milars-z/Real-Time-Embedded-Programming/hardware/cad/README.md

# 3D Printing Integration

## Overview
This folder contains documentation for the 3D printing and hardware integration part of our real-time embedded programming project.

## Responsibility
Responsible team member: Dingyan Guo

My contribution includes:
- selecting a suitable open-source 3D model
- preparing the model for printing
- printing the required parts
- testing fitting and assembly

## Important Note
The robot arm model used in this project is based on the open-source **EEZYbotARM Mk2** project.
It is not claimed as original CAD work by our team.
Please see `SOURCE.md` for attribution details.

STL files are stored in `hardware/STL/`, and 3MF files are stored in `hardware/3mf/`.

## Folder Contents
- `README.md` — overview of the 3D printing integration work
- `SOURCE.md` — source and attribution details
