milars-z/Real-Time-Embedded-Programming/src/CameraYolo/readme.md

## Test
Use *.exe test CameraTest\test.jpg CameraTest\yolov8n.onnx CameraTest\classes.txt to test the program with a single picture.
has different modes : test/camera/video.
video/camera haven't been tested.

## V2.0
YOLO version occupies too much memory, temporarily abandoned
YoloDetector.cpp
YoloDetector.h
model/yolov8n.onnx
model/yolov8n.pt
model/classes.txt
