milars-z/Real-Time-Embedded-Programming/hardware/cad/SOURCE.md

# Source Attribution

This project uses the open-source **EEZYbotARM Mk2** model as part of the hardware implementation.

## Original Source
- Project name: EEZYbotARM Mk2 - 3D Printed Robot
- Source page: https://www.instructables.com/EEZYbotARM-Mk2-3D-Printed-Robot/
- Original creator: theGHIZmo / daGHIZmo
- Original platform: Thingiverse
- Licence: CC BY-NC
- Attribution note: please follow the original licence and provide attribution

## Use in This Project
This model is not claimed as original modelling work by our team.
It is used for educational and non-commercial coursework purposes.

## My Contribution
My work in this part included:
- sourcing and evaluating the open-source model
- preparing files for printing
- carrying out 3D printing
- checking fitting and assembly
- documenting the use of the model in the project
