milars-z/Real-Time-Embedded-Programming/docs/IK/Inverse motion algorithm.docx

1) Assumed Robot Arm Type (Most Common 4‑DOF Layout)

This document assumes a very common 4‑DOF serial arm used in many 3D‑printed projects:
• Motor 1: Base rotation (Yaw)
• Motor 2: Shoulder joint (Pitch)
• Motor 3: Elbow joint (Pitch)
• Motor 4: Wrist joint (Pitch) to control the end‑effector tilt

The usual IK trick is to split 3D into:
• A base yaw angle θ1 (turn toward the target in the XY plane)
• A 2D planar IK problem in a vertical plane (r–z plane) for θ2 and θ3
• A wrist angle θ4 to achieve the desired tool pitch

2) Required Geometry Parameters (Measure or Take from CAD)

Define the target point in the base coordinate frame as P = (x, y, z).

You need these arm parameters:
• d0: vertical offset from base origin to the shoulder axis (height)
• a0: horizontal offset from base rotation axis to shoulder axis (often 0)
• L1: length from shoulder → elbow
• L2: length from elbow → wrist
• L3: length from wrist → tool tip (tool offset). If the tool tip is at the wrist axis, L3 = 0.

Optional (orientation): choose an end‑effector pitch angle φ in the arm’s vertical plane.
If you only need to reach the point (no orientation control), you can set φ to a constant (e.g., keep the tool level).

3) Step‑by‑Step IK (Equations)

3.1 Base yaw (Motor 1)

Compute base rotation so the arm faces the target:
θ1 = atan2(y, x)

Horizontal distance to the target:
r = sqrt(x^2 + y^2)

Convert to shoulder‑frame distances (accounting for offsets):
rs = r − a0
zs = z − d0

3.2 Wrist center (optional, if tool length L3 and desired pitch φ)

If the tool tip is offset from the wrist by L3 and you want pitch φ, solve for the wrist center:
rw = rs − L3·cos(φ)
zw = zs − L3·sin(φ)

If L3 = 0 or orientation is ignored, use:
rw = rs, zw = zs

3.3 Shoulder + elbow (Motors 2 and 3): 2‑link planar IK in the r–z plane

Compute:
D = (rw^2 + zw^2 − L1^2 − L2^2) / (2·L1·L2)

Reachability check:
If |D| > 1, the target is unreachable for the given link lengths (too far or too close).

Elbow angle (two solutions: elbow‑down vs elbow‑up):
θ3 = atan2( ±sqrt(1 − D^2), D )

Shoulder angle:
θ2 = atan2(zw, rw) − atan2( L2·sin(θ3), L1 + L2·cos(θ3) )

3.4 Wrist pitch (Motor 4)

If you want the end‑effector pitch to be φ:
θ4 = φ − (θ2 + θ3)

If you do not control orientation, θ4 can be fixed or used for a simple “keep level” rule.

4) Practical Implementation Notes (Real Robots)

1) Angle directions and zero offsets differ per build.
A typical conversion is: θ_motor = s·θ + θ_offset, where s is +1 or −1.

2) Joint limits: reject or clamp solutions that exceed servo/motor limits.

3) Elbow‑up vs elbow‑down: compute both (±) solutions and choose the one that:
• stays within joint limits, and/or
• requires the smallest change from the current joint angles.

4) Units: IK uses radians. Convert to degrees if your motor commands use degrees:
degrees = radians · (180 / π)

5) Minimal Pseudocode

Inputs: x,y,z, link lengths d0,a0,L1,L2,L3, desired pitch phi

theta1 = atan2(y, x)
r = sqrt(x^2 + y^2)
rs = r - a0
zs = z - d0

rw = rs - L3*cos(phi)
zw = zs - L3*sin(phi)

D = (rw^2 + zw^2 - L1^2 - L2^2) / (2*L1*L2)
if abs(D) > 1: unreachable

theta3 = atan2(+sqrt(1-D^2), D) # elbow-down (also try -sqrt for elbow-up)
theta2 = atan2(zw, rw) - atan2(L2*sin(theta3), L1 + L2*cos(theta3))

theta4 = phi - (theta2 + theta3)

return theta1, theta2, theta3, theta4
