milars-z/Real-Time-Embedded-Programming/docs/pitch_presentation/pitch_real.pptx

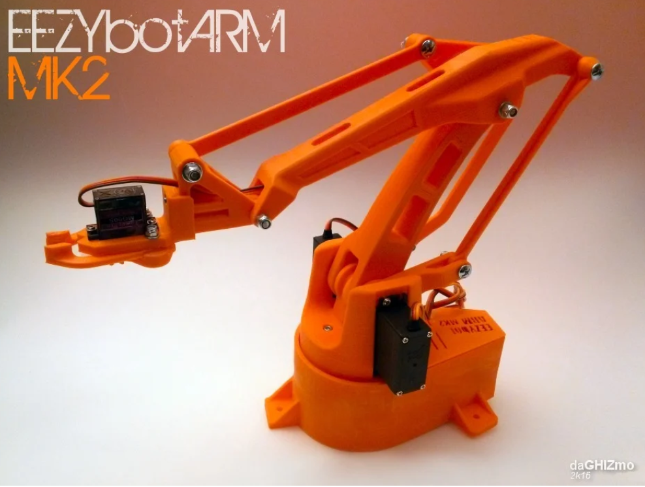
[picture p10: figure]

Computer Vision for object learning and retrieval

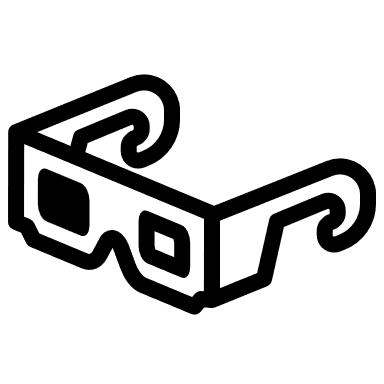
[picture p11: figure]
3D 眼镜 纯色填充

Voice Recognition for user commands

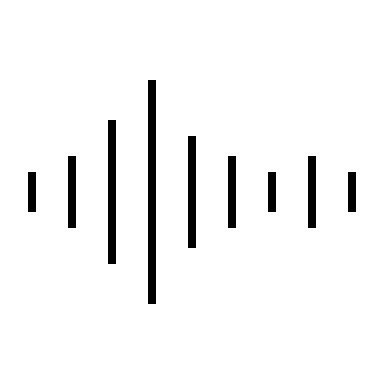
[picture p12: figure]
语音 轮廓

AI Engine for feature extraction

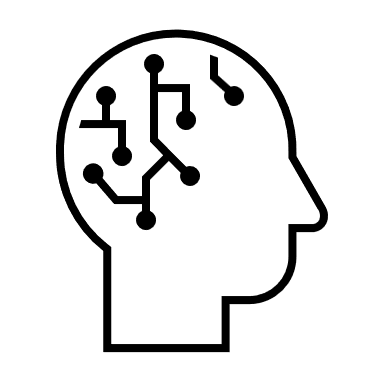
[picture p13: figure]
人工智能 轮廓

File System for learning

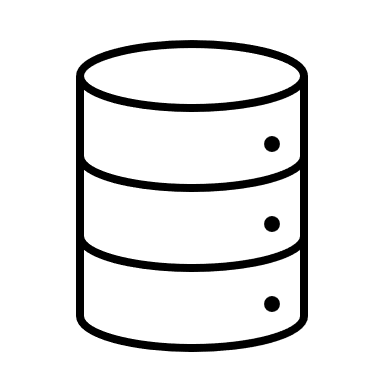
[picture p14: figure]
数据库 轮廓

Team 19

CogniArm

Ziyin Zeng(3113788Z) Shantong Wang(3108877W) Longyi Chen(3169503C) Dingyan Guo(3075250G)
Hang Liu(3075147L)

## Slide 2

Real-time system

Multithread

Hardware Control

Vision|Voice

SQL | Knowledge

…..

CogniArm: Evolution from Control to Cognition

Stage 1. Traditional motion

C++ Real-time Kernel & IK

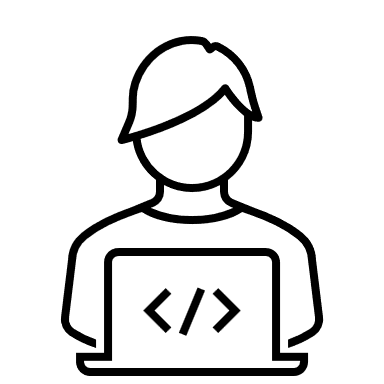
[picture p15: figure]
男程序员 轮廓

Stage 2. Intelligent Interaction

Async Voice Command Processing

Stage 3. Cognitive Perception

Vision-Voice & Learning

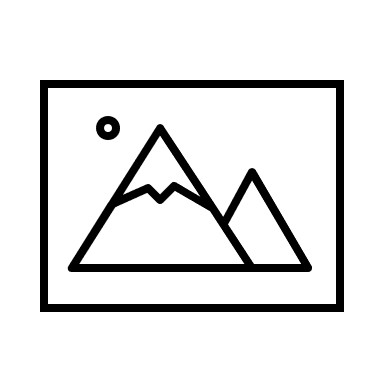
[picture p16: figure]
图像 轮廓
