milars-z/Real-Time-Embedded-Programming/docs/Project_Planning/CogniArm _Project_Analysis.docx

CogniArm: A Learnable Robotic Arm System

This project focuses on the research and design of a learnable robotic arm.

System Architecture:

Vision Module: Identifies image features.

Speech Recognition Module: Recognizes user commands and extracts keywords to generate mechanical instructions or initiate visual searches.

File Management Module: Saves and manages pre-stored information groups.

AI Module: Assists vision and speech modules as a feature extraction engine.

Control Module: Responsible for robotic arm control.

Stage 1 (01/28 – 02/15)

3D print and assemble the robotic arm demo; ensure it can be moved manually.

Reference:

EEZYbotARM Mk2 - 3D Printed Robot : 8 Steps (with Pictures) - Instructables (https://www.instructables.com/EEZYbotARM-Mk2-3D-Printed-Robot/)

EEZYbotARM MK2 by daGHIZmo - Thingiverse (https://www.thingiverse.com/thing:1454048)

Implement robotic arm simulation via QT or other software (Python) to execute various movements through commands.

Basic embedded thread control and Raspberry Pi GPIO control.

Basic speech recognition: Convert speech to text vectors and extract keywords.

Basic image recognition: Provide data on recognition accuracy and minimum blurriness to ensure object matching.

Stage 2 (02/23 – 03/09)

Embedded deployment: Control the robotic arm via PC for directional movement and object grasping, with synchronous display in QT simulation.

Coordinate transformation and Inverse Kinematics (IK) processing.

Stage 3 (03/10 – 04/03)

Modify and re-print 3D models (Optional).

Voice recognition deployment: Control the robotic arm via voice commands for directional movement and object grasping, with synchronous display in QT simulation.

Image recognition deployment: Identify primary objects on the desk and match them with existing image data.

Stage 4

Learning deployment: Expand the file system, implement keyword retrieval and image vector storage.

Key Milestones:

Before Lunar New Year: Complete demo testing to ensure physical movement.

Early March: Complete embedded deployment to ensure standalone control without a PC.

Early April: Complete deployment of speech and image recognition.

Final Phase:

Focus on bug fixes, accuracy improvement, code standardization, and GitHub repository refinement. Concurrently conduct thesis writing. Synchronize DevLogs for each stage.

(Stage 4 development can be handled separately).
