milars-z/Real-Time-Embedded-Programming/docs/Project_Planning/CogniArm _项目分析.docx

CogniArm (认知手臂)

该项目主要研究并设计了一款可学习的机械臂

该项目文件组成为：视觉模块，语音识别模块，文件管理模块，AI模块与控制模块

语音识别模块主要用来识别用户指令，收集关键词生成机械指令或进行视觉检索。

视觉模块主要识别图像特征。学习模式需确定中心物品特征并保存到文件系统；识别模式需根据文件系统中存储的信息向量与图像中的物品信息向量进行匹配。

文件管理模块用来保存管理各种预存信息组。

AI模块辅助视觉与语音模块，进行特征提取引擎。

控制模块主要负责机械臂控制。

Stage 1. （01/28 – 02/15）

3D打印机械臂demo，完成组装，能用手移动机械臂

EEZYbotARM Mk2 - 3D Printed Robot : 8 Steps (with Pictures) - Instructables (https://www.instructables.com/EEZYbotARM-Mk2-3D-Printed-Robot/)

EEZYbotARM MK2 by daGHIZmo - Thingiverse (https://www.thingiverse.com/thing:1454048)

QT或其他模拟软件（python）实现机械臂仿真，通过指令实现机械臂各种动作

基础嵌入式线程控制，控制树莓派上的任意GPIO

基础语音识别，成功将语音转换为文字向量输出并提取关键词

基础图像识别，提供基础识别精准度，最低模糊度等数据，确保能进行物品识别匹配

Stage 2. （02/23 – 03/09）

嵌入式部署，可以通过PC段输出指令控制机械臂定向移动并进行物品抓取，QT模拟同步显示

坐标转换，逆运动学处理

Stage3. （03/10-04/03）

根据需求修改3D模型（选做）并重新打印

语音识别部署，通过语音指令控制机械臂定向移动并进行物品抓取，QT模拟同步显示

图像识别部署，摄像头能够判断桌面的主要物品，且能匹配已有的图像数据

Stage4.

学习部署，扩展文件系统，关键词检索，图像向量存储等

项目重要节点：

1. 年前完成demo的测试，确保实物能正常运动

2. 3月初完成嵌入式部署，确保能够脱离pc对机械臂进行操控

3. 4月初完成语音与图像识别部署

项目末期主要以完善bug，增加准确性，代码规范，github页面整改为主，同步进行论文撰写，stage4的开发可以忽略

每一阶段通过自媒体视频记录进度
