milars-z/Real-Time-Embedded-Programming/docs/hardware_config/hardware.xlsx

Sheet: Pinout
https://www.raspberrypi.com/documentation/computers/raspberry-pi.html#gpio

Sheet: MG90S
Orange | PWM | GPIO12
Red | 5V
Brown | GND

Sheet: 9865
GND | 6
SCL | 5 | GPIO3
SDA | 3 | GPIO2
VCC | 1 | 3.3V
