milars-z/Real-Time-Embedded-Programming/hardware/3mf/EBAmk2_002_mainarm.3mf

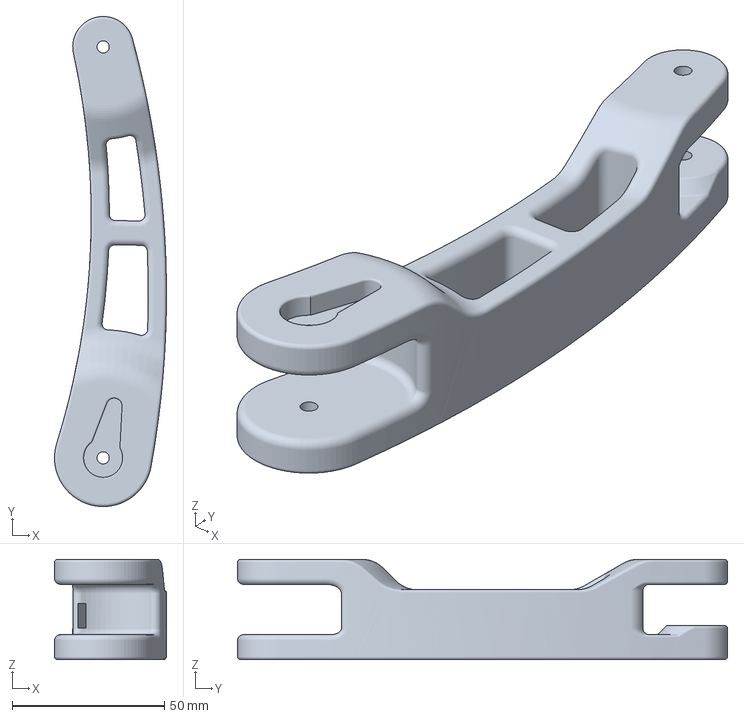
[picture p17: CAD file, 2026-04-19]
hardware/3mf/EBAmk2_002_mainarm.3mf
36.8 x 161.0 x 33.0 mm
