milars-z/Real-Time-Embedded-Programming/hardware/3mf/EBAmk2_012_mainbase.3mf

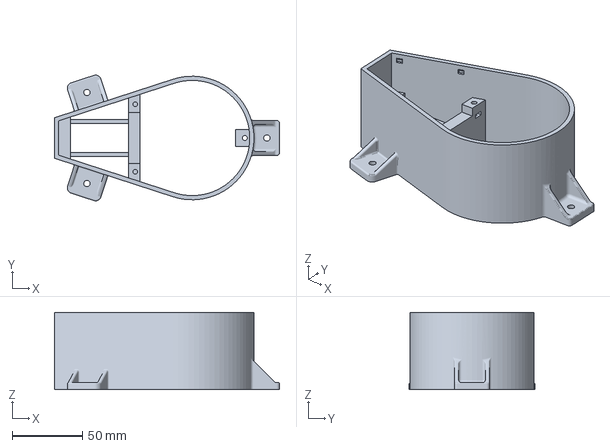
[picture p18: CAD file, 2026-04-19]
hardware/3mf/EBAmk2_012_mainbase.3mf
160.2 x 89.5 x 55.0 mm
