milars-z/Real-Time-Embedded-Programming/hardware/3mf/EBAmk2_011_gearmast_full.3mf

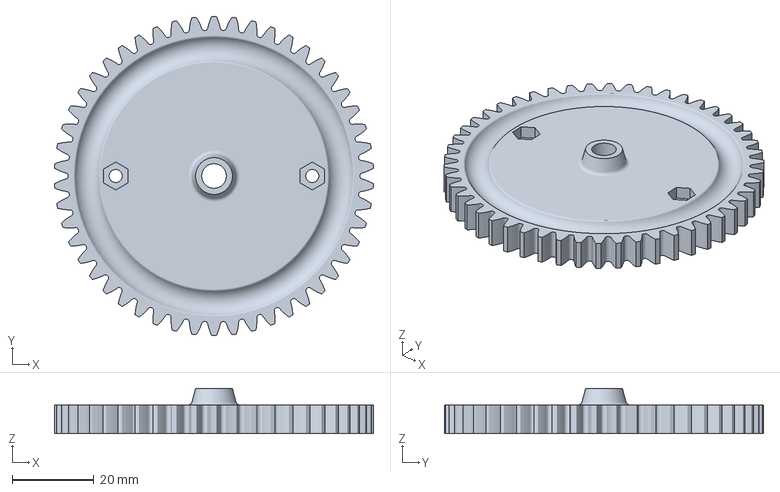
[picture p19: CAD file, 2026-04-19]
hardware/3mf/EBAmk2_011_gearmast_full.3mf
77.9 x 78.0 x 11.0 mm
