milars-z/Real-Time-Embedded-Programming/hardware/3mf/EBAmk2_010_gearservo_22DENTI.3mf

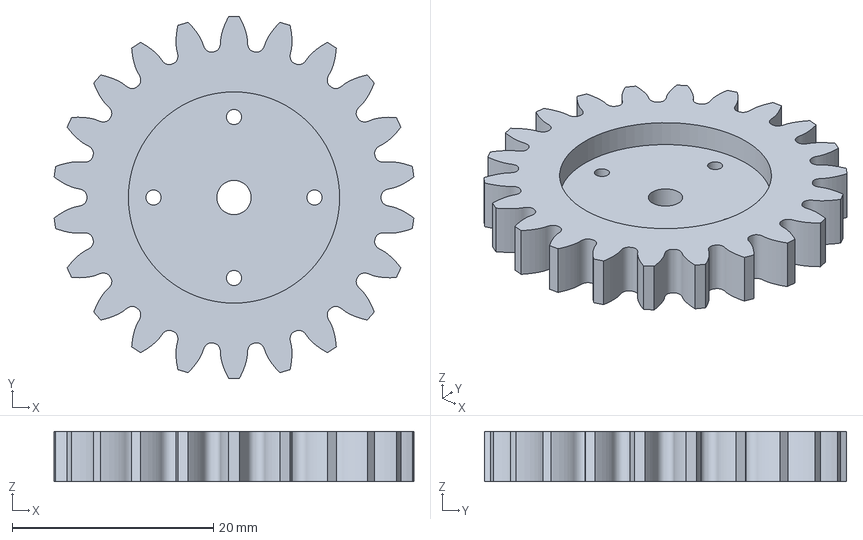
[picture p20: CAD file, 2026-04-19]
hardware/3mf/EBAmk2_010_gearservo_22DENTI.3mf
35.8 x 36.0 x 5.00 mm
