milars-z/Real-Time-Embedded-Programming/hardware/_3mf/EBAmk2.3mf

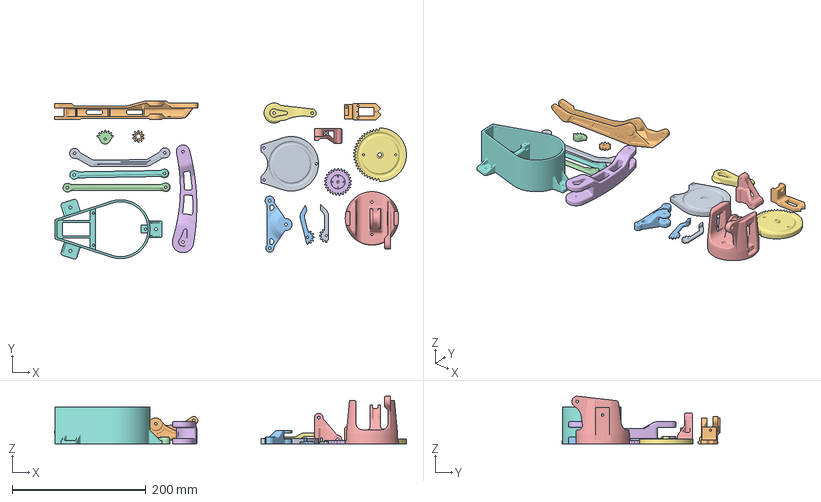
[picture p21: CAD file, 2026-04-20]
hardware/_3mf/EBAmk2.3mf
526.1 x 236.6 x 71.2 mm
EBAmk2_015_claw_finger_dx.STL
EBAmk2_016_claw_gear_drive.STL
EBAmk2_017_claw_finger_sx.STL
EBAmk2_018_claw_gear_driven.STL
EBAmk2_001_base.STL
EBAmk2_002_mainarm.STL
EBAmk2_003_varm.STL
EBAmk2_004_link135.STL
EBAmk2_005_link135angled.STL
EBAmk2_006_horarm__.STL
EBAmk2_007_trialink.STL
EBAmk2_008_link147_new.STL
EBAmk2_009_trialinkfront.STL
EBAmk2_010_gearservo.STL
EBAmk2_011_gearmast.STL
EBAmk2_012_mainbase.STL
EBAmk2_013_lower_base.STL
EBAmk2_014_claw_base.STL
