milars-z/Real-Time-Embedded-Programming/hardware/3mf/EBAmk2_006_horarm__.3mf

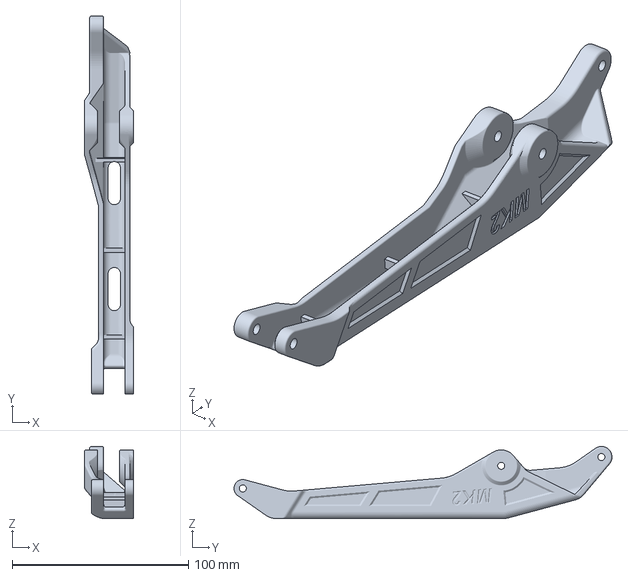
[picture p22: CAD file, 2026-04-19]
hardware/3mf/EBAmk2_006_horarm__.3mf
28.0 x 214.2 x 40.9 mm
