milars-z/Real-Time-Embedded-Programming/hardware/3mf/EBAmk2_004_link135.3mf

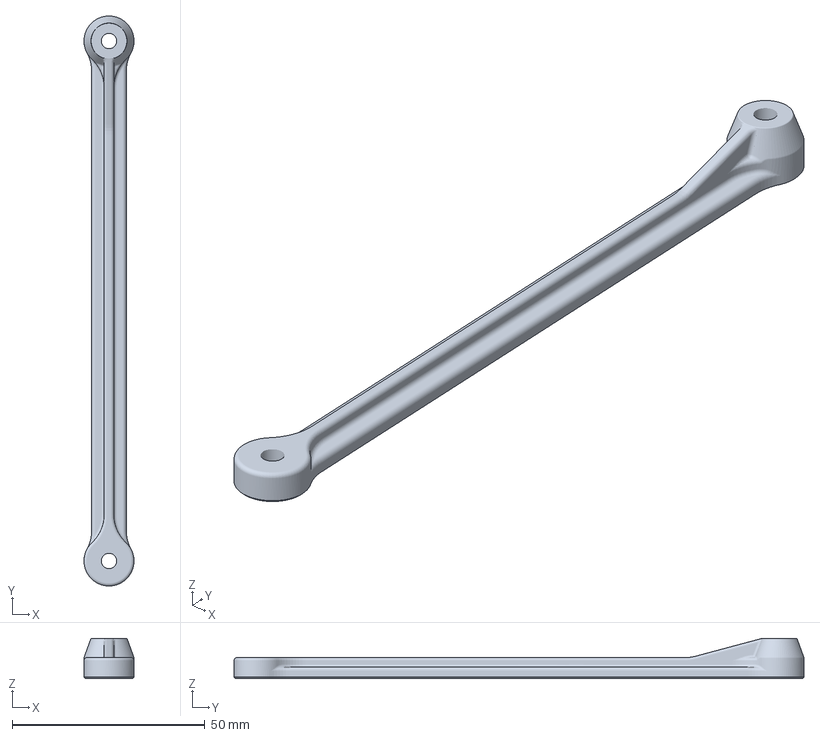
[picture p23: CAD file, 2026-04-19]
hardware/3mf/EBAmk2_004_link135.3mf
13.0 x 148.0 x 10.5 mm
