milars-z/Real-Time-Embedded-Programming/hardware/3mf/EBAmk2_001_base.3mf

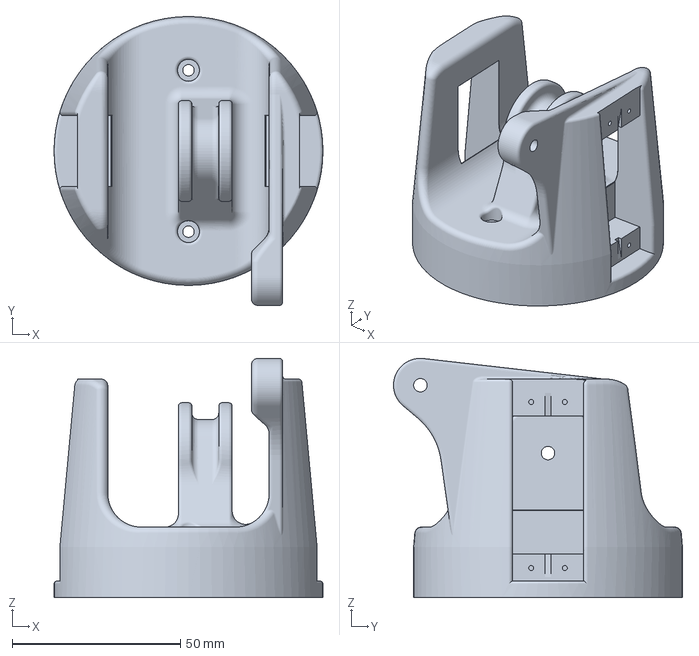
[picture p24: CAD file, 2026-04-19]
hardware/3mf/EBAmk2_001_base.3mf
80.0 x 86.0 x 71.2 mm
