milars-z/Real-Time-Embedded-Programming/hardware/3mf/EBAmk2_008_link147_new.3mf

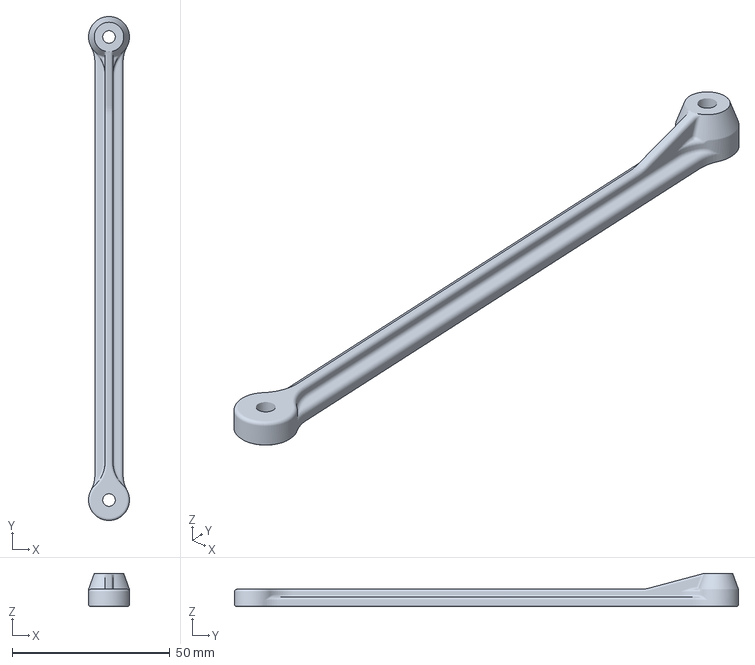
[picture p25: CAD file, 2026-04-19]
hardware/3mf/EBAmk2_008_link147_new.3mf
13.0 x 160.0 x 10.5 mm
