milars-z/Real-Time-Embedded-Programming/hardware/3mf/EBAmk2_013_lower_base.3mf

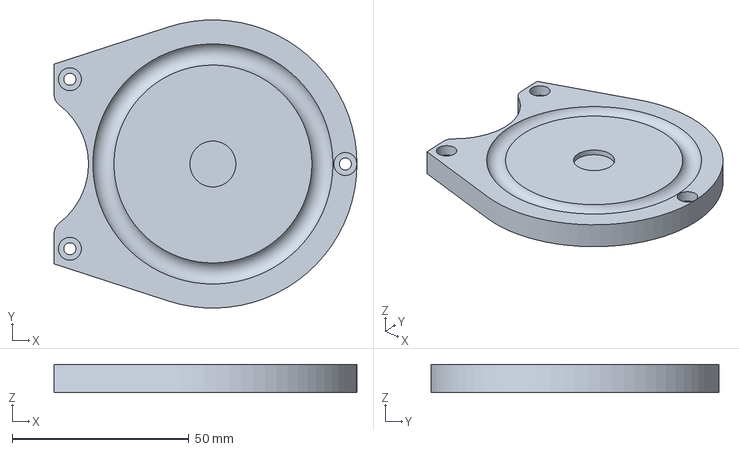
[picture p26: CAD file, 2026-04-19]
hardware/3mf/EBAmk2_013_lower_base.3mf
85.8 x 81.6 x 8.00 mm
