milars-z/Real-Time-Embedded-Programming/hardware/3mf/EBAmk2_006_horarm_plate.3mf

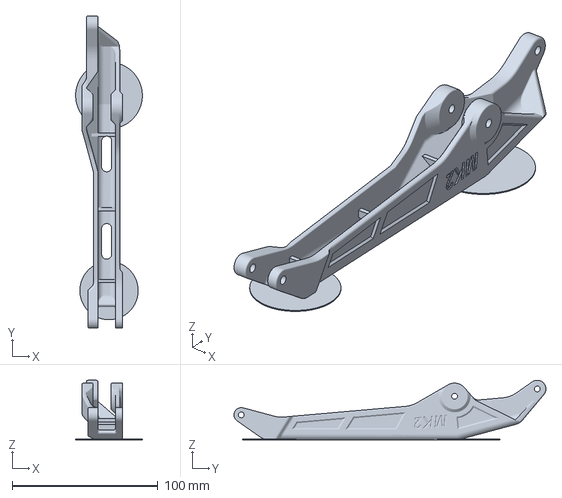
[picture p27: CAD file, 2026-04-19]
hardware/3mf/EBAmk2_006_horarm_plate.3mf
45.8 x 214.2 x 40.9 mm
