milars-z/Real-Time-Embedded-Programming/hardware/3mf/EBAmk2_019_drive_cover.3mf

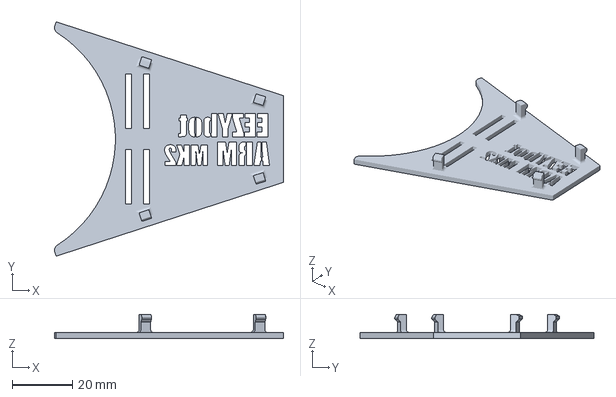
[picture p28: CAD file, 2026-04-19]
hardware/3mf/EBAmk2_019_drive_cover.3mf
76.3 x 78.1 x 8.00 mm
