milars-z/Real-Time-Embedded-Programming/hardware/3mf/EBAmk2_017_claw_finger_sx.3mf

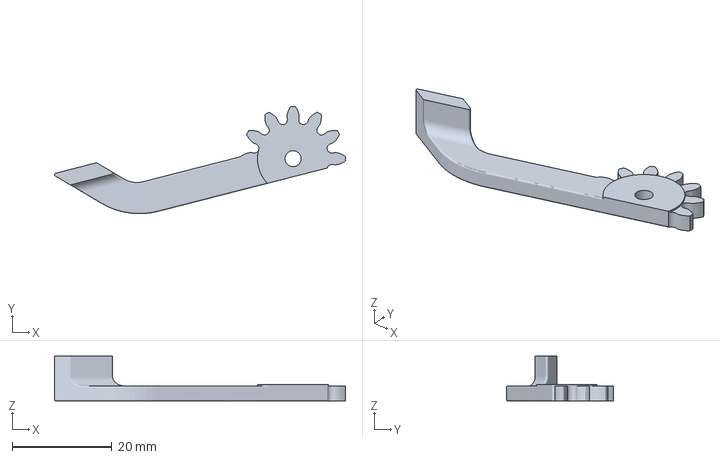
[picture p29: CAD file, 2026-04-19]
hardware/3mf/EBAmk2_017_claw_finger_sx.3mf
58.3 x 21.5 x 9.00 mm
