milars-z/Real-Time-Embedded-Programming/hardware/3mf/EBAmk2_009_trialinkfront.3mf

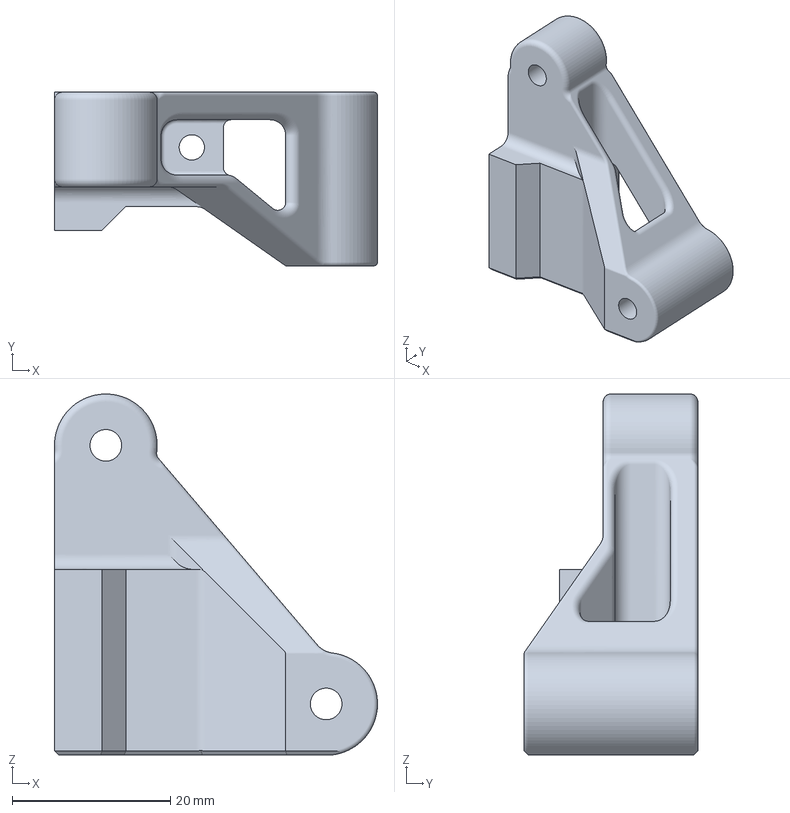
[picture p30: CAD file, 2026-04-19]
hardware/3mf/EBAmk2_009_trialinkfront.3mf
40.9 x 22.0 x 45.7 mm
