milars-z/Real-Time-Embedded-Programming/hardware/3mf/EBAmk2_005_link135angled.3mf

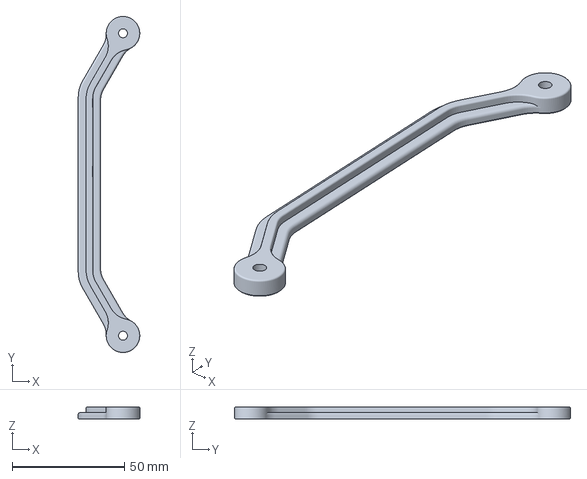
[picture p31: CAD file, 2026-04-19]
hardware/3mf/EBAmk2_005_link135angled.3mf
27.5 x 150.0 x 5.50 mm
