milars-z/Real-Time-Embedded-Programming/hardware/3mf/EBAmk2_015_claw_finger_dx.3mf

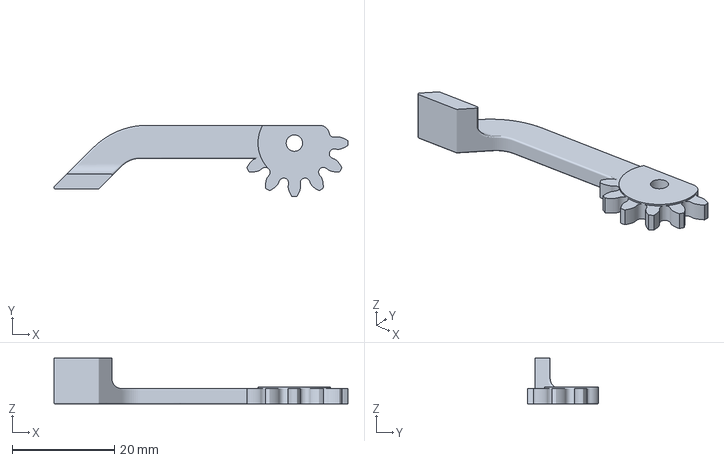
[picture p32: CAD file, 2026-04-19]
hardware/3mf/EBAmk2_015_claw_finger_dx.3mf
57.6 x 14.0 x 9.00 mm
