milars-z/Real-Time-Embedded-Programming/hardware/3mf/EBAmk2_003_varm.3mf

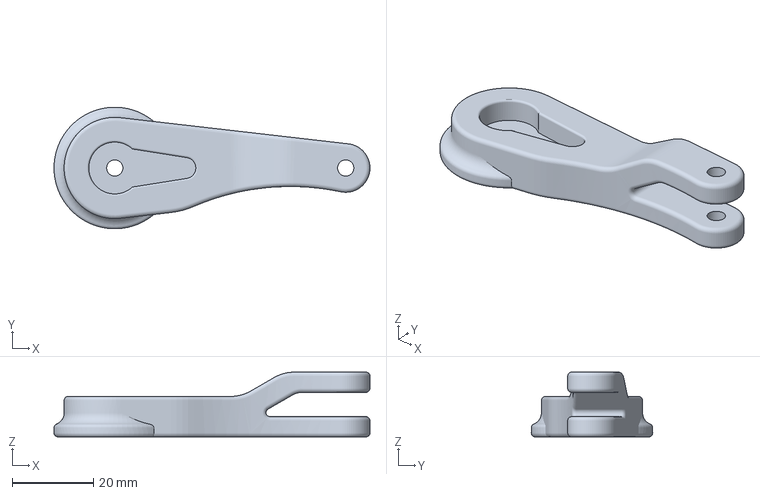
[picture p33: CAD file, 2026-04-19]
hardware/3mf/EBAmk2_003_varm.3mf
78.0 x 30.0 x 16.0 mm
