milars-z/Real-Time-Embedded-Programming/hardware/3mf/EBAmk2_007_trialink.3mf

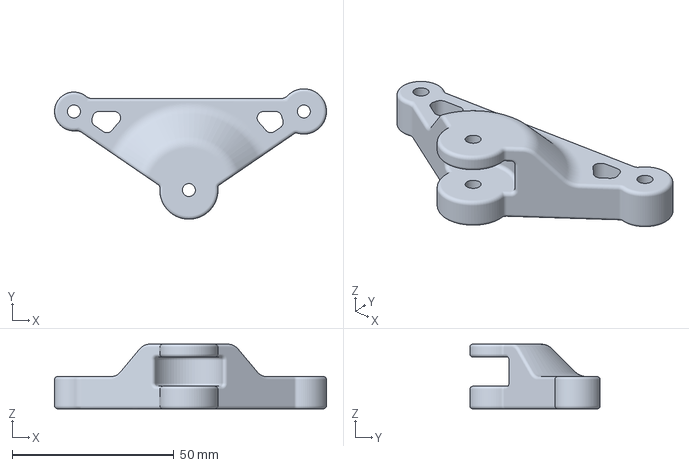
[picture p34: CAD file, 2026-04-19]
hardware/3mf/EBAmk2_007_trialink.3mf
84.0 x 40.3 x 20.0 mm
