milars-z/Real-Time-Embedded-Programming/hardware/3mf/EBAmk2_011_gearmast.3mf

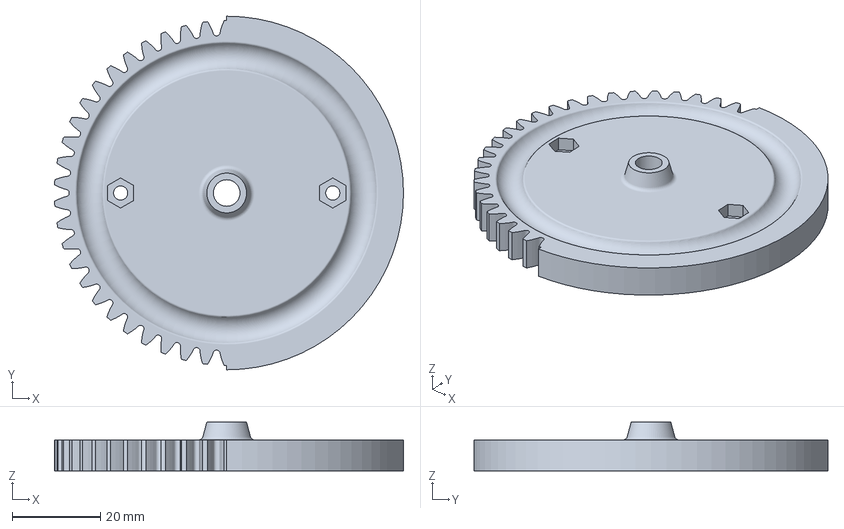
[picture p35: CAD file, 2026-04-19]
hardware/3mf/EBAmk2_011_gearmast.3mf
79.0 x 80.0 x 11.0 mm
