milars-z/Real-Time-Embedded-Programming/hardware/3mf/EBAmk2_010_gearservo.3mf

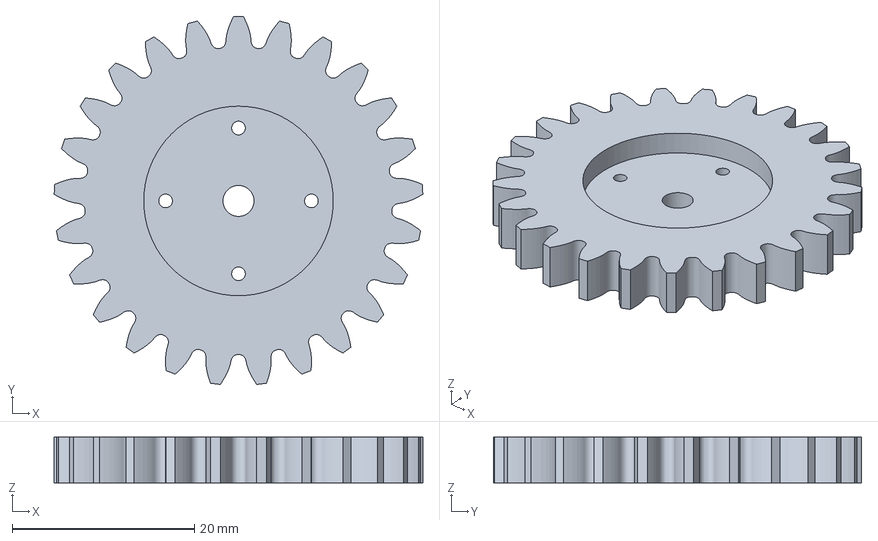
[picture p36: CAD file, 2026-04-19]
hardware/3mf/EBAmk2_010_gearservo.3mf
40.5 x 40.4 x 5.00 mm
