milars-z/Real-Time-Embedded-Programming/hardware/3mf/EBAmk2_016_claw_gear_drive.3mf

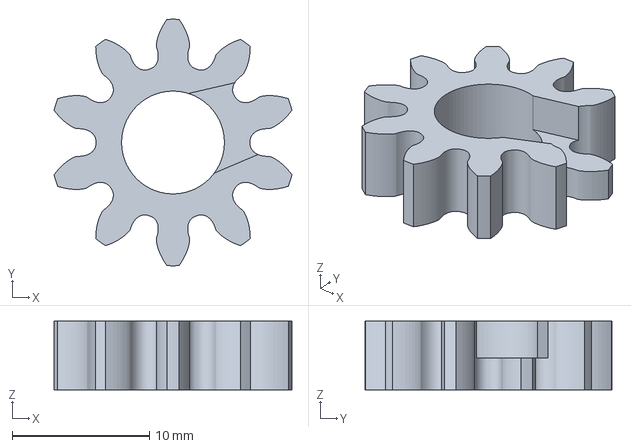
[picture p37: CAD file, 2026-04-19]
hardware/3mf/EBAmk2_016_claw_gear_drive.3mf
17.4 x 18.0 x 5.00 mm
