milars-z/Real-Time-Embedded-Programming/hardware/3mf/EBAmk2_018_claw_gear_driven.3mf

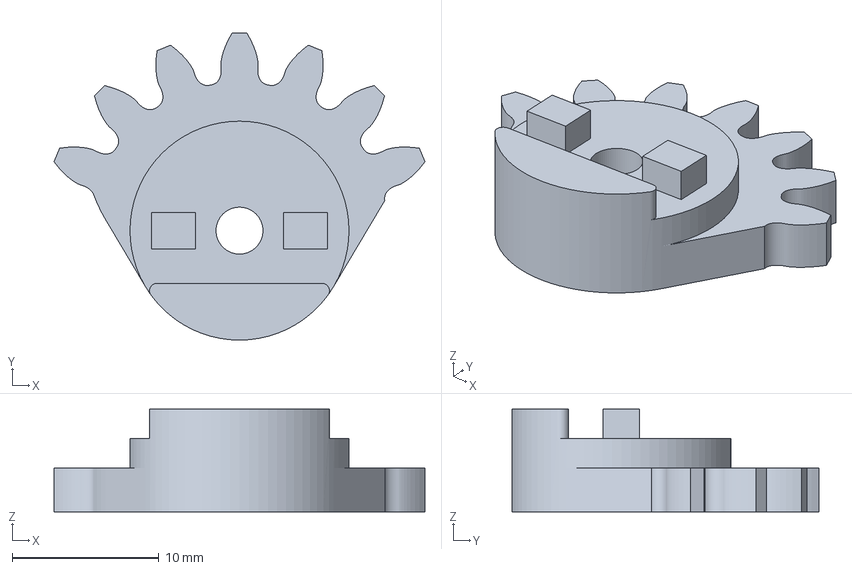
[picture p38: CAD file, 2026-04-19]
hardware/3mf/EBAmk2_018_claw_gear_driven.3mf
25.3 x 21.0 x 7.00 mm
