milars-z/Real-Time-Embedded-Programming/hardware/3mf/EBAmk2_014_claw_base.3mf

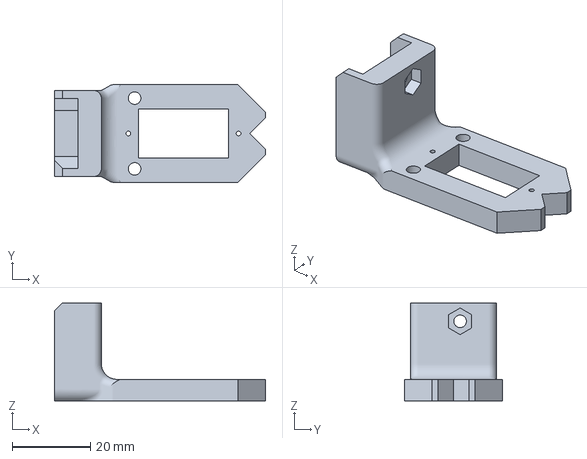
[picture p39: CAD file, 2026-04-19]
hardware/3mf/EBAmk2_014_claw_base.3mf
54.0 x 25.0 x 25.0 mm
