milars-z/Real-Time-Embedded-Programming/docs/test_data/speaker_test.txt

hello
hello
hello
what is your name
hello i am your robots
hello i am your robots
hello i am your robots
today is sunday
do motion hello
hello good morning milars
hello good morning milars
hello good morning milars
hello good morning milars
hello good morning milars
hello good morning milars
please update background first
please update background first
please update background first
background update successfully
background update successfully
background update successfully
learn object can successfully
learn object can successfully
learn object can successfully
learn object can successfully
learn object can successfully
learn object can successfully
i know how to dance
i know how to dance
i know how to hello
i know how to hello
i know how to fly
good bye milars
good bye milars
good bye milars
sorry i didn't understand that
sorry i didn't understand that
sorry i didn't understand that
sorry i didn't understand that
sorry i didn't understand that
sorry i didn't understand that
hello
hello
hello
what is your name
hello i am your robots
hello i am your robots
hello i am your robots
today is sunday
do motion hello
hello good morning milars
hello good morning milars
hello good morning milars
hello good morning milars
hello good morning milars
hello good morning milars
please update background first
please update background first
please update background first
background update successfully
background update successfully
background update successfully
learn object can successfully
learn object can successfully
learn object can successfully
learn object can successfully
learn object can successfully
learn object can successfully
i know how to dance
i know how to dance
i know how to hello
i know how to hello
i know how to fly
good bye milars
good bye milars
good bye milars
sorry i didn't understand that
sorry i didn't understand that
sorry i didn't understand that
sorry i didn't understand that
sorry i didn't understand that
sorry i didn't understand that
hello
hello
hello
what is your name
hello i am your robots
hello i am your robots
hello i am your robots
today is sunday
do motion hello
hello good morning milars
hello good morning milars
hello good morning milars
hello good morning milars
hello good morning milars
hello good morning milars
please update background first
please update background first
please update background first
background update successfully
background update successfully
background update successfully
learn object can successfully
learn object can successfully
learn object can successfully
learn object can successfully
learn object can successfully
learn object can successfully
i know how to dance
i know how to dance
i know how to hello
i know how to hello
i know how to fly
good bye milars
good bye milars
good bye milars
sorry i didn't understand that
sorry i didn't understand that
sorry i didn't understand that
sorry i didn't understand that
sorry i didn't understand that
sorry i didn't understand that
