milars-z/Real-Time-Embedded-Programming/docs/test_data/Analysis.xlsx

Sheet: 2026-04-15
TaskID | Module | Type | TargetName | Duration(ms) | issuccess | Module | Average Duration | Peak Duration | P90 | Sample Count | Shortest Duration
1000 | Camera | Update | None | 48.62 |  | Camera | 35.12214815 | 60.99 | 52.082
1001 | Camera | Learn | ll | 60.99 |  | STT | 12.89689706 | 49.406 | 27.482
1002 | Camera | Detecte | ll | 49.96 |  | TTS | 988.8116181 | 21541.443 | 1263.5207 | 254 | 381.02
1003 | Camera | Detecte | ll | 39.27 |  | Screen-Motion | 64.41575758 | 72.281 | 67.7795
1004 | Camera | Detecte | oo | 48.09 |  | Nlu | 173.2652905 | 7062.549 | 80.1568
1000 | Camera | Update | None | 57.91
1001 | Camera | Update | None | 28.382
1002 | Camera | Update | None | 27.925
1003 | Camera | Learn | yy | 55.265
1004 | Camera | Learn | yy | 29.616
1005 | Camera | Detecte | yy | 26.981
1006 | Camera | Detecte | yy | 30.372
1007 | Camera | Detecte | yy | 28.96
1008 | Camera | Detecte | yy | 31.732
1009 | Camera | Detecte | yy | 30.895
1010 | Camera | Detecte | yy | 26.257
1011 | Camera | Detecte | yy | 30.252
1012 | Camera | Detecte | yy | 32.04
1013 | Camera | Detecte | yy | 27.314
1014 | Camera | Detecte | yy | 31.079
1000 | Camera | Update | None | 26.853 | 1
1001 | Camera | Detecte | uu | 33.148 | 0
1002 | Camera | Detecte | uu | 31.796 | 0
1003 | Camera | Update | None | 25.967 | 1
1004 | Camera | Detecte | uu | 28.46 | 1
1005 | Camera | Learn | gg | 27.483 | 1
1006 | Camera | Detecte | gg | 32.681 | 1
4002 | Microphone | STT | hello | 49.406 | 1
4820 | Microphone | STT | you in system | 48.336 | 1
4146 | Microphone | STT | you that she was his movies | 40.211 | 1
4319 | Microphone | STT | maggie | 32.214 | 1
4688 | Microphone | STT | yeah | 30.478 | 1
4012 | Microphone | STT | she was | 29.74 | 1
4440 | Microphone | STT | that's right before | 27.601 | 1
4016 | Microphone | STT | some bitterness | 27.431 | 1
4674 | Microphone | STT | guy | 26.797 | 1
4147 | Microphone | STT | the soon | 26.558 | 1
4045 | Microphone | STT | me | 26.51 | 1
4682 | Microphone | STT | man | 25.939 | 1
4196 | Microphone | STT | years | 25.914 | 1
4704 | Microphone | STT | yes | 24.972 | 1
4534 | Microphone | STT | yeah | 24.707 | 1
4168 | Microphone | STT | and | 24.359 | 1
4180 | Microphone | STT | the | 23.989 | 1
4006 | Microphone | STT | yeah | 22.27 | 1
4153 | Microphone | STT | the | 22.095 | 1
4093 | Microphone | STT | stop | 20.878 | 1
4127 | Microphone | STT | for | 19.16 | 1
4040 | Microphone | STT | amy | 18.485 | 1
4090 | Microphone | STT | the | 16.774 | 1
4237 | Microphone | STT | still | 15.011 | 1
4155 | Microphone | STT | the | 14.757 | 1
4022 | Microphone | STT | grab one | 14.33 | 1
4004 | Microphone | STT | are | 13.276 | 1
4060 | Microphone | STT | promotion towns | 10.958 | 1
4011 | Microphone | STT | this | 9.375 | 1
4044 | Microphone | STT | he | 9.344 | 1
4025 | Microphone | STT | so my name | 8.999 | 1
4012 | Microphone | STT | hello hello | 8.279 | 1
4434 | Microphone | STT | hello | 7.956 | 1
4012 | Microphone | STT | hello | 7.804 | 1
4006 | Microphone | STT | hello hello | 7.472 | 1
4149 | Microphone | STT | there's still time to | 7.083 | 1
4079 | Microphone | STT | right | 6.958 | 1
4010 | Microphone | STT | hello hello | 6.022 | 1
4014 | Microphone | STT | hello | 6.014 | 1
4603 | Microphone | STT | oh | 5.986 | 1
4013 | Microphone | STT | hello | 5.339 | 1
4017 | Microphone | STT | goodbye | 5.235 | 1
4001 | Microphone | STT | what's your name | 4.832 | 1
4007 | Microphone | STT | hello | 4.497 | 1
4019 | Microphone | STT | kobe | 4.25 | 1
4027 | Microphone | STT | what's your name | 4.14 | 1
4020 | Microphone | STT | goodbye | 4.008 | 1
4021 | Microphone | STT | good morning | 3.887 | 1
4007 | Microphone | STT | oh hello | 3.799 | 1
4010 | Microphone | STT | hello | 3.342 | 1
4023 | Microphone | STT | good afternoon | 3.299 | 1
4002 | Microphone | STT | can you do emotion dance | 3.089 | 1
4024 | Microphone | STT | good night | 2.896 | 1
4008 | Microphone | STT | oh | 2.883 | 1
4009 | Microphone | STT | hello | 2.843 | 1
4013 | Microphone | STT | hello hello | 2.83 | 1
4005 | Microphone | STT | oh hello | 2.79 | 1
4008 | Microphone | STT | hello hello | 2.647 | 1
4000 | Microphone | STT | hello | 2.301 | 1
4018 | Microphone | STT | grew by | 2.147 | 1
4015 | Microphone | STT | hello hello | 1.981 | 1
4016 | Microphone | STT | i | 1.7 | 1
4026 | Microphone | STT | say my name | 1.579 | 1
4014 | Microphone | STT | hello hello | 1.549 | 1
4015 | Microphone | STT | hello hello | 1.523 | 1
4011 | Microphone | STT | hello hello | 1.133 | 1
4009 | Microphone | STT | hello hello hello hello hello hello hello hello hello hello | 1.113 | 1
4011 | Microphone | STT | hello hello | 0.909 | 1
3001 | Nlu | nlu_analyez | also name | 58.407 | 0
3000 | Nlu | nlu_analyez | amy | 72.435 | 1
3004 | Nlu | nlu_analyez | and | 174.401 | 1
3000 | Nlu | nlu_analyez | are | 1572.384 | 1
3005 | Nlu | nlu_analyez | but | 75.807 | 1
3007 | Nlu | nlu_analyez | by | 61.656 | 0
3028 | Nlu | nlu_analyez | by | 59.001 | 0
3006 | Nlu | nlu_analyez | bye bye | 61.035
3003 | Nlu | nlu_analyez | bye bye | 60.16 | 1
3010 | Nlu | nlu_analyez | bye bye | 56.571 | 1
3042 | Nlu | nlu_analyez | can you dance | 52.4 | 1
3006 | Nlu | nlu_analyez | can you do a hello | 75.555 | 0
3002 | Nlu | nlu_analyez | can you do emotion dance | 53.632 | 1
3016 | Nlu | nlu_analyez | can you do emotion hello | 65.655 | 1
3009 | Nlu | nlu_analyez | can you do motion hello | 67.236 | 1
3041 | Nlu | nlu_analyez | densities | 63.011 | 0
3044 | Nlu | nlu_analyez | do motion hello | 75.669 | 1
3043 | Nlu | nlu_analyez | emotion hello | 59.947 | 0
3023 | Nlu | nlu_analyez | emotion hello | 55.017 | 0
3014 | Nlu | nlu_analyez | ever | 70.703 | 1
3003 | Nlu | nlu_analyez | for | 7062.549 | 0
3016 | Nlu | nlu_analyez | good afternoon | 259.517 | 1
3014 | Nlu | nlu_analyez | good morning | 58.539 | 1
3017 | Nlu | nlu_analyez | good night | 260.746 | 1
3010 | Nlu | nlu_analyez | goodbye | 75.765 | 1
3013 | Nlu | nlu_analyez | goodbye | 52.508 | 1
3015 | Nlu | nlu_analyez | grab one | 1570.058 | 0
3011 | Nlu | nlu_analyez | grew by | 61.732 | 0
3009 | Nlu | nlu_analyez | guy | 81.106 | 1
3036 | Nlu | nlu_analyez | he | 54.156 | 1
3000 | Nlu | nlu_analyez | hello | 69.128
3000 | Nlu | nlu_analyez | hello | 53.189
3000 | Nlu | nlu_analyez | hello | 50.998
3004 | Nlu | nlu_analyez | hello | 65.215
3005 | Nlu | nlu_analyez | hello | 56.48
3000 | Nlu | nlu_analyez | hello | 68.932 | 1
3004 | Nlu | nlu_analyez | hello | 51.417 | 1
3010 | Nlu | nlu_analyez | hello | 64.569 | 1
3013 | Nlu | nlu_analyez | hello | 67.386 | 1
3000 | Nlu | nlu_analyez | hello | 59.657 | 1
3000 | Nlu | nlu_analyez | hello | 61.527 | 1
3002 | Nlu | nlu_analyez | hello | 50.009 | 1
3000 | Nlu | nlu_analyez | hello | 57.94 | 1
3000 | Nlu | nlu_analyez | hello | 1337.424 | 1
3001 | Nlu | nlu_analyez | hello | 48.155 | 1
3002 | Nlu | nlu_analyez | hello | 48.716 | 1
3003 | Nlu | nlu_analyez | hello | 49.024 | 1
3004 | Nlu | nlu_analyez | hello | 48.479 | 1
3005 | Nlu | nlu_analyez | hello | 51.906 | 1
3006 | Nlu | nlu_analyez | hello | 63.008 | 1
3007 | Nlu | nlu_analyez | hello | 64.532 | 1
3008 | Nlu | nlu_analyez | hello | 74.859 | 1
3000 | Nlu | nlu_analyez | hello | 48.873 | 1
3001 | Nlu | nlu_analyez | hello | 60.034 | 1
3004 | Nlu | nlu_analyez | hello | 56.163 | 1
3005 | Nlu | nlu_analyez | hello | 64.847 | 1
3006 | Nlu | nlu_analyez | hello | 58.27 | 1
3007 | Nlu | nlu_analyez | hello | 73.228 | 1
3008 | Nlu | nlu_analyez | hello | 61.846 | 1
3009 | Nlu | nlu_analyez | hello | 64.721 | 1
3010 | Nlu | nlu_analyez | hello | 64.171 | 1
3011 | Nlu | nlu_analyez | hello | 59.243 | 1
3012 | Nlu | nlu_analyez | hello | 61.497 | 1
3014 | Nlu | nlu_analyez | hello | 59.512 | 1
3016 | Nlu | nlu_analyez | hello | 59.276 | 1
3017 | Nlu | nlu_analyez | hello | 60.967 | 1
3018 | Nlu | nlu_analyez | hello | 62.312 | 1
3000 | Nlu | nlu_analyez | hello | 51.433 | 1
3000 | Nlu | nlu_analyez | hello | 49.057 | 1
3001 | Nlu | nlu_analyez | hello | 49.177 | 1
3002 | Nlu | nlu_analyez | hello | 52.221 | 1
3000 | Nlu | nlu_analyez | hello | 59.363 | 1
3001 | Nlu | nlu_analyez | hello | 51.559 | 1
3002 | Nlu | nlu_analyez | hello | 65.371 | 1
3006 | Nlu | nlu_analyez | hello | 52.187 | 1
3007 | Nlu | nlu_analyez | hello | 51.939 | 1
3008 | Nlu | nlu_analyez | hello | 51.647 | 1
3009 | Nlu | nlu_analyez | hello | 51.73 | 1
3010 | Nlu | nlu_analyez | hello | 50.809 | 1
3011 | Nlu | nlu_analyez | hello | 51.302 | 1
3012 | Nlu | nlu_analyez | hello | 51.557 | 1
3013 | Nlu | nlu_analyez | hello | 53.331 | 1
3014 | Nlu | nlu_analyez | hello | 53.913 | 1
3000 | Nlu | nlu_analyez | hello | 60.275 | 1
3002 | Nlu | nlu_analyez | hello | 55.023 | 1
3003 | Nlu | nlu_analyez | hello | 52.188 | 1
3005 | Nlu | nlu_analyez | hello | 52.358 | 1
3006 | Nlu | nlu_analyez | hello | 48.956 | 1
3007 | Nlu | nlu_analyez | hello | 53.101 | 1
3005 | Nlu | nlu_analyez | hello | 76.26 | 1
3015 | Nlu | nlu_analyez | hello commotion hello | 48.392 | 0
3004 | Nlu | nlu_analyez | hello hello | 52.051 | 1
3008 | Nlu | nlu_analyez | hello hello | 53.647 | 1
3001 | Nlu | nlu_analyez | hello hello | 105.446 | 1
3003 | Nlu | nlu_analyez | hello hello | 56.261 | 1
3005 | Nlu | nlu_analyez | hello hello | 54.702 | 1
3006 | Nlu | nlu_analyez | hello hello | 53.54 | 1
3007 | Nlu | nlu_analyez | hello hello | 66.392 | 1
3008 | Nlu | nlu_analyez | hello hello | 52.227 | 1
3009 | Nlu | nlu_analyez | hello hello | 60.945 | 1
3010 | Nlu | nlu_analyez | hello hello | 51.229 | 1
3015 | Nlu | nlu_analyez | hello hello hello | 59.194 | 1
3004 | Nlu | nlu_analyez | hello hello hello hello hello hello hello hello hello hello | 52.418 | 1
3004 | Nlu | nlu_analyez | hey | 72.229 | 1
3009 | Nlu | nlu_analyez | hey | 357.491 | 1
3015 | Nlu | nlu_analyez | hey you do emotion dance | 70.843 | 1
3006 | Nlu | nlu_analyez | hi | 51.73 | 1
3002 | Nlu | nlu_analyez | hi by | 62.547 | 1
3046 | Nlu | nlu_analyez | hi can teach you how to sing | 80.356 | 1
3003 | Nlu | nlu_analyez | hi well to to you dance | 67.273 | 0
3000 | Nlu | nlu_analyez | how | 55.386 | 1
3045 | Nlu | nlu_analyez | how do emotion fly | 68.677 | 1
3009 | Nlu | nlu_analyez | i | 48.165 | 1
3001 | Nlu | nlu_analyez | i teach her how do you think | 62.569
3002 | Nlu | nlu_analyez | i teach you how do you think | 48.408
3006 | Nlu | nlu_analyez | i teach you how to dance | 65.025
3003 | Nlu | nlu_analyez | i teach you how to dance | 48.733
3004 | Nlu | nlu_analyez | i want to teach you hello | 69.068
3003 | Nlu | nlu_analyez | i want to tissue hello | 74.591
3001 | Nlu | nlu_analyez | i'll teach you how to fly | 526.842
3007 | Nlu | nlu_analyez | k u hello | 72.916 | 1
3008 | Nlu | nlu_analyez | k u hello | 51.539 | 1
3012 | Nlu | nlu_analyez | kobe | 48.617 | 0
3004 | Nlu | nlu_analyez | maggie | 65.494 | 1
3010 | Nlu | nlu_analyez | man | 378.99 | 1
3001 | Nlu | nlu_analyez | me | 2706.1 | 1
3013 | Nlu | nlu_analyez | me | 62.43 | 1
3011 | Nlu | nlu_analyez | motion hello | 50.348 | 1
3040 | Nlu | nlu_analyez | o k you done studies | 70.04 | 0
3039 | Nlu | nlu_analyez | oh | 70.581 | 1
3001 | Nlu | nlu_analyez | oh | 48.706 | 1
3008 | Nlu | nlu_analyez | oh | 210.361 | 1
3000 | Nlu | nlu_analyez | oh hello | 841.029 | 1
3002 | Nlu | nlu_analyez | oh hello | 52.609 | 1
3002 | Nlu | nlu_analyez | one | 54.894 | 1
3003 | Nlu | nlu_analyez | one | 52.982 | 1
3005 | Nlu | nlu_analyez | please do hello | 66.006 | 0
3021 | Nlu | nlu_analyez | promotion fly | 55.862 | 1
3048 | Nlu | nlu_analyez | right | 73.861 | 1
3019 | Nlu | nlu_analyez | say my name | 52.142 | 1
3001 | Nlu | nlu_analyez | she was | 65.974 | 1
3018 | Nlu | nlu_analyez | so my name | 62.526 | 1
3002 | Nlu | nlu_analyez | some bitterness | 70.638 | 1
3007 | Nlu | nlu_analyez | still | 51.172 | 1
3003 | Nlu | nlu_analyez | stop | 62.909 | 1
3006 | Nlu | nlu_analyez | that's right before | 67.832 | 0
3044 | Nlu | nlu_analyez | the | 48.142 | 1
3045 | Nlu | nlu_analyez | the | 52.556 | 1
3002 | Nlu | nlu_analyez | the | 64.926 | 1
3005 | Nlu | nlu_analyez | the | 69.279 | 1
3020 | Nlu | nlu_analyez | the motion downs | 69.722 | 1
3005 | Nlu | nlu_analyez | the motion hello | 73.8
3004 | Nlu | nlu_analyez | the soon | 62.478 | 1
3005 | Nlu | nlu_analyez | there's still time to | 59.332 | 0
3001 | Nlu | nlu_analyez | this | 60.048 | 0
3022 | Nlu | nlu_analyez | to emotion pounds | 80.107 | 1
3013 | Nlu | nlu_analyez | to modern dance | 73.533 | 1
3019 | Nlu | nlu_analyez | to motion downs | 73.282 | 1
3047 | Nlu | nlu_analyez | what | 51.114 | 1
3003 | Nlu | nlu_analyez | what i | 47.361 | 0
3001 | Nlu | nlu_analyez | what's her name | 59.742 | 1
3002 | Nlu | nlu_analyez | what's my name | 61.948 | 1
3001 | Nlu | nlu_analyez | what's your name | 76.686
3001 | Nlu | nlu_analyez | what's your name | 70.893 | 1
3014 | Nlu | nlu_analyez | what's your name | 63.688 | 1
3001 | Nlu | nlu_analyez | what's your name | 70.31 | 1
3002 | Nlu | nlu_analyez | what's your name | 74.795 | 1
3001 | Nlu | nlu_analyez | what's your name | 53.278 | 1
3020 | Nlu | nlu_analyez | what's your name | 51.489 | 1
3002 | Nlu | nlu_analyez | with my name | 69.617
3003 | Nlu | nlu_analyez | yeah | 67.268 | 1
3000 | Nlu | nlu_analyez | yeah | 68.503 | 1
3007 | Nlu | nlu_analyez | yeah | 1034.452 | 1
3011 | Nlu | nlu_analyez | yeah | 2787.006 | 1
3000 | Nlu | nlu_analyez | yeah | 49.132 | 1
3006 | Nlu | nlu_analyez | years | 59.241 | 1
3012 | Nlu | nlu_analyez | yes | 61.737 | 1
3015 | Nlu | nlu_analyez | you in system | 62.875 | 0
3003 | Nlu | nlu_analyez | you that she was his movies | 73.587 | 1
0 | Screen-Motion | DO_MOTION | left_l | 65.971 | 0
1 | Screen-Motion | DO_MOTION | left_r | 62.136 | 0
2 | Screen-Motion | DO_MOTION | left_r | 65.816 | 0
3 | Screen-Motion | DO_MOTION | left_r | 72.281 | 0
4 | Screen-Motion | DO_MOTION | left_r | 62.38 | 0
5 | Screen-Motion | DO_MOTION | left_r | 67.374 | 0
6 | Screen-Motion | DO_MOTION | left_u | 64.721 | 0
7 | Screen-Motion | DO_MOTION | left_u | 62.033 | 0
8 | Screen-Motion | DO_MOTION | left_d | 62.199 | 0
9 | Screen-Motion | DO_MOTION | left_l | 66.491 | 0
10 | Screen-Motion | DO_MOTION | left_l | 62.067 | 0
11 | Screen-Motion | DO_MOTION | left_r | 69.358 | 0
12 | Screen-Motion | DO_MOTION | left_r | 64.011 | 0
13 | Screen-Motion | DO_MOTION | left_u | 65.305 | 0
14 | Screen-Motion | DO_MOTION | left_u | 65.872 | 0
15 | Screen-Motion | DO_MOTION | left_d | 68.185 | 0
16 | Screen-Motion | DO_MOTION | left_d | 68.562 | 0
17 | Screen-Motion | DO_MOTION | left_l | 64.094 | 0
18 | Screen-Motion | DO_MOTION | left_l | 62.037 | 0
19 | Screen-Motion | DO_MOTION | left_r | 64.896 | 0
20 | Screen-Motion | DO_MOTION | left_r | 64.982 | 0
21 | Screen-Motion | DO_MOTION | left_l | 65.454 | 0
22 | Screen-Motion | DO_MOTION | left_l | 62.173 | 0
23 | Screen-Motion | DO_MOTION | left_r | 62.402 | 0
24 | Screen-Motion | DO_MOTION | left_r | 66.343 | 0
25 | Screen-Motion | DO_MOTION | left_l | 64.036 | 0
26 | Screen-Motion | DO_MOTION | left_l | 62.139 | 0
27 | Screen-Motion | DO_MOTION | left_r | 63.711 | 0
28 | Screen-Motion | DO_MOTION | left_r | 62.273 | 0
29 | Screen-Motion | DO_MOTION | left_l | 62.151 | 0
30 | Screen-Motion | DO_MOTION | left_l | 62.169 | 0
31 | Screen-Motion | DO_MOTION | left_r | 62.257 | 0
32 | Screen-Motion | DO_MOTION | left_r | 65.762 | 0
33 | Screen-Motion | DO_MOTION | left_d | 62.167 | 0
34 | Screen-Motion | DO_MOTION | left_d | 62.126 | 0
35 | Screen-Motion | DO_MOTION | left_u | 62.055 | 0
36 | Screen-Motion | DO_MOTION | left_u | 62.473 | 0
37 | Screen-Motion | DO_MOTION | left_l | 62.052 | 0
38 | Screen-Motion | DO_MOTION | left_l | 65.586 | 0
39 | Screen-Motion | DO_MOTION | left_r | 63.188 | 0
40 | Screen-Motion | DO_MOTION | left_r | 65.269 | 0
41 | Screen-Motion | DO_MOTION | left_l | 63.46 | 0
42 | Screen-Motion | DO_MOTION | left_u | 62.055 | 0
43 | Screen-Motion | DO_MOTION | left_r | 66.292 | 0
44 | Screen-Motion | DO_MOTION | left_l | 62.872 | 0
45 | Screen-Motion | DO_MOTION | left_r | 68.885 | 0
46 | Screen-Motion | DO_MOTION | left_l | 63.718 | 0
47 | Screen-Motion | DO_MOTION | left_r | 67.347 | 0
48 | Screen-Motion | DO_MOTION | left_l | 71.825 | 0
49 | Screen-Motion | DO_MOTION | left_r | 63.104 | 0
50 | Screen-Motion | DO_MOTION | left_l | 62.054 | 0
51 | Screen-Motion | DO_MOTION | left_r | 62.179 | 0
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
2002 | Speaker | TTS | do motion dance | 638.509 | 1
2002 | Speaker | TTS | can not finduu | 567.535 | 1
2003 | Speaker | TTS | can not finduu | 657.271 | 1
2001 | Speaker | TTS | background update successfully | 984.508 | 1
2004 | Speaker | TTS | background update successfully | 1047.267 | 1

Sheet: 2026-04-16
TaskID | Module | Type | TargetName | Duration(ms) | issuccess | Module | Average Duration | Peak Duration | P90
4674 | Microphone | STT | guy | 26.797 | 1 | Camera | - | - | -
4006 | Microphone | STT | hello hello | 7.472 | 1 | STT | 10.968875 | 48.336 | 28.6375
4008 | Microphone | STT | hello hello | 2.647 | 1 | TTS | 1153.567955 | 5512.169 | 1841.4607 | 22 | 649.134
4010 | Microphone | STT | hello hello | 6.022 | 1 | Screen-Motion | 64.41575758 | 72.281 | 67.7795
4011 | Microphone | STT | hello hello | 0.909 | 1 | Nlu | 260.5569 | 2787.006 | 425.1939
4012 | Microphone | STT | hello hello | 8.279 | 1
4013 | Microphone | STT | hello hello | 2.83 | 1
4014 | Microphone | STT | hello hello | 1.549 | 1
4015 | Microphone | STT | hello hello | 1.523 | 1
4009 | Microphone | STT | hello hello hello hello hello hello hello hello hello hello | 1.113 | 1
4603 | Microphone | STT | oh | 5.986 | 1
4005 | Microphone | STT | oh hello | 2.79 | 1
4007 | Microphone | STT | oh hello | 3.799 | 1
4688 | Microphone | STT | yeah | 30.478 | 1
4704 | Microphone | STT | yes | 24.972 | 1
4820 | Microphone | STT | you in system | 48.336 | 1
3008 | Nlu | nlu_analyez | oh | 210.361 | 1
3009 | Nlu | nlu_analyez | guy | 81.106 | 1
3010 | Nlu | nlu_analyez | man | 378.99 | 1
3011 | Nlu | nlu_analyez | yeah | 2787.006 | 1
3012 | Nlu | nlu_analyez | yes | 61.737 | 1
3013 | Nlu | nlu_analyez | me | 62.43 | 1
3014 | Nlu | nlu_analyez | ever | 70.703 | 1
3015 | Nlu | nlu_analyez | you in system | 62.875 | 0
3000 | Nlu | nlu_analyez | yeah | 49.132 | 1
3000 | Nlu | nlu_analyez | oh hello | 841.029 | 1
3001 | Nlu | nlu_analyez | hello hello | 105.446 | 1
3002 | Nlu | nlu_analyez | oh hello | 52.609 | 1
3003 | Nlu | nlu_analyez | hello hello | 56.261 | 1
3004 | Nlu | nlu_analyez | hello hello hello hello hello hello hello hello hello hello | 52.418 | 1
3005 | Nlu | nlu_analyez | hello hello | 54.702 | 1
3006 | Nlu | nlu_analyez | hello hello | 53.54 | 1
3007 | Nlu | nlu_analyez | hello hello | 66.392 | 1
3008 | Nlu | nlu_analyez | hello hello | 52.227 | 1
3009 | Nlu | nlu_analyez | hello hello | 60.945 | 1
3010 | Nlu | nlu_analyez | hello hello | 51.229 | 1
0 | Screen-Motion | DO_MOTION | left_l | 65.971 | 0
1 | Screen-Motion | DO_MOTION | left_r | 62.136 | 0
2 | Screen-Motion | DO_MOTION | left_r | 65.816 | 0
3 | Screen-Motion | DO_MOTION | left_r | 72.281 | 0
4 | Screen-Motion | DO_MOTION | left_r | 62.38 | 0
5 | Screen-Motion | DO_MOTION | left_r | 67.374 | 0
6 | Screen-Motion | DO_MOTION | left_u | 64.721 | 0
7 | Screen-Motion | DO_MOTION | left_u | 62.033 | 0
8 | Screen-Motion | DO_MOTION | left_d | 62.199 | 0
9 | Screen-Motion | DO_MOTION | left_l | 66.491 | 0
10 | Screen-Motion | DO_MOTION | left_l | 62.067 | 0
11 | Screen-Motion | DO_MOTION | left_r | 69.358 | 0
12 | Screen-Motion | DO_MOTION | left_r | 64.011 | 0
13 | Screen-Motion | DO_MOTION | left_u | 65.305 | 0
14 | Screen-Motion | DO_MOTION | left_u | 65.872 | 0
15 | Screen-Motion | DO_MOTION | left_d | 68.185 | 0
16 | Screen-Motion | DO_MOTION | left_d | 68.562 | 0
17 | Screen-Motion | DO_MOTION | left_l | 64.094 | 0
18 | Screen-Motion | DO_MOTION | left_l | 62.037 | 0
19 | Screen-Motion | DO_MOTION | left_r | 64.896 | 0
20 | Screen-Motion | DO_MOTION | left_r | 64.982 | 0
21 | Screen-Motion | DO_MOTION | left_l | 65.454 | 0
22 | Screen-Motion | DO_MOTION | left_l | 62.173 | 0
23 | Screen-Motion | DO_MOTION | left_r | 62.402 | 0
24 | Screen-Motion | DO_MOTION | left_r | 66.343 | 0
25 | Screen-Motion | DO_MOTION | left_l | 64.036 | 0
26 | Screen-Motion | DO_MOTION | left_l | 62.139 | 0
27 | Screen-Motion | DO_MOTION | left_r | 63.711 | 0
28 | Screen-Motion | DO_MOTION | left_r | 62.273 | 0
29 | Screen-Motion | DO_MOTION | left_l | 62.151 | 0
30 | Screen-Motion | DO_MOTION | left_l | 62.169 | 0
31 | Screen-Motion | DO_MOTION | left_r | 62.257 | 0
32 | Screen-Motion | DO_MOTION | left_r | 65.762 | 0
33 | Screen-Motion | DO_MOTION | left_d | 62.167 | 0
34 | Screen-Motion | DO_MOTION | left_d | 62.126 | 0
35 | Screen-Motion | DO_MOTION | left_u | 62.055 | 0
36 | Screen-Motion | DO_MOTION | left_u | 62.473 | 0
37 | Screen-Motion | DO_MOTION | left_l | 62.052 | 0
38 | Screen-Motion | DO_MOTION | left_l | 65.586 | 0
39 | Screen-Motion | DO_MOTION | left_r | 63.188 | 0
40 | Screen-Motion | DO_MOTION | left_r | 65.269 | 0
41 | Screen-Motion | DO_MOTION | left_l | 63.46 | 0
42 | Screen-Motion | DO_MOTION | left_u | 62.055 | 0
43 | Screen-Motion | DO_MOTION | left_r | 66.292 | 0
44 | Screen-Motion | DO_MOTION | left_l | 62.872 | 0
45 | Screen-Motion | DO_MOTION | left_r | 68.885 | 0
46 | Screen-Motion | DO_MOTION | left_l | 63.718 | 0
47 | Screen-Motion | DO_MOTION | left_r | 67.347 | 0
48 | Screen-Motion | DO_MOTION | left_l | 71.825 | 0
49 | Screen-Motion | DO_MOTION | left_r | 63.104 | 0
50 | Screen-Motion | DO_MOTION | left_l | 62.054 | 0
51 | Screen-Motion | DO_MOTION | left_r | 62.179 | 0
52 | Screen-Motion | DO_MOTION | left_l | 62.245 | 0
53 | Screen-Motion | DO_MOTION | left_r | 70.1 | 0
54 | Screen-Motion | DO_MOTION | left_l | 62.128 | 0
55 | Screen-Motion | DO_MOTION | left_r | 65.374 | 0
56 | Screen-Motion | DO_MOTION | left_l | 62.206 | 0
57 | Screen-Motion | DO_MOTION | left_r | 64.234 | 0
58 | Screen-Motion | DO_MOTION | left_d | 64.342 | 0
59 | Screen-Motion | DO_MOTION | left_d | 66.682 | 0
60 | Screen-Motion | DO_MOTION | left_u | 65.382 | 0
61 | Screen-Motion | DO_MOTION | left_l | 66.926 | 0
62 | Screen-Motion | DO_MOTION | left_r | 62.094 | 0
63 | Screen-Motion | DO_MOTION | left_l | 64.518 | 0
64 | Screen-Motion | DO_MOTION | left_r | 62.051 | 0
65 | Screen-Motion | DO_MOTION | left_l | 62.81 | 0
2013 | Speaker | TTS | hello good morning milars | 827.722 | 1
2014 | Speaker | TTS | hello good morning milars | 832.024 | 1
2015 | Speaker | TTS | hello good morning milars | 765.971 | 1
2016 | Speaker | TTS | hello good morning milars | 1894.486 | 1
2017 | Speaker | TTS | hello good morning milars | 679.751 | 1
2018 | Speaker | TTS | hello good morning milars | 760.571 | 1
2019 | Speaker | TTS | hello good morning milars | 1312.868 | 1
2020 | Speaker | TTS | sorry i didn't understand that | 1364.233 | 1
2000 | Speaker | TTS | hello good morning milars | 1035.744 | 1
2000 | Speaker | TTS | hello good morning milars | 5512.169 | 1
2001 | Speaker | TTS | hello good morning milars | 2663.948 | 1
2002 | Speaker | TTS | hello good morning milars | 707.737 | 1
2003 | Speaker | TTS | hello good morning milars | 715.369 | 1
2004 | Speaker | TTS | hello good morning milars | 711.649 | 1
2005 | Speaker | TTS | hello good morning milars | 692.597 | 1
2006 | Speaker | TTS | hello good morning milars | 717.328 | 1
2007 | Speaker | TTS | hello good morning milars | 707.235 | 1
2008 | Speaker | TTS | hello good morning milars | 649.134 | 1
2009 | Speaker | TTS | hello good morning milars | 727.932 | 1
2010 | Speaker | TTS | hello good morning milars | 695.369 | 1
2011 | Speaker | TTS | hello good morning milars | 706.91 | 1
2012 | Speaker | TTS | hello good morning milars | 697.748 | 1

Sheet: 2026-04-17
TaskID | Module | Type | TargetName | Duration(ms) | issuccess | Whole system test |  |  |  | TaskID | Module | Type | TargetName | Duration(ms) | issuccessful |  | TaskID | Module | Type | TargetName | Duration(ms) | issuccessful | TaskID | Module | Type | TargetName | Duration(ms) | issuccessful
2000 | Speaker | TTS | sorry i didn't understand that | 1539.284 | 1 | Module | Average Duration | Peak Duration | P90 | 1000 | Camera | Update | None | 69.97 | 1 |  | 3000 | Nlu | nlu_analyez | hello know | 90.463 | 1 | 0 | Screen-Motion | DO_MOTION | left_l | 62.151 | 0
2001 | Speaker | TTS | sorry i didn't understand that | 1547.983 | 1 | Camera | 34.21449333 | 72.11 | 38.753 | 1001 | Camera | Learn | ii | 65.532 | 1 |  | 3000 | Nlu | nlu_analyez | hello | 48.547 | 1 | 1 | Screen-Motion | DO_MOTION | left_l | 62.141 | 0
2024 | Speaker | TTS | reset now | 456.671 | 1 | STT | 13.3399 | 37.585 | 28.3862 | 1002 | Camera | Detecte | ii | 30.027 | 1 |  | 3001 | Nlu | nlu_analyez | hello | 70.636 | 1 | 2 | Screen-Motion | DO_MOTION | left_l | 62.122 | 0
2028 | Speaker | TTS | reset now | 535.537 | 1 | TTS | 844.7826916 | 2274.52 | 1304.7954 | 1003 | Camera | Detecte | ii | 30.644 | 1 |  | 3001 | Nlu | nlu_analyez | hello | 47.599 | 1 | 3 | Screen-Motion | DO_MOTION | left_l | 62.086 | 0
2000 | Speaker | TTS | reset now | 595.328 | 1 | Screen-Motion | 64.20419856 | 73.758 | 67.6418 | 1004 | Camera | Detecte | ii | 30.635 | 1 |  | 3002 | Nlu | nlu_analyez | what's your name | 46.444 | 1 | 4 | Screen-Motion | DO_MOTION | left_r | 62.913 | 0
2000 | Speaker | TTS | reset now | 556.466 | 1 | Nlu | 67.5034 | 88.242 | 79.2351 | 1005 | Camera | Detecte | ii | 28.91 | 1 |  | 3002 | Nlu | nlu_analyez | what's your name | 47.414 | 1 | 5 | Screen-Motion | DO_MOTION | left_r | 63.071 | 0
2001 | Speaker | TTS | reset now | 427.777 | 1 | Sperate module test |  |  |  | 1006 | Camera | Detecte | ii | 31.507 | 1 |  | 3003 | Nlu | nlu_analyez | hard to motion fly | 6362.9 | 1 | 6 | Screen-Motion | DO_MOTION | left_r | 62.123 | 0
2001 | Speaker | TTS | reset now | 479.132 | 1 | Module | Average Duration | Peak Duration | P90 | 1007 | Camera | Detecte | ii | 32.568 | 1 |  | 3003 | Nlu | nlu_analyez | my name | 48.023 | 1 | 7 | Screen-Motion | DO_MOTION | left_r | 64.846 | 0
2002 | Speaker | TTS | reset now | 460.606 | 1 | Camera | 35.85481818 | 69.97 | 48.304 | 1008 | Camera | Detecte | yy | 33.27 | 0 |  | 3004 | Nlu | nlu_analyez | promotion hello | 3759.882 | 1 | 8 | Screen-Motion | DO_MOTION | left_u | 62.144 | 0
2003 | Speaker | TTS | reset now | 458.314 | 1 | STT | 9.683923241 | 36.812 | 15.524 | 1009 | Camera | Update | None | 33.467 | 1 |  | 3004 | Nlu | nlu_analyez | promotional hello | 48.983 | 1 | 9 | Screen-Motion | DO_MOTION | left_u | 64.414 | 0
2004 | Speaker | TTS | reset now | 484.086 | 1 | TTS | 429.4536873 | 3140.545 | 787.9128 | 1010 | Camera | Learn | ii | 30.775 | 1 |  | 3005 | Nlu | nlu_analyez | promotion cry | 47.54 | 1 | 10 | Screen-Motion | DO_MOTION | left_u | 62.148 | 0
2002 | Speaker | TTS | reset now | 431.35 | 1 | Screen-Motion | 62.74216964 | 68.093 | 64.4905 | 1011 | Camera | Detecte | ii | 30.887 | 1 |  | 4000 | Microphone | STT | None | 11.779 | 0 | 11 | Screen-Motion | DO_MOTION | left_d | 63.535 | 0
2003 | Speaker | TTS | reset now | 540.738 | 1 | Nlu | 965.3119091 | 6362.9 | 3759.882 | 1012 | Camera | Detecte | ii | 34.121 | 1 |  | 4000 | Microphone | STT | None | 1.906 | 0 | 12 | Screen-Motion | DO_MOTION | left_d | 64.554 | 0
2004 | Speaker | TTS | reset now | 473.686 | 1 | In seperate system test,STT module uses less time, indicates its performance is effected by other modules in whole system test.Camera and Screen-motion stay the same in both test.TTS module remains the bottleneck in whole system. |  |  |  | 1013 | Camera | Detecte | ii | 31.395 | 1 |  | 4001 | Microphone | STT | hello know | 1.337 | 1 | 13 | Screen-Motion | DO_MOTION | left_d | 65.435 | 0
2006 | Speaker | TTS | reset now | 421.685 | 1 |  |  |  |  | 1014 | Camera | Detecte | ii | 49.634 | 1 |  | 4001 | Microphone | STT | hello | 2.631 | 1 | 14 | Screen-Motion | DO_MOTION | right_l | 64.569 | 0
2001 | Speaker | TTS | reset now | 376.171 | 1 |  |  |  |  | 1015 | Camera | Detecte | ii | 33.077 | 1 |  | 4002 | Microphone | STT | hello | 1.974 | 1 | 15 | Screen-Motion | DO_MOTION | right_l | 64.433 | 0
2003 | Speaker | TTS | reset now | 436.141 | 1 |  |  |  |  | 1016 | Camera | Detecte | ii | 32.128 | 1 |  | 4002 | Microphone | STT | hello | 3.322 | 1 | 16 | Screen-Motion | DO_MOTION | right_l | 64.263 | 0
2004 | Speaker | TTS | reset now | 432.358 | 1 |  |  |  |  | 1017 | Camera | Detecte | ii | 31.895 | 1 |  | 4003 | Microphone | STT | what's your name | 0.82 | 1 | 17 | Screen-Motion | DO_MOTION | right_r | 62.193 | 0
2007 | Speaker | TTS | reset now | 1210.829 | 1 |  |  |  |  | 1018 | Camera | Detecte | uu | 36.334 | 0 |  | 4003 | Microphone | STT | what's your name | 1.302 | 1 | 18 | Screen-Motion | DO_MOTION | right_r | 67.593 | 0
2008 | Speaker | TTS | reset now | 450.845 | 1 | Improved TTS test(caching) |  |  |  | 1019 | Camera | Detecte | ii | 28.735 | 1 |  | 4004 | Microphone | STT | hard to motion fly | 1.374 | 1 | 19 | Screen-Motion | DO_MOTION | right_r | 62.757 | 0
2009 | Speaker | TTS | reset now | 433.716 | 1 | Module | Average Duration | Peak Duration | P90 | 1020 | Camera | Detecte | ii | 33.161 | 1 |  | 4004 | Microphone | STT | my name | 2.695 | 1 | 20 | Screen-Motion | DO_MOTION | right_r | 64.064 | 0
2010 | Speaker | TTS | reset now | 448.949 | 1 | TTS Updated | 874.237491 | 3316.481 | 1186.7992 | 1021 | Camera | Detecte | ii | 30.134 | 1 |  | 4005 | Microphone | STT | promotion hello | 2.96 | 1 | 21 | Screen-Motion | DO_MOTION | right_r | 62.14 | 0
2011 | Speaker | TTS | reset now | 471.221 | 1 | TTS Sperate test | 431.3068243 | 3140.545 | 787.9504 | TaskID | Module | Type | TargetName | Duration(ms) | issuccessful |  | 4005 | Microphone | STT | promotional hello | 0.625 | 1 | 22 | Screen-Motion | DO_MOTION | right_r | 68.093 | 0
2012 | Speaker | TTS | reset now | 443.549 | 1 | TTS Whole system | 741.8826262 | 2274.52 | 1258.2062 |  |  |  |  |  |  |  | 4006 | Microphone | STT | do motion hello | 1.242 | 1 | 23 | Screen-Motion | DO_MOTION | right_r | 64.488 | 0
2013 | Speaker | TTS | reset now | 419.047 | 1 | While introduced caching system in todays later test,no significant inmprovement can be observed for now. |  |  |  |  |  |  |  |  |  | m | 4006 | Microphone | STT | promotion cry | 3.751 | 1 | 24 | Screen-Motion | DO_MOTION | right_r | 64.62 | 0
2001 | Speaker | TTS | learn objectcansuccessfully | 1058.547 | 1 |  |  |  |  |  |  |  |  |  |  |  | 4007 | Microphone | STT | to motion hello | 2.525 | 1 | 25 | Screen-Motion | DO_MOTION | right_u | 62.211 | 0
2002 | Speaker | TTS | learn objectcansuccessfully | 1062.976 | 1 |  |  |  |  |  |  |  |  |  |  |  | 4007 | Microphone | STT | hello | 1.261 | 1 | 26 | Screen-Motion | DO_MOTION | right_u | 62.144 | 0
2002 | Speaker | TTS | learn objectcansuccessfully | 1014.867 | 1 |  |  |  |  | 4000 | Microphone | STT | hello | 1.503 | 1 |  | 4008 | Microphone | STT | the home | 5.846 | 1 | 27 | Screen-Motion | DO_MOTION | right_u | 62.21 | 0
2002 | Speaker | TTS | learn objectcansuccessfully | 1050.941 | 1 |  |  |  |  | 4001 | Microphone | STT | None | 2.649 | 0 |  | 4008 | Microphone | STT | hello | 2.516 | 1 | 28 | Screen-Motion | DO_MOTION | right_u | 62.167 | 0
2001 | Speaker | TTS | learn objectcansuccessfully | 1050.927 | 1 |  |  |  |  | 4002 | Microphone | STT | hello | 1.309 | 1 |  | 4009 | Microphone | STT | hello | 1.231 | 1 | 29 | Screen-Motion | DO_MOTION | right_d | 62.188 | 0
2001 | Speaker | TTS | learn objectbottomsuccessfully | 1060.452 | 1 |  |  |  |  | 4003 | Microphone | STT | hello | 3.528 | 1 |  | 4009 | Microphone | STT | the motion cry | 2.811 | 1 | 30 | Screen-Motion | DO_MOTION | right_d | 64.734 | 0
2009 | Speaker | TTS | learn objectbottomsuccessfully | 1399.215 | 1 |  |  |  |  | 4004 | Microphone | STT | what's your name | 1.631 | 1 |  | 4010 | Microphone | STT | what's your name | 5.238 | 1 | 31 | Screen-Motion | DO_MOTION | right_d | 62.151 | 0
2003 | Speaker | TTS | learn motion two | 612.804 | 1 |  |  |  |  | 2000 | Speaker | TTS | hello | 270.034 | 1 |  | 4010 | Microphone | STT | hello | 2.305 | 1 | 32 | Screen-Motion | DO_MOTION | right_d | 62.13 | 0
2005 | Speaker | TTS | learn motion three | 855.218 | 1 |  |  |  |  | 2001 | Speaker | TTS | hello | 283.603 | 1 |  | 4011 | Microphone | STT | where's my name | 2.043 | 1 | 33 | Screen-Motion | DO_MOTION | right_d | 64.719 | 0
2012 | Speaker | TTS | learn motion six | 621.812 | 1 |  |  |  |  | 2002 | Speaker | TTS | hello | 249.14 | 1 |  | 4011 | Microphone | STT | hello | 5.079 | 1 | 34 | Screen-Motion | DO_MOTION | right_u | 65.386 | 0
2016 | Speaker | TTS | learn motion seven | 669.811 | 1 |  |  |  |  | 2003 | Speaker | TTS | hello | 241.152 | 1 |  | 4012 | Microphone | STT | what's my name | 1.97 | 1 | 35 | Screen-Motion | DO_MOTION | right_u | 64.476 | 0
2001 | Speaker | TTS | learn motion one | 664.039 | 1 |  |  |  |  | 2004 | Speaker | TTS | what is your name | 539.528 | 1 |  | 4012 | Microphone | STT | promotion right | 6.096 | 1 | 36 | Screen-Motion | DO_MOTION | right_u | 62.17 | 0
2007 | Speaker | TTS | learn motion four | 981.438 | 1 |  |  |  |  | 2005 | Speaker | TTS | my name is robot | 677.512 | 1 |  | 4013 | Microphone | STT | what's your name | 5.333 | 1 | 37 | Screen-Motion | DO_MOTION | right_u | 65.589 | 0
2010 | Speaker | TTS | learn motion five | 756.454 | 1 |  |  |  |  | 2006 | Speaker | TTS | today is sunday | 1078.753 | 1 |  | 4013 | Microphone | STT | to emotion cry | 5.134 | 1 | 38 | Screen-Motion | DO_MOTION | right_u | 62.118 | 0
2021 | Speaker | TTS | learn motion eight | 568.217 | 1 |  |  |  |  | 2007 | Speaker | TTS | do motion hello | 1519.645 | 1 |  | 4014 | Microphone | STT | do emotion cry | 3.365 | 1 | 39 | Screen-Motion | DO_MOTION | left_r | 62.127 | 0
2004 | Speaker | TTS | i know how to two | 681.382 | 1 |  |  |  |  | 2008 | Speaker | TTS | hello good morning milars | 1725.96 | 1 |  | 4015 | Microphone | STT | do emotion cry | 5.229 | 1 | 40 | Screen-Motion | DO_MOTION | left_r | 62.121 | 0
2006 | Speaker | TTS | i know how to three | 720.447 | 1 |  |  |  |  | 2009 | Speaker | TTS | hello good morning milars | 2260.598 | 1 |  | 4016 | Microphone | STT | huh | 6.796 | 1 | 41 | Screen-Motion | DO_MOTION | left_r | 62.109 | 0
2014 | Speaker | TTS | i know how to six | 711.509 | 1 |  |  |  |  | 2010 | Speaker | TTS | hello good morning milars | 2793.556 | 1 |  | 4017 | Microphone | STT | huh | 7.978 | 1 | 42 | Screen-Motion | DO_MOTION | left_l | 64.468 | 0
2018 | Speaker | TTS | i know how to seven | 619.94 | 1 |  |  |  |  | 2011 | Speaker | TTS | hello good morning milars | 3140.545 | 1 |  | 4018 | Microphone | STT | None | 9.661 | 0 | 43 | Screen-Motion | DO_MOTION | left_l | 62.158 | 0
2002 | Speaker | TTS | i know how to one | 652.986 | 1 |  |  |  |  | 2000 | Speaker | TTS | hello | 239.592 | 1 |  | 4019 | Microphone | STT | None | 4.445 | 0 | 44 | Screen-Motion | DO_MOTION | left_l | 64.789 | 0
2026 | Speaker | TTS | i know how to None | 682.286 | 1 |  |  |  |  | 2001 | Speaker | TTS | hello | 236.496 | 1 |  | 4020 | Microphone | STT | None | 5.349 | 0 | 45 | Screen-Motion | DO_MOTION | left_u | 63.866 | 0
2027 | Speaker | TTS | i know how to None | 706.315 | 1 |  |  |  |  | 2002 | Speaker | TTS | hello | 264.304 | 1 |  | 4021 | Microphone | STT | None | 4.186 | 0 | 46 | Screen-Motion | DO_MOTION | left_u | 63.291 | 0
2006 | Speaker | TTS | i know how to None | 653.321 | 1 |  |  |  |  | 2003 | Speaker | TTS | hello | 267.172 | 1 |  | 4022 | Microphone | STT | None | 3.049 | 0 | 47 | Screen-Motion | DO_MOTION | left_u | 62.152 | 0
2008 | Speaker | TTS | i know how to four | 725.105 | 1 |  |  |  |  | 2004 | Speaker | TTS | what is your name | 508.901 | 1 |  | 4023 | Microphone | STT | None | 5.434 | 0 | 48 | Screen-Motion | DO_MOTION | left_d | 64.345 | 0
2011 | Speaker | TTS | i know how to five | 734.954 | 1 |  |  |  |  | 2005 | Speaker | TTS | my name is robot | 596.773 | 1 |  | 4024 | Microphone | STT | huh | 10.421 | 1 | 49 | Screen-Motion | DO_MOTION | left_d | 62.525 | 0
2022 | Speaker | TTS | i know how to eight | 544.271 | 1 |  |  |  |  | 2006 | Speaker | TTS | today is sunday | 647.665 | 1 |  | 4025 | Microphone | STT | None | 4.168 | 0 | 50 | Screen-Motion | DO_MOTION | left_d | 64.41 | 0
2009 | Speaker | TTS | hello good morning milars | 683.484 | 1 |  |  |  |  | 2007 | Speaker | TTS | do motion hello | 523.415 | 1 |  | 4026 | Microphone | STT | huh | 11.257 | 1 | 51 | Screen-Motion | DO_MOTION | right_l | 64.542 | 0
2017 | Speaker | TTS | hello good morning milars | 799.936 | 1 |  |  |  |  | 2008 | Speaker | TTS | hello good morning milars | 659.866 | 1 |  | 4027 | Microphone | STT | None | 7.371 | 0 | 52 | Screen-Motion | DO_MOTION | right_l | 64.493 | 0
2019 | Speaker | TTS | hello good morning milars | 795.926 | 1 |  |  |  |  | 2009 | Speaker | TTS | hello good morning milars | 638.116 | 1 |  | 4028 | Microphone | STT | None | 6.119 | 0 | 53 | Screen-Motion | DO_MOTION | right_l | 62.175 | 0
2020 | Speaker | TTS | hello good morning milars | 732.472 | 1 |  |  |  |  | 2010 | Speaker | TTS | hello good morning milars | 618.278 | 1 |  | 4029 | Microphone | STT | None | 6.232 | 0 | 54 | Screen-Motion | DO_MOTION | right_u | 62.207 | 0
2002 | Speaker | TTS | hello good morning milars | 839.335 | 1 |  |  |  |  | 2011 | Speaker | TTS | hello good morning milars | 650.707 | 1 |  | 4030 | Microphone | STT | None | 12.631 | 0 | 55 | Screen-Motion | DO_MOTION | right_u | 64.801 | 0
2001 | Speaker | TTS | hello good morning milars | 948.441 | 1 |  |  |  |  | 2000 | Speaker | TTS | hello | 294.811 | 1 |  | 4031 | Microphone | STT | None | 16.929 | 0 | 56 | Screen-Motion | DO_MOTION | right_r | 62.182 | 0
2003 | Speaker | TTS | hello good morning milars | 853.9 | 1 |  |  |  |  | 2001 | Speaker | TTS | hello | 258.091 | 1 |  | 4032 | Microphone | STT | None | 5.589 | 0 | 57 | Screen-Motion | DO_MOTION | right_r | 62.911 | 0
2005 | Speaker | TTS | hello good morning milars | 786.964 | 1 |  |  |  |  | 2002 | Speaker | TTS | hello | 245.166 | 1 |  | 4033 | Microphone | STT | None | 8.291 | 0 | 58 | Screen-Motion | DO_MOTION | right_d | 62.177 | 0
2005 | Speaker | TTS | hello good morning milars | 834.437 | 1 |  |  |  |  | 2003 | Speaker | TTS | what is your name | 494.641 | 1 |  | 4034 | Microphone | STT | None | 5.706 | 0 | 59 | Screen-Motion | DO_MOTION | right_d | 62.159 | 0
2002 | Speaker | TTS | hello good morning milars | 1000.489 | 1 |  |  |  |  | 2004 | Speaker | TTS | hello i am your robots | 719.661 | 1 |  | 4035 | Microphone | STT | None | 17.471 | 0 | 60 | Screen-Motion | DO_MOTION | right_d | 62.128 | 0
2000 | Speaker | TTS | hello good morning milars | 732.551 | 1 |  |  |  |  | 2005 | Speaker | TTS | hello i am your robots | 668.802 | 1 |  | 4036 | Microphone | STT | None | 6.256 | 0 | 61 | Screen-Motion | DO_MOTION | right_l | 62.13 | 0
2001 | Speaker | TTS | hello good morning milars | 687.22 | 1 |  |  |  |  | 2006 | Speaker | TTS | hello i am your robots | 756.284 | 1 |  | 4037 | Microphone | STT | None | 14.84 | 0 | 62 | Screen-Motion | DO_MOTION | right_l | 62.151 | 0
2002 | Speaker | TTS | hello good morning milars | 665.649 | 1 |  |  |  |  | 2007 | Speaker | TTS | today is sunday | 708.693 | 1 |  | 4038 | Microphone | STT | None | 8.206 | 0 | 63 | Screen-Motion | DO_MOTION | right_u | 64.784 | 0
2003 | Speaker | TTS | hello good morning milars | 682.15 | 1 |  |  |  |  | 2008 | Speaker | TTS | do motion hello | 490.73 | 1 |  | 4039 | Microphone | STT | None | 7.849 | 0 | 64 | Screen-Motion | DO_MOTION | right_u | 63.02 | 0
2004 | Speaker | TTS | hello good morning milars | 667.23 | 1 |  |  |  |  | 2009 | Speaker | TTS | hello good morning milars | 651.648 | 1 |  | 4040 | Microphone | STT | None | 6.345 | 0 | 65 | Screen-Motion | DO_MOTION | right_r | 62.165 | 0
2005 | Speaker | TTS | hello good morning milars | 709.991 | 1 |  |  |  |  | 2010 | Speaker | TTS | hello good morning milars | 679.285 | 1 |  | 4041 | Microphone | STT | None | 12.199 | 0 | 66 | Screen-Motion | DO_MOTION | right_r | 65.278 | 0
2006 | Speaker | TTS | hello good morning milars | 652.266 | 1 |  |  |  |  | 2011 | Speaker | TTS | hello good morning milars | 585.592 | 1 |  | 4042 | Microphone | STT | None | 7.229 | 0 | 67 | Screen-Motion | DO_MOTION | right_d | 64.894 | 0
2007 | Speaker | TTS | hello good morning milars | 689.146 | 1 |  |  |  |  | 2012 | Speaker | TTS | please update background first | 843.143 | 1 |  | 4043 | Microphone | STT | None | 6.535 | 0 | 68 | Screen-Motion | DO_MOTION | right_d | 62.174 | 0
2008 | Speaker | TTS | hello good morning milars | 653.689 | 1 |  |  |  |  | 2013 | Speaker | TTS | please update background first | 871.211 | 1 |  | 4044 | Microphone | STT | None | 7.865 | 0 | 69 | Screen-Motion | DO_MOTION | right_l | 62.253 | 0
2000 | Speaker | TTS | hello good morning milars | 805.847 | 1 |  |  |  |  | 2014 | Speaker | TTS | please update background first | 915.094 | 1 |  | 4045 | Microphone | STT | None | 7.567 | 0 | 70 | Screen-Motion | DO_MOTION | right_l | 62.182 | 0
2001 | Speaker | TTS | hello good morning milars | 882.967 | 1 |  |  |  |  | 2015 | Speaker | TTS | background update successfully | 867.032 | 1 |  | 4046 | Microphone | STT | None | 6.866 | 0 | 71 | Screen-Motion | DO_MOTION | right_u | 62.181 | 0
2000 | Speaker | TTS | hello good morning milars | 1200.836 | 1 |  |  |  |  | 2016 | Speaker | TTS | background update successfully | 957.056 | 1 |  | 4047 | Microphone | STT | None | 9.836 | 0 | 72 | Screen-Motion | DO_MOTION | right_u | 66.903 | 0
2005 | Speaker | TTS | hello good morning milars | 941.032 | 1 |  |  |  |  | 2017 | Speaker | TTS | background update successfully | 779.804 | 1 |  | 4048 | Microphone | STT | None | 9.605 | 0 | 73 | Screen-Motion | DO_MOTION | right_r | 62.218 | 0
2015 | Speaker | TTS | good bye milars | 542.829 | 1 |  |  |  |  | 2018 | Speaker | TTS | learn object can successfully | 736.79 | 1 |  | 4049 | Microphone | STT | None | 6.562 | 0 | 74 | Screen-Motion | DO_MOTION | right_r | 62.698 | 0
2002 | Speaker | TTS | good bye milars | 540.243 | 1 |  |  |  |  | 2019 | Speaker | TTS | learn object can successfully | 751.299 | 1 |  | 4050 | Microphone | STT | None | 6.953 | 0 | 75 | Screen-Motion | DO_MOTION | right_d | 64.305 | 0
2025 | Speaker | TTS | do motionnine | 492.832 | 1 |  |  |  |  | 2020 | Speaker | TTS | learn object can successfully | 702.528 | 1 |  | 4051 | Microphone | STT | None | 6.61 | 0 | 76 | Screen-Motion | DO_MOTION | right_d | 62.141 | 0
2029 | Speaker | TTS | do motionnine | 492.056 | 1 |  |  |  |  | 2021 | Speaker | TTS | i know how to dance | 671.738 | 1 |  | 4052 | Microphone | STT | None | 7.204 | 0 | 77 | Screen-Motion | DO_MOTION | right_l | 65.172 | 0
2030 | Speaker | TTS | do motionnine | 515.666 | 1 |  |  |  |  | 2022 | Speaker | TTS | i know how to dance | 615.813 | 1 |  | 4053 | Microphone | STT | None | 5.848 | 0 | 78 | Screen-Motion | DO_MOTION | right_l | 66.798 | 0
2023 | Speaker | TTS | do motioneight | 491.015 | 1 |  |  |  |  | 2023 | Speaker | TTS | i know how to hello | 558.775 | 1 |  | 4054 | Microphone | STT | None | 12.677 | 0 | 79 | Screen-Motion | DO_MOTION | right_l | 64.341 | 0
2013 | Speaker | TTS | do motion bush | 724.731 | 1 |  |  |  |  | 2024 | Speaker | TTS | i know how to hello | 623.565 | 1 |  | 4055 | Microphone | STT | None | 6.421 | 0 | 80 | Screen-Motion | DO_MOTION | right_l | 62.152 | 0
2002 | Speaker | TTS | can not findii | 771.132 | 1 |  |  |  |  | 2025 | Speaker | TTS | i know how to fly | 577.501 | 1 |  | 4056 | Microphone | STT | None | 6.967 | 0 | 81 | Screen-Motion | DO_MOTION | right_l | 62.208 | 0
2001 | Speaker | TTS | can not findcan | 761.819 | 1 |  |  |  |  | 2026 | Speaker | TTS | good bye milars | 445.167 | 1 |  | 4057 | Microphone | STT | None | 8.919 | 0 | 82 | Screen-Motion | DO_MOTION | right_l | 62.209 | 0
2001 | Speaker | TTS | can not findcan | 786.794 | 1 |  |  |  |  | 2027 | Speaker | TTS | good bye milars | 446.771 | 1 |  | 4058 | Microphone | STT | None | 7.719 | 0 | 83 | Screen-Motion | DO_MOTION | right_r | 62.12 | 0
2007 | Speaker | TTS | can not findbottom | 856.981 | 1 |  |  |  |  | 2028 | Speaker | TTS | good bye milars | 468.137 | 1 |  | 4059 | Microphone | STT | None | 7.068 | 0 | 84 | Screen-Motion | DO_MOTION | right_r | 62.139 | 0
2008 | Speaker | TTS | can not findbottom | 950.246 | 1 |  |  |  |  | 2029 | Speaker | TTS | sorry i didn't understand that | 911.008 | 1 |  | 4060 | Microphone | STT | None | 10.755 | 0 | 85 | Screen-Motion | DO_MOTION | right_r | 62.174 | 0
2000 | Speaker | TTS | background update successfully | 1143.367 | 1 |  |  |  |  | 2030 | Speaker | TTS | sorry i didn't understand that | 985.706 | 1 |  | 4061 | Microphone | STT | None | 8.366 | 0 | 86 | Screen-Motion | DO_MOTION | right_r | 62.182 | 0
2000 | Speaker | TTS | background update successfully | 1284.303 | 1 |  |  |  |  | 2031 | Speaker | TTS | sorry i didn't understand that | 1401.728 | 1 |  | 4062 | Microphone | STT | None | 8.147 | 0 | 87 | Screen-Motion | DO_MOTION | right_d | 62.17 | 0
2000 | Speaker | TTS | background update successfully | 1335.534 | 1 |  |  |  |  | 2000 | Speaker | TTS | hello | 374.273 | 1 |  | 4063 | Microphone | STT | None | 6.504 | 0 | 88 | Screen-Motion | DO_MOTION | right_u | 62.121 | 0
2000 | Speaker | TTS | background update successfully | 1059.572 | 1 |  |  |  |  | 2001 | Speaker | TTS | hello | 301.829 | 1 |  | 4064 | Microphone | STT | None | 7.69 | 0 | 89 | Screen-Motion | DO_MOTION | right_r | 62.138 | 0
2000 | Speaker | TTS | background update successfully | 1435.192 | 1 |  |  |  |  | 2002 | Speaker | TTS | hello | 240.053 | 1 |  | 4065 | Microphone | STT | None | 7.315 | 0 | 90 | Screen-Motion | DO_MOTION | right_d | 62.133 | 0
2000 | Speaker | TTS | background update successfully | 1096.952 | 1 |  |  |  |  | 2003 | Speaker | TTS | what is your name | 521.01 | 1 |  | 4066 | Microphone | STT | None | 13.943 | 0 | 91 | Screen-Motion | DO_MOTION | right_u | 62.133 | 0
2000 | Speaker | TTS | background update successfully | 1517.538 | 1 |  |  |  |  | 2004 | Speaker | TTS | hello i am your robots | 765.699 | 1 |  | 4067 | Microphone | STT | by | 14.246 | 1 | 92 | Screen-Motion | DO_MOTION | right_r | 62.399 | 0
2000 | Speaker | TTS | background update successfully | 1149.99 | 1 |  |  |  |  | 2005 | Speaker | TTS | hello i am your robots | 468.945 | 1 |  | 4068 | Microphone | STT | None | 7.316 | 0 | 93 | Screen-Motion | DO_MOTION | right_d | 62.179 | 0
2000 | Speaker | TTS | background update successfully | 1078.595 | 1 |  |  |  |  | 2006 | Speaker | TTS | hello i am your robots | 326.96 | 1 |  | 4069 | Microphone | STT | None | 7.343 | 0 | 94 | Screen-Motion | DO_MOTION | right_u | 62.158 | 0
2000 | Speaker | TTS | background update successfully | 1183.019 | 1 |  |  |  |  | 2007 | Speaker | TTS | today is sunday | 739.832 | 1 |  | 4070 | Microphone | STT | None | 8.184 | 0 | 95 | Screen-Motion | DO_MOTION | right_r | 66.526 | 0
2000 | Speaker | TTS | background update successfully | 1252.389 | 1 |  |  |  |  | 2008 | Speaker | TTS | do motion hello | 454.165 | 1 |  | 4071 | Microphone | STT | None | 7.58 | 0 | 96 | Screen-Motion | DO_MOTION | right_d | 66.851 | 0
2000 | Speaker | TTS | background update successfully | 1061.837 | 1 |  |  |  |  | 2009 | Speaker | TTS | hello good morning milars | 574.882 | 1 |  | 4072 | Microphone | STT | None | 8.149 | 0 | 97 | Screen-Motion | DO_MOTION | right_u | 62.121 | 0
2000 | Speaker | TTS | background update successfully | 1096.197 | 1 |  |  |  |  | 2010 | Speaker | TTS | hello good morning milars | 0.085 | 1 |  | 4073 | Microphone | STT | None | 8.101 | 0 | 98 | Screen-Motion | DO_MOTION | right_l | 64.273 | 0
2000 | Speaker | TTS | background update successfully | 1185.962 | 1 |  |  |  |  | 2011 | Speaker | TTS | hello good morning milars | 0.125 | 1 |  | 4074 | Microphone | STT | None | 6.964 | 0 | 99 | Screen-Motion | DO_MOTION | right_r | 64.235 | 0
2001 | Speaker | TTS | background update successfully | 1266.932 | 1 |  |  |  |  | 2012 | Speaker | TTS | hello good morning milars | 0.094 | 1 |  | 4075 | Microphone | STT | None | 8.981 | 0 | 100 | Screen-Motion | DO_MOTION | right_d | 63.436 | 0
2014 | Speaker | TTS | background update successfully | 1101.754 | 1 |  |  |  |  | 2013 | Speaker | TTS | hello good morning milars | 0.078 | 1 |  | 4076 | Microphone | STT | None | 11.557 | 0 | 101 | Screen-Motion | DO_MOTION | right_u | 62.095 | 0
2015 | Speaker | TTS | background update successfully | 1583.753 | 1 |  |  |  |  | 2014 | Speaker | TTS | hello good morning milars | 0.088 | 1 |  | 4077 | Microphone | STT | None | 5.597 | 0 | 102 | Screen-Motion | DO_MOTION | left_r | 62.359 | 0
2016 | Speaker | TTS | background update successfully | 2150.982 | 1 |  |  |  |  | 2015 | Speaker | TTS | please update background first | 820.087 | 1 |  | 4078 | Microphone | STT | None | 13.617 | 0 | 103 | Screen-Motion | DO_MOTION | left_d | 62.101 | 0
2017 | Speaker | TTS | background update successfully | 2274.52 | 1 |  |  |  |  | 2016 | Speaker | TTS | please update background first | 802.156 | 1 |  | 4079 | Microphone | STT | None | 7.262 | 0 | 104 | Screen-Motion | DO_MOTION | left_l | 62.168 | 0
2018 | Speaker | TTS | background update successfully | 1709.971 | 1 |  |  |  |  | 2017 | Speaker | TTS | please update background first | 892.181 | 1 |  | 4080 | Microphone | STT | None | 0.975 | 0 | 105 | Screen-Motion | DO_MOTION | left_l | 62.27 | 0
2019 | Speaker | TTS | background update successfully | 1859.384 | 1 |  |  |  |  | 2018 | Speaker | TTS | background update successfully | 983.189 | 1 |  | 4081 | Microphone | STT | None | 4.282 | 0 | 106 | Screen-Motion | DO_MOTION | left_d | 66.54 | 0
0 | Screen-Motion | DO_MOTION | left_u | 63.086 | 0 |  |  |  |  | 2019 | Speaker | TTS | background update successfully | 981.212 | 1 |  | 4082 | Microphone | STT | None | 3.296 | 0 | 107 | Screen-Motion | DO_MOTION | left_r | 62.191 | 0
1 | Screen-Motion | DO_MOTION | left_u | 67.888 | 0 |  |  |  |  | 2020 | Speaker | TTS | background update successfully | 978.224 | 1 |  | 4083 | Microphone | STT | None | 7.173 | 0 | 108 | Screen-Motion | DO_MOTION | left_u | 62.176 | 0
2 | Screen-Motion | DO_MOTION | left_u | 65.791 | 0 |  |  |  |  | 2021 | Speaker | TTS | learn object can successfully | 976.241 | 1 |  | 4084 | Microphone | STT | None | 6.033 | 0 | 109 | Screen-Motion | DO_MOTION | left_d | 62.123 | 0
3 | Screen-Motion | DO_MOTION | left_u | 66.626 | 0 |  |  |  |  | 2022 | Speaker | TTS | learn object can successfully | 649.265 | 1 |  | 4085 | Microphone | STT | None | 3.205 | 0 | 110 | Screen-Motion | DO_MOTION | left_l | 62.106 | 0
4 | Screen-Motion | DO_MOTION | left_u | 66.35 | 0 |  |  |  |  | 2023 | Speaker | TTS | learn object can successfully | 368.276 | 1 |  | 4086 | Microphone | STT | None | 9.52 | 0 | 111 | Screen-Motion | DO_MOTION | left_u | 64.128 | 0
5 | Screen-Motion | DO_MOTION | left_u | 67.598 | 0 |  |  |  |  | 2024 | Speaker | TTS | learn object can successfully | 87.29 | 1 |  | 4087 | Microphone | STT | None | 11.797 | 0 | 112 | Screen-Motion | DO_MOTION | left_r | 62.253 | 0
6 | Screen-Motion | DO_MOTION | left_u | 65.353 | 0 |  |  |  |  | 2025 | Speaker | TTS | learn object can successfully | 0.086 | 1 |  | 4088 | Microphone | STT | None | 8.423 | 0 | 113 | Screen-Motion | DO_MOTION | left_d | 62.133 | 0
7 | Screen-Motion | DO_MOTION | left_u | 63.639 | 0 |  |  |  |  | 2026 | Speaker | TTS | learn object can successfully | 0.098 | 1 |  | 4089 | Microphone | STT | None | 4.843 | 0 | 114 | Screen-Motion | DO_MOTION | left_l | 62.191 | 0
8 | Screen-Motion | DO_MOTION | left_u | 69.562 | 0 |  |  |  |  | 2027 | Speaker | TTS | i know how to dance | 705.715 | 1 |  | 4090 | Microphone | STT | None | 10.396 | 0 | 115 | Screen-Motion | DO_MOTION | left_u | 64.145 | 0
9 | Screen-Motion | DO_MOTION | left_u | 65.528 | 0 |  |  |  |  | 2028 | Speaker | TTS | i know how to dance | 315.407 | 1 |  | 4091 | Microphone | STT | None | 7.121 | 0 | 116 | Screen-Motion | DO_MOTION | left_r | 62.151 | 0
10 | Screen-Motion | DO_MOTION | left_u | 65.521 | 0 |  |  |  |  | 2029 | Speaker | TTS | i know how to hello | 587.782 | 1 |  | 4092 | Microphone | STT | None | 11.802 | 0 | 117 | Screen-Motion | DO_MOTION | left_d | 62.225 | 0
11 | Screen-Motion | DO_MOTION | left_u | 65.964 | 0 |  |  |  |  | 2030 | Speaker | TTS | i know how to hello | 0.091 | 1 |  | 4093 | Microphone | STT | None | 6.552 | 0 | 118 | Screen-Motion | DO_MOTION | left_l | 63.597 | 0
12 | Screen-Motion | DO_MOTION | left_u | 66.253 | 0 |  |  |  |  | 2031 | Speaker | TTS | i know how to fly | 579.114 | 1 |  | 4094 | Microphone | STT | None | 5.572 | 0 | 119 | Screen-Motion | DO_MOTION | left_u | 62.209 | 0
13 | Screen-Motion | DO_MOTION | left_u | 64.076 | 0 |  |  |  |  | 2032 | Speaker | TTS | good bye milars | 465.295 | 1 |  | 4095 | Microphone | STT | None | 6.12 | 0 | 120 | Screen-Motion | DO_MOTION | left_r | 62.154 | 0
14 | Screen-Motion | DO_MOTION | left_u | 62.2 | 0 |  |  |  |  | 2033 | Speaker | TTS | good bye milars | 462.459 | 1 |  | 4096 | Microphone | STT | None | 5.838 | 0 | 121 | Screen-Motion | DO_MOTION | left_d | 66.405 | 0
15 | Screen-Motion | DO_MOTION | left_d | 66.186 | 0 |  |  |  |  | 2034 | Speaker | TTS | good bye milars | 526.323 | 1 |  | 4097 | Microphone | STT | None | 8.304 | 0 | 122 | Screen-Motion | DO_MOTION | left_l | 62.242 | 0
16 | Screen-Motion | DO_MOTION | left_d | 66.225 | 0 |  |  |  |  | 2035 | Speaker | TTS | sorry i didn't understand that | 807.985 | 1 |  | 4098 | Microphone | STT | None | 5.543 | 0 | 123 | Screen-Motion | DO_MOTION | left_u | 63.412 | 0
17 | Screen-Motion | DO_MOTION | left_d | 62.134 | 0 |  |  |  |  | 2036 | Speaker | TTS | sorry i didn't understand that | 789.662 | 1 |  | 4099 | Microphone | STT | None | 5.823 | 0 | 124 | Screen-Motion | DO_MOTION | left_r | 65.285 | 0
18 | Screen-Motion | DO_MOTION | left_d | 62.212 | 0 |  |  |  |  | 2037 | Speaker | TTS | sorry i didn't understand that | 926.688 | 1 |  | 4100 | Microphone | STT | None | 5.733 | 0 | 125 | Screen-Motion | DO_MOTION | left_d | 66.222 | 0
19 | Screen-Motion | DO_MOTION | left_d | 62.488 | 0 |  |  |  |  | 2038 | Speaker | TTS | sorry i didn't understand that | 1063.712 | 1 |  | 4101 | Microphone | STT | None | 5.621 | 0 | 126 | Screen-Motion | DO_MOTION | left_l | 64.303 | 0
20 | Screen-Motion | DO_MOTION | left_d | 67.619 | 0 |  |  |  |  | 2039 | Speaker | TTS | sorry i didn't understand that | 1154.783 | 1 |  | 4102 | Microphone | STT | None | 11.618 | 0 | 127 | Screen-Motion | DO_MOTION | left_u | 64.35 | 0
21 | Screen-Motion | DO_MOTION | left_d | 65.205 | 0 |  |  |  |  | 2040 | Speaker | TTS | sorry i didn't understand that | 1291.761 | 1 |  | 4103 | Microphone | STT | None | 13.708 | 0 | 128 | Screen-Motion | DO_MOTION | left_r | 64.212 | 0
22 | Screen-Motion | DO_MOTION | left_d | 67.028 | 0 |  |  |  |  | 2000 | Speaker | TTS | hello | 243.847 | 1 |  | 4104 | Microphone | STT | None | 5.921 | 0 | 129 | Screen-Motion | DO_MOTION | left_d | 62.164 | 0
23 | Screen-Motion | DO_MOTION | left_d | 64.875 | 0 |  |  |  |  | 2001 | Speaker | TTS | hello | 215.124 | 1 |  | 4105 | Microphone | STT | None | 14.058 | 0 | 130 | Screen-Motion | DO_MOTION | left_l | 62.385 | 0
24 | Screen-Motion | DO_MOTION | left_d | 65.181 | 0 |  |  |  |  | 2002 | Speaker | TTS | hello | 271.137 | 1 |  | 4106 | Microphone | STT | None | 10.435 | 0 | 131 | Screen-Motion | DO_MOTION | left_u | 64.313 | 0
25 | Screen-Motion | DO_MOTION | left_d | 68.11 | 0 |  |  |  |  | 2003 | Speaker | TTS | what is your name | 493.343 | 1 |  | 4107 | Microphone | STT | None | 10.951 | 0 | 132 | Screen-Motion | DO_MOTION | left_r | 62.184 | 0
26 | Screen-Motion | DO_MOTION | left_d | 62.162 | 0 |  |  |  |  | 2004 | Speaker | TTS | hello i am your robots | 787.8 | 1 |  | 4108 | Microphone | STT | None | 11.099 | 0 | 133 | Screen-Motion | DO_MOTION | left_d | 62.337 | 0
27 | Screen-Motion | DO_MOTION | left_d | 62.534 | 0 |  |  |  |  | 2005 | Speaker | TTS | hello i am your robots | 630.199 | 1 |  | 4109 | Microphone | STT | None | 9.088 | 0 | 134 | Screen-Motion | DO_MOTION | left_l | 62.116 | 0
28 | Screen-Motion | DO_MOTION | left_d | 63.835 | 0 |  |  |  |  | 2006 | Speaker | TTS | hello i am your robots | 582.229 | 1 |  | 4110 | Microphone | STT | None | 8.732 | 0 | 135 | Screen-Motion | DO_MOTION | left_u | 62.128 | 0
29 | Screen-Motion | DO_MOTION | left_d | 62.141 | 0 |  |  |  |  | 2007 | Speaker | TTS | today is sunday | 647.137 | 1 |  | 4111 | Microphone | STT | None | 12.782 | 0 | 136 | Screen-Motion | DO_MOTION | left_r | 62.227 | 0
30 | Screen-Motion | DO_MOTION | left_u | 64.682 | 0 |  |  |  |  | 2008 | Speaker | TTS | do motion hello | 468.46 | 1 |  | 4112 | Microphone | STT | None | 11.022 | 0 | 137 | Screen-Motion | DO_MOTION | left_d | 62.226 | 0
31 | Screen-Motion | DO_MOTION | left_u | 62.14 | 0 |  |  |  |  | 2009 | Speaker | TTS | hello good morning milars | 582.85 | 1 |  | 4113 | Microphone | STT | None | 6.663 | 0 | 138 | Screen-Motion | DO_MOTION | left_l | 62.265 | 0
32 | Screen-Motion | DO_MOTION | left_u | 62.094 | 0 |  |  |  |  | 2010 | Speaker | TTS | hello good morning milars | 0.09 | 1 |  | 4114 | Microphone | STT | None | 10.86 | 0 | 139 | Screen-Motion | DO_MOTION | left_u | 62.186 | 0
33 | Screen-Motion | DO_MOTION | left_u | 62.131 | 0 |  |  |  |  | 2011 | Speaker | TTS | hello good morning milars | 0.099 | 1 |  | 4115 | Microphone | STT | None | 9.206 | 0 | 140 | Screen-Motion | DO_MOTION | left_r | 62.144 | 0
34 | Screen-Motion | DO_MOTION | left_u | 64.187 | 0 |  |  |  |  | 2012 | Speaker | TTS | hello good morning milars | 0.109 | 1 |  | 4116 | Microphone | STT | None | 6.069 | 0 | 141 | Screen-Motion | DO_MOTION | left_d | 62.361 | 0
35 | Screen-Motion | DO_MOTION | left_u | 62.1 | 0 |  |  |  |  | 2013 | Speaker | TTS | hello good morning milars | 0.102 | 1 |  | 4117 | Microphone | STT | None | 8.406 | 0 | 142 | Screen-Motion | DO_MOTION | left_l | 62.116 | 0
36 | Screen-Motion | DO_MOTION | left_u | 62.123 | 0 |  |  |  |  | 2014 | Speaker | TTS | hello good morning milars | 0.113 | 1 |  | 4118 | Microphone | STT | None | 11.3 | 0 | 143 | Screen-Motion | DO_MOTION | left_u | 62.216 | 0
37 | Screen-Motion | DO_MOTION | left_u | 72.298 | 0 |  |  |  |  | 2015 | Speaker | TTS | please update background first | 909.91 | 1 |  | 4119 | Microphone | STT | None | 6.715 | 0 | 144 | Screen-Motion | DO_MOTION | left_r | 62.091 | 0
38 | Screen-Motion | DO_MOTION | left_u | 62.143 | 0 |  |  |  |  | 2016 | Speaker | TTS | please update background first | 1031.156 | 1 |  | 4120 | Microphone | STT | None | 11.492 | 0 | 145 | Screen-Motion | DO_MOTION | left_d | 62.166 | 0
39 | Screen-Motion | DO_MOTION | left_u | 62.177 | 0 |  |  |  |  | 2017 | Speaker | TTS | please update background first | 1308.201 | 1 |  | 4121 | Microphone | STT | None | 11.754 | 0 | 146 | Screen-Motion | DO_MOTION | left_l | 62.619 | 0
40 | Screen-Motion | DO_MOTION | left_u | 62.322 | 0 |  |  |  |  | 2018 | Speaker | TTS | background update successfully | 1631.231 | 1 |  | 4122 | Microphone | STT | None | 6.56 | 0 | 147 | Screen-Motion | DO_MOTION | right_u | 62.234 | 0
41 | Screen-Motion | DO_MOTION | left_u | 66.008 | 0 |  |  |  |  | 2019 | Speaker | TTS | background update successfully | 1582.248 | 1 |  | 4123 | Microphone | STT | None | 12.904 | 0 | 148 | Screen-Motion | DO_MOTION | right_l | 62.12 | 0
42 | Screen-Motion | DO_MOTION | left_u | 62.082 | 0 |  |  |  |  | 2020 | Speaker | TTS | background update successfully | 1580.269 | 1 |  | 4124 | Microphone | STT | None | 14.446 | 0 | 149 | Screen-Motion | DO_MOTION | right_d | 62.158 | 0
43 | Screen-Motion | DO_MOTION | left_u | 62.239 | 0 |  |  |  |  | 2021 | Speaker | TTS | learn object can successfully | 1577.301 | 1 |  | 4125 | Microphone | STT | None | 10.631 | 0 | 150 | Screen-Motion | DO_MOTION | right_r | 62.131 | 0
44 | Screen-Motion | DO_MOTION | right_d | 65.39 | 0 |  |  |  |  | 2022 | Speaker | TTS | learn object can successfully | 1482.314 | 1 |  | 4126 | Microphone | STT | None | 13.08 | 0 | 151 | Screen-Motion | DO_MOTION | right_u | 65.995 | 0
45 | Screen-Motion | DO_MOTION | right_d | 64.336 | 0 |  |  |  |  | 2023 | Speaker | TTS | learn object can successfully | 1433.344 | 1 |  | 4127 | Microphone | STT | None | 10.032 | 0 | 152 | Screen-Motion | DO_MOTION | right_l | 62.857 | 0
46 | Screen-Motion | DO_MOTION | right_d | 62.084 | 0 |  |  |  |  | 2024 | Speaker | TTS | learn object can successfully | 1338.177 | 1 |  | 4128 | Microphone | STT | None | 12.608 | 0 | 153 | Screen-Motion | DO_MOTION | right_d | 62.189 | 0
47 | Screen-Motion | DO_MOTION | right_d | 71.658 | 0 |  |  |  |  | 2025 | Speaker | TTS | learn object can successfully | 1243.187 | 1 |  | 4129 | Microphone | STT | None | 7.247 | 0 | 154 | Screen-Motion | DO_MOTION | right_r | 62.134 | 0
48 | Screen-Motion | DO_MOTION | right_d | 62.123 | 0 |  |  |  |  | 2026 | Speaker | TTS | learn object can successfully | 1148.203 | 1 |  | 4130 | Microphone | STT | None | 10.82 | 0 | 155 | Screen-Motion | DO_MOTION | right_u | 62.164 | 0
49 | Screen-Motion | DO_MOTION | right_d | 69.846 | 0 |  |  |  |  | 2027 | Speaker | TTS | i know how to dance | 1099.196 | 1 |  | 4131 | Microphone | STT | None | 8.28 | 0 | 156 | Screen-Motion | DO_MOTION | right_l | 62.185 | 0
50 | Screen-Motion | DO_MOTION | right_d | 64.697 | 0 |  |  |  |  | 2028 | Speaker | TTS | i know how to dance | 864.206 | 1 |  | 4132 | Microphone | STT | None | 8.199 | 0 | 157 | Screen-Motion | DO_MOTION | right_d | 62.198 | 0
51 | Screen-Motion | DO_MOTION | right_d | 62.147 | 0 |  |  |  |  | 2029 | Speaker | TTS | i know how to hello | 684.935 | 1 |  | 4133 | Microphone | STT | None | 15.516 | 0 | 158 | Screen-Motion | DO_MOTION | right_r | 62.214 | 0
52 | Screen-Motion | DO_MOTION | right_d | 65.693 | 0 |  |  |  |  | 2030 | Speaker | TTS | i know how to hello | 349.229 | 1 |  | 4134 | Microphone | STT | None | 14.028 | 0 | 159 | Screen-Motion | DO_MOTION | right_u | 67.664 | 0
53 | Screen-Motion | DO_MOTION | right_d | 68.836 | 0 |  |  |  |  | 2031 | Speaker | TTS | i know how to fly | 501.421 | 1 |  | 4135 | Microphone | STT | None | 17.802 | 0 | 160 | Screen-Motion | DO_MOTION | right_l | 62.177 | 0
54 | Screen-Motion | DO_MOTION | right_u | 64.257 | 0 |  |  |  |  | 2032 | Speaker | TTS | good bye milars | 437.207 | 1 |  | 4136 | Microphone | STT | None | 13.65 | 0 | 161 | Screen-Motion | DO_MOTION | right_d | 63.973 | 0
55 | Screen-Motion | DO_MOTION | right_u | 63.676 | 0 |  |  |  |  | 2033 | Speaker | TTS | good bye milars | 453.346 | 1 |  | 4137 | Microphone | STT | None | 9.04 | 0 | 162 | Screen-Motion | DO_MOTION | right_r | 64.023 | 0
56 | Screen-Motion | DO_MOTION | right_u | 62.145 | 0 |  |  |  |  | 2034 | Speaker | TTS | good bye milars | 514.16 | 1 |  | 4138 | Microphone | STT | None | 13.14 | 0 | 163 | Screen-Motion | DO_MOTION | right_u | 63.926 | 0
57 | Screen-Motion | DO_MOTION | right_u | 64.361 | 0 |  |  |  |  | 2035 | Speaker | TTS | sorry i didn't understand that | 854.211 | 1 |  | 4139 | Microphone | STT | None | 16.442 | 0 | 164 | Screen-Motion | DO_MOTION | right_l | 63.218 | 0
58 | Screen-Motion | DO_MOTION | right_u | 62.127 | 0 |  |  |  |  | 2036 | Speaker | TTS | sorry i didn't understand that | 975.431 | 1 |  | 4140 | Microphone | STT | None | 7.843 | 0 | 165 | Screen-Motion | DO_MOTION | right_d | 63.967 | 0
59 | Screen-Motion | DO_MOTION | right_u | 62.203 | 0 |  |  |  |  | 2037 | Speaker | TTS | sorry i didn't understand that | 1205.465 | 1 |  | 4141 | Microphone | STT | None | 11.429 | 0 | 166 | Screen-Motion | DO_MOTION | right_r | 63.966 | 0
60 | Screen-Motion | DO_MOTION | right_u | 62.189 | 0 |  |  |  |  | 2038 | Speaker | TTS | sorry i didn't understand that | 1435.505 | 1 |  | 4142 | Microphone | STT | None | 15.704 | 0 | 167 | Screen-Motion | DO_MOTION | right_u | 62.147 | 0
61 | Screen-Motion | DO_MOTION | right_u | 65.021 | 0 |  |  |  |  | 2039 | Speaker | TTS | sorry i didn't understand that | 1665.576 | 1 |  | 4143 | Microphone | STT | None | 9.567 | 0 | 168 | Screen-Motion | DO_MOTION | right_l | 62.143 | 0
62 | Screen-Motion | DO_MOTION | right_u | 62.136 | 0 |  |  |  |  | 2040 | Speaker | TTS | sorry i didn't understand that | 1942.571 | 1 |  | 4144 | Microphone | STT | None | 10.013 | 0 | 169 | Screen-Motion | DO_MOTION | right_d | 62.202 | 0
63 | Screen-Motion | DO_MOTION | right_u | 63.696 | 0 |  |  |  |  | 2000 | Speaker | TTS | hello | 274.649 | 1 |  | 4145 | Microphone | STT | None | 12.036 | 0 | 170 | Screen-Motion | DO_MOTION | right_r | 65.775 | 0
64 | Screen-Motion | DO_MOTION | right_d | 64.151 | 0 |  |  |  |  | 2001 | Speaker | TTS | hello | 224.67 | 1 |  | 4146 | Microphone | STT | None | 15.637 | 0 | 171 | Screen-Motion | DO_MOTION | right_u | 62.151 | 0
65 | Screen-Motion | DO_MOTION | right_d | 62.586 | 0 |  |  |  |  | 2002 | Speaker | TTS | hello | 264.905 | 1 |  | 4147 | Microphone | STT | None | 10.02 | 0 | 172 | Screen-Motion | DO_MOTION | left_u | 62.597 | 0
66 | Screen-Motion | DO_MOTION | right_d | 66.284 | 0 |  |  |  |  | 2003 | Speaker | TTS | what is your name | 404.42 | 1 |  | 4148 | Microphone | STT | None | 9.653 | 0 | 173 | Screen-Motion | DO_MOTION | left_l | 62.242 | 0
67 | Screen-Motion | DO_MOTION | right_d | 64.931 | 0 |  |  |  |  | 2004 | Speaker | TTS | hello i am your robots | 759.833 | 1 |  | 4149 | Microphone | STT | None | 11.744 | 0 | 174 | Screen-Motion | DO_MOTION | left_r | 64.975 | 0
68 | Screen-Motion | DO_MOTION | right_d | 68.693 | 0 |  |  |  |  | 2005 | Speaker | TTS | hello i am your robots | 602.124 | 1 |  | 4150 | Microphone | STT | None | 15.401 | 0 | 175 | Screen-Motion | DO_MOTION | left_d | 62.134 | 0
69 | Screen-Motion | DO_MOTION | right_d | 65.337 | 0 |  |  |  |  | 2006 | Speaker | TTS | hello i am your robots | 554.126 | 1 |  | 4151 | Microphone | STT | None | 7.282 | 0 | 176 | Screen-Motion | DO_MOTION | left_r | 62.823 | 0
70 | Screen-Motion | DO_MOTION | right_d | 63.756 | 0 |  |  |  |  | 2007 | Speaker | TTS | today is sunday | 662.154 | 1 |  | 4152 | Microphone | STT | None | 8.126 | 0 | 177 | Screen-Motion | DO_MOTION | left_u | 65.861 | 0
71 | Screen-Motion | DO_MOTION | right_d | 62.124 | 0 |  |  |  |  | 2008 | Speaker | TTS | do motion hello | 559.5 | 1 |  | 4153 | Microphone | STT | None | 12.337 | 0 | 178 | Screen-Motion | DO_MOTION | left_l | 64.379 | 0
72 | Screen-Motion | DO_MOTION | right_d | 65.747 | 0 |  |  |  |  | 2009 | Speaker | TTS | hello good morning milars | 603.311 | 1 |  | 4154 | Microphone | STT | None | 14.279 | 0 | 179 | Screen-Motion | DO_MOTION | left_d | 64.046 | 0
73 | Screen-Motion | DO_MOTION | right_d | 62.707 | 0 |  |  |  |  | 2010 | Speaker | TTS | hello good morning milars | 27.197 | 1 |  | 4155 | Microphone | STT | None | 8.048 | 0 | 180 | Screen-Motion | DO_MOTION | left_r | 62.123 | 0
74 | Screen-Motion | DO_MOTION | right_d | 64.629 | 0 |  |  |  |  | 2011 | Speaker | TTS | hello good morning milars | 0.104 | 1 |  | 4156 | Microphone | STT | None | 14.212 | 0 | 181 | Screen-Motion | DO_MOTION | left_u | 66.658 | 0
75 | Screen-Motion | DO_MOTION | right_u | 69.149 | 0 |  |  |  |  | 2012 | Speaker | TTS | hello good morning milars | 0.113 | 1 |  | 4157 | Microphone | STT | None | 15.799 | 0 | 182 | Screen-Motion | DO_MOTION | right_u | 62.163 | 0
76 | Screen-Motion | DO_MOTION | right_u | 65.727 | 0 |  |  |  |  | 2013 | Speaker | TTS | hello good morning milars | 0.11 | 1 |  | 4158 | Microphone | STT | None | 7.559 | 0 | 183 | Screen-Motion | DO_MOTION | right_l | 62.231 | 0
77 | Screen-Motion | DO_MOTION | right_u | 62.419 | 0 |  |  |  |  | 2014 | Speaker | TTS | hello good morning milars | 0.118 | 1 |  | 4159 | Microphone | STT | None | 7.633 | 0 | 184 | Screen-Motion | DO_MOTION | right_d | 62.209 | 0
78 | Screen-Motion | DO_MOTION | right_u | 69.212 | 0 |  |  |  |  | 2015 | Speaker | TTS | please update background first | 837.807 | 1 |  | 4160 | Microphone | STT | None | 18.347 | 0 | 185 | Screen-Motion | DO_MOTION | right_r | 62.133 | 0
79 | Screen-Motion | DO_MOTION | right_u | 64.761 | 0 |  |  |  |  | 2016 | Speaker | TTS | please update background first | 772.395 | 1 |  | 4161 | Microphone | STT | None | 13.999 | 0 | 186 | Screen-Motion | DO_MOTION | right_u | 62.441 | 0
80 | Screen-Motion | DO_MOTION | right_u | 64.513 | 0 |  |  |  |  | 2017 | Speaker | TTS | please update background first | 863.432 | 1 |  | 4162 | Microphone | STT | None | 5.125 | 0 | 0 | Screen-Motion | DO_MOTION | left_l | 62.34 | 0
81 | Screen-Motion | DO_MOTION | right_u | 62.159 | 0 |  |  |  |  | 2018 | Speaker | TTS | background update successfully | 954.442 | 1 |  | 4163 | Microphone | STT | None | 10.788 | 0 | 1 | Screen-Motion | DO_MOTION | left_l | 62.004 | 0
82 | Screen-Motion | DO_MOTION | right_u | 65.087 | 0 |  |  |  |  | 2019 | Speaker | TTS | background update successfully | 1044.469 | 1 |  | 4164 | Microphone | STT | None | 12.274 | 0 | 2 | Screen-Motion | DO_MOTION | left_l | 62.015 | 0
83 | Screen-Motion | DO_MOTION | right_u | 64.359 | 0 |  |  |  |  | 2020 | Speaker | TTS | background update successfully | 1088.509 | 1 |  | 4165 | Microphone | STT | None | 12.755 | 0 | 3 | Screen-Motion | DO_MOTION | left_l | 62.011 | 0
84 | Screen-Motion | DO_MOTION | right_u | 63.73 | 0 |  |  |  |  | 2021 | Speaker | TTS | learn object can successfully | 1179.522 | 1 |  | 4166 | Microphone | STT | None | 18.711 | 0 | 4 | Screen-Motion | DO_MOTION | left_r | 62.015 | 0
85 | Screen-Motion | DO_MOTION | left_d | 64.362 | 0 |  |  |  |  | 2022 | Speaker | TTS | learn object can successfully | 898.542 | 1 |  | 4167 | Microphone | STT | None | 9.625 | 0 | 5 | Screen-Motion | DO_MOTION | left_r | 62.014 | 0
86 | Screen-Motion | DO_MOTION | left_d | 64.302 | 0 |  |  |  |  | 2023 | Speaker | TTS | learn object can successfully | 617.544 | 1 |  | 4168 | Microphone | STT | None | 14.541 | 0 | 6 | Screen-Motion | DO_MOTION | left_r | 63.069 | 0
87 | Screen-Motion | DO_MOTION | left_d | 67.085 | 0 |  |  |  |  | 2024 | Speaker | TTS | learn object can successfully | 336.555 | 1 |  | 4169 | Microphone | STT | None | 15.752 | 0 | 7 | Screen-Motion | DO_MOTION | left_r | 62.016 | 0
88 | Screen-Motion | DO_MOTION | left_d | 67.442 | 0 |  |  |  |  | 2025 | Speaker | TTS | learn object can successfully | 55.565 | 1 |  | 4170 | Microphone | STT | None | 13.102 | 0 | 8 | Screen-Motion | DO_MOTION | left_r | 62.011 | 0
89 | Screen-Motion | DO_MOTION | left_d | 64.184 | 0 |  |  |  |  | 2026 | Speaker | TTS | learn object can successfully | 0.096 | 1 |  | 4171 | Microphone | STT | None | 7.718 | 0 | 9 | Screen-Motion | DO_MOTION | left_u | 62.059 | 0
90 | Screen-Motion | DO_MOTION | left_d | 65.342 | 0 |  |  |  |  | 2027 | Speaker | TTS | i know how to dance | 649.429 | 1 |  | 4172 | Microphone | STT | None | 15.007 | 0 | 10 | Screen-Motion | DO_MOTION | left_u | 62.016 | 0
91 | Screen-Motion | DO_MOTION | left_d | 62.124 | 0 |  |  |  |  | 2028 | Speaker | TTS | i know how to dance | 120.621 | 1 |  | 4173 | Microphone | STT | None | 11.806 | 0 | 11 | Screen-Motion | DO_MOTION | left_u | 62.023 | 0
92 | Screen-Motion | DO_MOTION | left_d | 62.131 | 0 |  |  |  |  | 2029 | Speaker | TTS | i know how to hello | 540.128 | 1 |  | 4174 | Microphone | STT | None | 16.065 | 0 | 12 | Screen-Motion | DO_MOTION | left_u | 62.016 | 0
93 | Screen-Motion | DO_MOTION | left_d | 62.135 | 0 |  |  |  |  | 2030 | Speaker | TTS | i know how to hello | 0.101 | 1 |  | 4175 | Microphone | STT | None | 13.58 | 0 | 13 | Screen-Motion | DO_MOTION | left_u | 62.039 | 0
94 | Screen-Motion | DO_MOTION | left_d | 62.496 | 0 |  |  |  |  | 2031 | Speaker | TTS | i know how to fly | 621.678 | 1 |  | 4176 | Microphone | STT | None | 14.845 | 0 | 14 | Screen-Motion | DO_MOTION | left_d | 62.134 | 0
95 | Screen-Motion | DO_MOTION | left_d | 69.126 | 0 |  |  |  |  | 2032 | Speaker | TTS | good bye milars | 453.751 | 1 |  | 4177 | Microphone | STT | None | 16.338 | 0 | 15 | Screen-Motion | DO_MOTION | left_d | 62.071 | 0
96 | Screen-Motion | DO_MOTION | left_d | 62.096 | 0 |  |  |  |  | 2033 | Speaker | TTS | good bye milars | 441.392 | 1 |  | 4178 | Microphone | STT | None | 17.864 | 0 | 16 | Screen-Motion | DO_MOTION | left_d | 62.048 | 0
97 | Screen-Motion | DO_MOTION | left_d | 64.336 | 0 |  |  |  |  | 2034 | Speaker | TTS | good bye milars | 491.63 | 1 |  | 4179 | Microphone | STT | None | 16.937 | 0 | 17 | Screen-Motion | DO_MOTION | left_d | 62.049 | 0
98 | Screen-Motion | DO_MOTION | left_d | 66.88 | 0 |  |  |  |  | 2035 | Speaker | TTS | sorry i didn't understand that | 921.056 | 1 |  | 4180 | Microphone | STT | None | 10.649 | 0 | 18 | Screen-Motion | DO_MOTION | left_d | 62.046 | 0
99 | Screen-Motion | DO_MOTION | left_d | 65.588 | 0 |  |  |  |  | 2036 | Speaker | TTS | sorry i didn't understand that | 995.745 | 1 |  | 4181 | Microphone | STT | None | 8.515 | 0 | 19 | Screen-Motion | DO_MOTION | left_d | 62.062 | 0
100 | Screen-Motion | DO_MOTION | right_r | 65.821 | 0 |  |  |  |  | 2037 | Speaker | TTS | sorry i didn't understand that | 1225.792 | 1 |  | 4182 | Microphone | STT | None | 13.571 | 0 | 20 | Screen-Motion | DO_MOTION | left_d | 62.046 | 0
101 | Screen-Motion | DO_MOTION | right_r | 68.92 | 0 |  |  |  |  | 2038 | Speaker | TTS | sorry i didn't understand that | 1455.822 | 1 |  | 4183 | Microphone | STT | None | 16.79 | 0 | 21 | Screen-Motion | DO_MOTION | left_l | 62.092 | 0
102 | Screen-Motion | DO_MOTION | right_r | 68.6 | 0 |  |  |  |  | 2039 | Speaker | TTS | sorry i didn't understand that | 1685.839 | 1 |  | 4184 | Microphone | STT | None | 18.793 | 0 | 22 | Screen-Motion | DO_MOTION | left_l | 62.059 | 0
103 | Screen-Motion | DO_MOTION | right_r | 62.112 | 0 |  |  |  |  | 2040 | Speaker | TTS | sorry i didn't understand that | 1915.878 | 1 |  | 4185 | Microphone | STT | None | 8.645 | 0 | 23 | Screen-Motion | DO_MOTION | left_l | 62.052 | 0
104 | Screen-Motion | DO_MOTION | right_r | 64.172 | 0 |  |  |  |  | 2000 | Speaker | TTS | hello | 277.66 | 1 |  | 4186 | Microphone | STT | None | 9.244 | 0 | 24 | Screen-Motion | DO_MOTION | left_l | 62.062 | 0
105 | Screen-Motion | DO_MOTION | right_r | 69.752 | 0 |  |  |  |  | 2001 | Speaker | TTS | hello | 258.137 | 1 |  | 4187 | Microphone | STT | None | 16.238 | 0 | 25 | Screen-Motion | DO_MOTION | left_l | 62.076 | 0
106 | Screen-Motion | DO_MOTION | right_r | 65.273 | 0 |  |  |  |  | 2002 | Speaker | TTS | hello | 229.531 | 1 |  | 4188 | Microphone | STT | None | 16.907 | 0 | 26 | Screen-Motion | DO_MOTION | left_l | 62.065 | 0
107 | Screen-Motion | DO_MOTION | right_l | 65.248 | 0 |  |  |  |  | 2003 | Speaker | TTS | what is your name | 557.069 | 1 |  | 4189 | Microphone | STT | None | 17.051 | 0 | 27 | Screen-Motion | DO_MOTION | left_u | 62.058 | 0
108 | Screen-Motion | DO_MOTION | right_l | 70.679 | 0 |  |  |  |  | 2004 | Speaker | TTS | hello i am your robots | 0.087 | 1 |  | 4190 | Microphone | STT | None | 13.86 | 0 | 28 | Screen-Motion | DO_MOTION | left_u | 62.144 | 0
109 | Screen-Motion | DO_MOTION | right_l | 62.098 | 0 |  |  |  |  | 2005 | Speaker | TTS | hello i am your robots | 0.085 | 1 |  | 4191 | Microphone | STT | None | 16.307 | 0 | 29 | Screen-Motion | DO_MOTION | left_u | 62.703 | 0
110 | Screen-Motion | DO_MOTION | right_l | 73.758 | 0 |  |  |  |  | 2006 | Speaker | TTS | hello i am your robots | 0.115 | 1 |  | 4192 | Microphone | STT | None | 6.689 | 0 | 30 | Screen-Motion | DO_MOTION | left_u | 62.059 | 0
111 | Screen-Motion | DO_MOTION | right_l | 66.031 | 0 |  |  |  |  | 2007 | Speaker | TTS | today is sunday | 706.807 | 1 |  | 4193 | Microphone | STT | None | 14.233 | 0 | 31 | Screen-Motion | DO_MOTION | left_u | 62.076 | 0
112 | Screen-Motion | DO_MOTION | right_l | 65.117 | 0 |  |  |  |  | 2008 | Speaker | TTS | do motion hello | 445.406 | 1 |  | 4194 | Microphone | STT | None | 17.052 | 0 | 32 | Screen-Motion | DO_MOTION | left_u | 62.076 | 0
113 | Screen-Motion | DO_MOTION | right_l | 65.466 | 0 |  |  |  |  | 2009 | Speaker | TTS | hello good morning milars | 0.082 | 1 |  | 4195 | Microphone | STT | None | 9.685 | 0 | 33 | Screen-Motion | DO_MOTION | left_r | 62.055 | 0
114 | Screen-Motion | DO_MOTION | right_l | 64.128 | 0 |  |  |  |  | 2010 | Speaker | TTS | hello good morning milars | 0.099 | 1 |  | 4196 | Microphone | STT | None | 15.556 | 0 | 34 | Screen-Motion | DO_MOTION | left_r | 62.147 | 0
115 | Screen-Motion | DO_MOTION | right_l | 62.08 | 0 |  |  |  |  | 2011 | Speaker | TTS | hello good morning milars | 0.115 | 1 |  | 4197 | Microphone | STT | None | 18.367 | 0 | 35 | Screen-Motion | DO_MOTION | left_r | 63.422 | 0
116 | Screen-Motion | DO_MOTION | right_l | 64.567 | 0 |  |  |  |  | 2012 | Speaker | TTS | hello good morning milars | 0.11 | 1 |  | 4198 | Microphone | STT | None | 13.228 | 0 | 36 | Screen-Motion | DO_MOTION | left_r | 62.064 | 0
117 | Screen-Motion | DO_MOTION | right_l | 65.957 | 0 |  |  |  |  | 2013 | Speaker | TTS | hello good morning milars | 0.107 | 1 |  | 4199 | Microphone | STT | None | 10.082 | 0 | 37 | Screen-Motion | DO_MOTION | left_r | 62.03 | 0
118 | Screen-Motion | DO_MOTION | right_u | 62.115 | 0 |  |  |  |  | 2014 | Speaker | TTS | hello good morning milars | 0.112 | 1 |  | 4200 | Microphone | STT | None | 0.952 | 0 | 38 | Screen-Motion | DO_MOTION | left_r | 62.081 | 0
119 | Screen-Motion | DO_MOTION | left_u | 62.176 | 0 |  |  |  |  | 2015 | Speaker | TTS | please update background first | 0.117 | 1 |  | 4201 | Microphone | STT | None | 10.346 | 0 | 39 | Screen-Motion | DO_MOTION | left_r | 62.07 | 0
120 | Screen-Motion | DO_MOTION | left_u | 66.324 | 0 |  |  |  |  | 2016 | Speaker | TTS | please update background first | 0.125 | 1 |  | 4202 | Microphone | STT | None | 2.745 | 0 | 40 | Screen-Motion | DO_MOTION | left_r | 62.078 | 0
121 | Screen-Motion | DO_MOTION | left_u | 62.163 | 0 |  |  |  |  | 2017 | Speaker | TTS | please update background first | 0.106 | 1 |  | 4203 | Microphone | STT | None | 4.077 | 0 | 41 | Screen-Motion | DO_MOTION | left_u | 62.055 | 0
122 | Screen-Motion | DO_MOTION | left_u | 65.363 | 0 |  |  |  |  | 2018 | Speaker | TTS | background update successfully | 70.59 | 1 |  | 4204 | Microphone | STT | None | 2.402 | 0 | 42 | Screen-Motion | DO_MOTION | left_u | 62.067 | 0
123 | Screen-Motion | DO_MOTION | left_u | 65.059 | 0 |  |  |  |  | 2019 | Speaker | TTS | background update successfully | 21.609 | 1 |  | 4205 | Microphone | STT | None | 4.593 | 0 | 43 | Screen-Motion | DO_MOTION | left_u | 62.123 | 0
124 | Screen-Motion | DO_MOTION | left_u | 68.164 | 0 |  |  |  |  | 2020 | Speaker | TTS | background update successfully | 66.632 | 1 |  | 4206 | Microphone | STT | None | 10.971 | 0 | 44 | Screen-Motion | DO_MOTION | left_l | 62.047 | 0
125 | Screen-Motion | DO_MOTION | left_u | 69.324 | 0 |  |  |  |  | 2021 | Speaker | TTS | learn object can successfully | 0.114 | 1 |  | 4207 | Microphone | STT | None | 4.662 | 0 | 45 | Screen-Motion | DO_MOTION | left_l | 62.096 | 0
126 | Screen-Motion | DO_MOTION | left_u | 64.254 | 0 |  |  |  |  | 2022 | Speaker | TTS | learn object can successfully | 0.107 | 1 |  | 4208 | Microphone | STT | None | 5.215 | 0 | 46 | Screen-Motion | DO_MOTION | left_l | 62.062 | 0
127 | Screen-Motion | DO_MOTION | left_u | 64.34 | 0 |  |  |  |  | 2023 | Speaker | TTS | learn object can successfully | 0.105 | 1 |  | 4209 | Microphone | STT | None | 5.696 | 0 | 47 | Screen-Motion | DO_MOTION | left_l | 62.125 | 0
128 | Screen-Motion | DO_MOTION | left_u | 64.61 | 0 |  |  |  |  | 2024 | Speaker | TTS | learn object can successfully | 0.113 | 1 |  | 4210 | Microphone | STT | None | 5.054 | 0 | 48 | Screen-Motion | DO_MOTION | left_r | 62.074 | 0
129 | Screen-Motion | DO_MOTION | left_u | 62.143 | 0 |  |  |  |  | 2025 | Speaker | TTS | learn object can successfully | 0.113 | 1 |  | 4211 | Microphone | STT | None | 10.972 | 0 | 49 | Screen-Motion | DO_MOTION | left_r | 62.046 | 0
130 | Screen-Motion | DO_MOTION | left_u | 65.53 | 0 |  |  |  |  | 2026 | Speaker | TTS | learn object can successfully | 0.115 | 1 |  | 4212 | Microphone | STT | None | 9.742 | 0 | 50 | Screen-Motion | DO_MOTION | left_r | 62.039 | 0
131 | Screen-Motion | DO_MOTION | left_u | 70.211 | 0 |  |  |  |  | 2027 | Speaker | TTS | i know how to dance | 0.116 | 1 |  | 4213 | Microphone | STT | None | 4.198 | 0 | 51 | Screen-Motion | DO_MOTION | left_r | 62.061 | 0
132 | Screen-Motion | DO_MOTION | left_u | 62.163 | 0 |  |  |  |  | 2028 | Speaker | TTS | i know how to dance | 0.122 | 1 |  | 4214 | Microphone | STT | None | 5.083 | 0 | 52 | Screen-Motion | DO_MOTION | left_r | 62.071 | 0
133 | Screen-Motion | DO_MOTION | right_r | 64.187 | 0 |  |  |  |  | 2029 | Speaker | TTS | i know how to hello | 0.107 | 1 |  | 4215 | Microphone | STT | None | 11.858 | 0 | 53 | Screen-Motion | DO_MOTION | left_r | 62.077 | 0
134 | Screen-Motion | DO_MOTION | right_r | 65.763 | 0 |  |  |  |  | 2030 | Speaker | TTS | i know how to hello | 0.103 | 1 |  | 4216 | Microphone | STT | None | 5.89 | 0 | 54 | Screen-Motion | DO_MOTION | left_u | 62.089 | 0
135 | Screen-Motion | DO_MOTION | right_r | 64.408 | 0 |  |  |  |  | 2031 | Speaker | TTS | i know how to fly | 0.115 | 1 |  | 4217 | Microphone | STT | None | 8.44 | 0 | 55 | Screen-Motion | DO_MOTION | left_u | 62.032 | 0
136 | Screen-Motion | DO_MOTION | right_r | 72.377 | 0 |  |  |  |  | 2032 | Speaker | TTS | good bye milars | 533.67 | 1 |  | 4218 | Microphone | STT | None | 10.321 | 0 | 56 | Screen-Motion | DO_MOTION | left_u | 62.078 | 0
137 | Screen-Motion | DO_MOTION | right_r | 62.21 | 0 |  |  |  |  | 2033 | Speaker | TTS | good bye milars | 463.656 | 1 |  | 4219 | Microphone | STT | None | 7.665 | 0 | 57 | Screen-Motion | DO_MOTION | left_u | 62.074 | 0
138 | Screen-Motion | DO_MOTION | right_r | 72.846 | 0 |  |  |  |  | 2034 | Speaker | TTS | good bye milars | 455.58 | 1 |  | 4220 | Microphone | STT | None | 5.702 | 0 | 58 | Screen-Motion | DO_MOTION | left_l | 63.372 | 0
139 | Screen-Motion | DO_MOTION | right_r | 63.841 | 0 |  |  |  |  | 2035 | Speaker | TTS | sorry i didn't understand that | 0.141 | 1 |  | 4221 | Microphone | STT | None | 8.5 | 0 | 59 | Screen-Motion | DO_MOTION | left_l | 62.053 | 0
140 | Screen-Motion | DO_MOTION | right_r | 65.098 | 0 |  |  |  |  | 2036 | Speaker | TTS | sorry i didn't understand that | 0.116 | 1 |  | 4222 | Microphone | STT | None | 6.262 | 0 | 60 | Screen-Motion | DO_MOTION | left_l | 62.041 | 0
141 | Screen-Motion | DO_MOTION | right_r | 63.18 | 0 |  |  |  |  | 2037 | Speaker | TTS | sorry i didn't understand that | 0.105 | 1 |  | 4223 | Microphone | STT | None | 9.786 | 0 | 61 | Screen-Motion | DO_MOTION | left_u | 62.153 | 0
142 | Screen-Motion | DO_MOTION | right_r | 65.427 | 0 |  |  |  |  | 2038 | Speaker | TTS | sorry i didn't understand that | 0.101 | 1 |  | 4224 | Microphone | STT | None | 6.58 | 0 | 62 | Screen-Motion | DO_MOTION | left_u | 63.406 | 0
143 | Screen-Motion | DO_MOTION | right_l | 67.828 | 0 |  |  |  |  | 2039 | Speaker | TTS | sorry i didn't understand that | 0.095 | 1 |  | 4225 | Microphone | STT | None | 6.147 | 0 | 63 | Screen-Motion | DO_MOTION | left_u | 62.098 | 0
144 | Screen-Motion | DO_MOTION | right_l | 62.124 | 0 |  |  |  |  | 2040 | Speaker | TTS | sorry i didn't understand that | 0.112 | 1 |  | 4226 | Microphone | STT | None | 6.756 | 0 | 64 | Screen-Motion | DO_MOTION | left_d | 62.053 | 0
145 | Screen-Motion | DO_MOTION | right_l | 62.115 | 0 |  |  |  |  | 2000 | Speaker | TTS | hello | 303.418 | 1 |  | 4227 | Microphone | STT | None | 5.405 | 0 | 65 | Screen-Motion | DO_MOTION | left_d | 62.231 | 0
146 | Screen-Motion | DO_MOTION | right_l | 65.163 | 0 |  |  |  |  | 2001 | Speaker | TTS | hello | 256.455 | 1 |  | 4228 | Microphone | STT | None | 20.415 | 0 | 66 | Screen-Motion | DO_MOTION | left_d | 62.096 | 0
147 | Screen-Motion | DO_MOTION | right_l | 64.829 | 0 |  |  |  |  | 2002 | Speaker | TTS | hello | 267.159 | 1 |  | 4229 | Microphone | STT | None | 9.554 | 0 | 67 | Screen-Motion | DO_MOTION | left_r | 62.052 | 0
148 | Screen-Motion | DO_MOTION | right_l | 64.346 | 0 |  |  |  |  | 2003 | Speaker | TTS | what is your name | 492.294 | 1 |  | 4230 | Microphone | STT | None | 10.891 | 0 | 68 | Screen-Motion | DO_MOTION | left_r | 62.054 | 0
149 | Screen-Motion | DO_MOTION | right_l | 62.126 | 0 |  |  |  |  | 2004 | Speaker | TTS | hello i am your robots | 0.109 | 1 |  | 4231 | Microphone | STT | None | 18.946 | 0 | 69 | Screen-Motion | DO_MOTION | left_r | 62.067 | 0
150 | Screen-Motion | DO_MOTION | right_l | 64.439 | 0 |  |  |  |  | 2005 | Speaker | TTS | hello i am your robots | 0.099 | 1 |  | 4232 | Microphone | STT | None | 8.305 | 0 | 70 | Screen-Motion | DO_MOTION | left_l | 62.071 | 0
151 | Screen-Motion | DO_MOTION | right_l | 62.175 | 0 |  |  |  |  | 2006 | Speaker | TTS | hello i am your robots | 0.117 | 1 |  | 4233 | Microphone | STT | None | 8.871 | 0 | 71 | Screen-Motion | DO_MOTION | left_l | 62.047 | 0
152 | Screen-Motion | DO_MOTION | right_l | 62.108 | 0 |  |  |  |  | 2007 | Speaker | TTS | today is sunday | 731.372 | 1 |  | 4234 | Microphone | STT | None | 13.208 | 0 | 72 | Screen-Motion | DO_MOTION | left_l | 62.093 | 0
153 | Screen-Motion | DO_MOTION | right_l | 64.413 | 0 |  |  |  |  | 2008 | Speaker | TTS | do motion hello | 544.753 | 1 |  | 4235 | Microphone | STT | None | 19.998 | 0 | 73 | Screen-Motion | DO_MOTION | left_u | 62.159 | 0
154 | Screen-Motion | DO_MOTION | right_l | 66.462 | 0 |  |  |  |  | 2009 | Speaker | TTS | hello good morning milars | 0.086 | 1 |  | 4236 | Microphone | STT | None | 10.888 | 0 | 74 | Screen-Motion | DO_MOTION | left_u | 62.076 | 0
155 | Screen-Motion | DO_MOTION | right_r | 64.471 | 0 |  |  |  |  | 2010 | Speaker | TTS | hello good morning milars | 0.109 | 1 |  | 4237 | Microphone | STT | None | 12.572 | 0 | 75 | Screen-Motion | DO_MOTION | left_u | 62.054 | 0
156 | Screen-Motion | DO_MOTION | right_r | 67.151 | 0 |  |  |  |  | 2011 | Speaker | TTS | hello good morning milars | 0.106 | 1 |  | 4238 | Microphone | STT | None | 12.956 | 0 | 76 | Screen-Motion | DO_MOTION | left_l | 62.066 | 0
157 | Screen-Motion | DO_MOTION | right_r | 65.385 | 0 |  |  |  |  | 2012 | Speaker | TTS | hello good morning milars | 0.107 | 1 |  | 4239 | Microphone | STT | None | 7.024 | 0 | 77 | Screen-Motion | DO_MOTION | left_l | 62.052 | 0
158 | Screen-Motion | DO_MOTION | right_r | 62.114 | 0 |  |  |  |  | 2013 | Speaker | TTS | hello good morning milars | 0.109 | 1 |  | 4240 | Microphone | STT | None | 5.582 | 0 | 78 | Screen-Motion | DO_MOTION | left_l | 62.086 | 0
159 | Screen-Motion | DO_MOTION | right_r | 62.094 | 0 |  |  |  |  | 2014 | Speaker | TTS | hello good morning milars | 0.097 | 1 |  | 4241 | Microphone | STT | None | 6.938 | 0 | 79 | Screen-Motion | DO_MOTION | left_d | 62.156 | 0
160 | Screen-Motion | DO_MOTION | right_l | 64.322 | 0 |  |  |  |  | 2015 | Speaker | TTS | please update background first | 0.107 | 1 |  | 4242 | Microphone | STT | None | 14.767 | 0 | 80 | Screen-Motion | DO_MOTION | left_d | 62.071 | 0
161 | Screen-Motion | DO_MOTION | right_l | 63.896 | 0 |  |  |  |  | 2016 | Speaker | TTS | please update background first | 0.099 | 1 |  | 4243 | Microphone | STT | None | 9.284 | 0 | 81 | Screen-Motion | DO_MOTION | left_d | 62.181 | 0
162 | Screen-Motion | DO_MOTION | right_l | 62.351 | 0 |  |  |  |  | 2017 | Speaker | TTS | please update background first | 0.107 | 1 |  | 4244 | Microphone | STT | None | 11.942 | 0 | 82 | Screen-Motion | DO_MOTION | left_r | 62.166 | 0
163 | Screen-Motion | DO_MOTION | right_l | 68.941 | 0 |  |  |  |  | 2018 | Speaker | TTS | background update successfully | 24.234 | 1 |  | 4245 | Microphone | STT | None | 14.122 | 0 | 83 | Screen-Motion | DO_MOTION | left_r | 63.15 | 0
164 | Screen-Motion | DO_MOTION | right_r | 62.202 | 0 |  |  |  |  | 2019 | Speaker | TTS | background update successfully | 0.108 | 1 |  | 4246 | Microphone | STT | None | 7.502 | 0 | 84 | Screen-Motion | DO_MOTION | left_r | 62.13 | 0
165 | Screen-Motion | DO_MOTION | right_r | 62.112 | 0 |  |  |  |  | 2020 | Speaker | TTS | background update successfully | 0.112 | 1 |  | 4247 | Microphone | STT | None | 9.626 | 0 | 85 | Screen-Motion | DO_MOTION | left_l | 62.216 | 0
166 | Screen-Motion | DO_MOTION | right_r | 65.665 | 0 |  |  |  |  | 2021 | Speaker | TTS | learn object can successfully | 0.111 | 1 |  | 4248 | Microphone | STT | None | 10.95 | 0 | 86 | Screen-Motion | DO_MOTION | left_l | 62.132 | 0
167 | Screen-Motion | DO_MOTION | right_r | 62.604 | 0 |  |  |  |  | 2022 | Speaker | TTS | learn object can successfully | 0.118 | 1 |  | 4249 | Microphone | STT | None | 8.675 | 0 | 87 | Screen-Motion | DO_MOTION | left_l | 62.107 | 0
168 | Screen-Motion | DO_MOTION | right_r | 64.231 | 0 |  |  |  |  | 2023 | Speaker | TTS | learn object can successfully | 0.123 | 1 |  | 4250 | Microphone | STT | None | 11.03 | 0 | 88 | Screen-Motion | DO_MOTION | left_l | 62.158 | 0
169 | Screen-Motion | DO_MOTION | right_r | 62.209 | 0 |  |  |  |  | 2024 | Speaker | TTS | learn object can successfully | 0.124 | 1 |  | 4251 | Microphone | STT | None | 6.181 | 0 | 89 | Screen-Motion | DO_MOTION | left_l | 63.18 | 0
170 | Screen-Motion | DO_MOTION | right_r | 62.124 | 0 |  |  |  |  | 2025 | Speaker | TTS | learn object can successfully | 0.143 | 1 |  | 4252 | Microphone | STT | None | 11.757 | 0 | 90 | Screen-Motion | DO_MOTION | left_u | 65.138 | 0
171 | Screen-Motion | DO_MOTION | right_l | 64.129 | 0 |  |  |  |  | 2026 | Speaker | TTS | learn object can successfully | 0.152 | 1 |  | 4253 | Microphone | STT | None | 13.599 | 0 | 91 | Screen-Motion | DO_MOTION | left_u | 62.036 | 0
172 | Screen-Motion | DO_MOTION | right_l | 62.137 | 0 |  |  |  |  | 2027 | Speaker | TTS | i know how to dance | 0.096 | 1 |  | 4254 | Microphone | STT | None | 13.759 | 0 | 92 | Screen-Motion | DO_MOTION | left_u | 62.089 | 0
173 | Screen-Motion | DO_MOTION | right_l | 62.638 | 0 |  |  |  |  | 2028 | Speaker | TTS | i know how to dance | 0.181 | 1 |  | 4255 | Microphone | STT | None | 11.393 | 0 | 93 | Screen-Motion | DO_MOTION | left_u | 62.075 | 0
174 | Screen-Motion | DO_MOTION | right_l | 66.735 | 0 |  |  |  |  | 2029 | Speaker | TTS | i know how to hello | 0.166 | 1 |  | 4256 | Microphone | STT | None | 7.34 | 0 | 94 | Screen-Motion | DO_MOTION | left_u | 62.328 | 0
175 | Screen-Motion | DO_MOTION | right_l | 62.146 | 0 |  |  |  |  | 2030 | Speaker | TTS | i know how to hello | 0.105 | 1 |  | 4257 | Microphone | STT | None | 16.485 | 0 | 95 | Screen-Motion | DO_MOTION | left_r | 62.102 | 0
176 | Screen-Motion | DO_MOTION | right_l | 62.101 | 0 |  |  |  |  | 2031 | Speaker | TTS | i know how to fly | 0.104 | 1 |  | 4258 | Microphone | STT | None | 7.517 | 0 | 96 | Screen-Motion | DO_MOTION | left_r | 62.067 | 0
0 | Screen-Motion | DO_MOTION | right_r | 64.589 | 0 |  |  |  |  | 2032 | Speaker | TTS | good bye milars | 504.016 | 1 |  | 4259 | Microphone | STT | None | 12.7 | 0 | 97 | Screen-Motion | DO_MOTION | left_r | 62.368 | 0
1 | Screen-Motion | DO_MOTION | right_r | 64.17 | 0 |  |  |  |  | 2033 | Speaker | TTS | good bye milars | 445.223 | 1 |  | 4260 | Microphone | STT | None | 6.903 | 0 | 98 | Screen-Motion | DO_MOTION | left_r | 62.076 | 0
2 | Screen-Motion | DO_MOTION | right_r | 64.681 | 0 |  |  |  |  | 2034 | Speaker | TTS | good bye milars | 463.953 | 1 |  | 4261 | Microphone | STT | None | 8.227 | 0 | 99 | Screen-Motion | DO_MOTION | left_r | 62.04 | 0
3 | Screen-Motion | DO_MOTION | right_r | 62.138 | 0 |  |  |  |  | 2035 | Speaker | TTS | sorry i didn't understand that | 0.149 | 1 |  | 4262 | Microphone | STT | None | 8.421 | 0 | 100 | Screen-Motion | DO_MOTION | left_r | 62.072 | 0
4 | Screen-Motion | DO_MOTION | right_l | 62.313 | 0 |  |  |  |  | 2036 | Speaker | TTS | sorry i didn't understand that | 168.092 | 1 |  | 4263 | Microphone | STT | None | 7.552 | 0 | 101 | Screen-Motion | DO_MOTION | left_d | 62.222 | 0
5 | Screen-Motion | DO_MOTION | right_l | 62.108 | 0 |  |  |  |  | 2037 | Speaker | TTS | sorry i didn't understand that | 491.164 | 1 |  | 4264 | Microphone | STT | None | 7.053 | 0 | 102 | Screen-Motion | DO_MOTION | left_d | 62.085 | 0
6 | Screen-Motion | DO_MOTION | right_l | 66.968 | 0 |  |  |  |  | 2038 | Speaker | TTS | sorry i didn't understand that | 767.176 | 1 |  | 4265 | Microphone | STT | None | 14.247 | 0 | 103 | Screen-Motion | DO_MOTION | left_d | 62.065 | 0
7 | Screen-Motion | DO_MOTION | right_l | 62.096 | 0 |  |  |  |  | 2039 | Speaker | TTS | sorry i didn't understand that | 1043.214 | 1 |  | 4266 | Microphone | STT | None | 14.522 | 0 | 104 | Screen-Motion | DO_MOTION | left_d | 62.145 | 0
8 | Screen-Motion | DO_MOTION | right_l | 62.224 | 0 |  |  |  |  | 2040 | Speaker | TTS | sorry i didn't understand that | 1366.251 | 1 |  | 4267 | Microphone | STT | None | 8.687 | 0 | 105 | Screen-Motion | DO_MOTION | left_d | 62.089 | 0
9 | Screen-Motion | DO_MOTION | right_l | 62.142 | 0 |  |  |  |  | 2000 | Speaker | TTS | hello | 268.617 | 1 |  | 4268 | Microphone | STT | None | 10.341 | 0 | 106 | Screen-Motion | DO_MOTION | left_d | 62.374 | 0
10 | Screen-Motion | DO_MOTION | right_l | 66.214 | 0 |  |  |  |  | 2001 | Speaker | TTS | hello | 215.26 | 1 |  | 4269 | Microphone | STT | None | 7.915 | 0 | 107 | Screen-Motion | DO_MOTION | left_l | 62.067 | 0
11 | Screen-Motion | DO_MOTION | right_l | 63.731 | 0 |  |  |  |  | 2002 | Speaker | TTS | hello | 236.059 | 1 |  | 4270 | Microphone | STT | None | 6.62 | 0 | 108 | Screen-Motion | DO_MOTION | left_l | 63.264 | 0
0 | Screen-Motion | DO_MOTION | left_l | 65.093 | 0 |  |  |  |  | 2003 | Speaker | TTS | what is your name | 509.569 | 1 |  | 4271 | Microphone | STT | None | 17.151 | 0 | 109 | Screen-Motion | DO_MOTION | left_l | 62.13 | 0
1 | Screen-Motion | DO_MOTION | left_l | 64.308 | 0 |  |  |  |  | 2004 | Speaker | TTS | hello i am your robots | 738.011 | 1 |  | 4272 | Microphone | STT | None | 7.948 | 0 | 110 | Screen-Motion | DO_MOTION | left_l | 63.501 | 0
2 | Screen-Motion | DO_MOTION | left_l | 62.177 | 0 |  |  |  |  | 2000 | Speaker | TTS | hello | 307.969 | 1 |  | 4273 | Microphone | STT | None | 11.975 | 0 | 111 | Screen-Motion | DO_MOTION | left_l | 62.088 | 0
3 | Screen-Motion | DO_MOTION | left_l | 62.158 | 0 |  |  |  |  | 2001 | Speaker | TTS | hello | 258.967 | 1 |  | 4274 | Microphone | STT | None | 9.618 | 0 | 112 | Screen-Motion | DO_MOTION | right_l | 62.119 | 0
4 | Screen-Motion | DO_MOTION | left_d | 68.643 | 0 |  |  |  |  | 2002 | Speaker | TTS | hello | 236.794 | 1 |  | 4275 | Microphone | STT | None | 11.122 | 0 | 113 | Screen-Motion | DO_MOTION | right_l | 62.128 | 0
5 | Screen-Motion | DO_MOTION | left_d | 64.13 | 0 |  |  |  |  | 2003 | Speaker | TTS | what is your name | 615.061 | 1 |  | 4276 | Microphone | STT | None | 7.009 | 0 | 114 | Screen-Motion | DO_MOTION | right_r | 62.295 | 0
6 | Screen-Motion | DO_MOTION | left_u | 62.105 | 0 |  |  |  |  | 2004 | Speaker | TTS | hello i am your robots | 722.379 | 1 |  | 4277 | Microphone | STT | None | 8.276 | 0 | 115 | Screen-Motion | DO_MOTION | right_r | 62.015 | 0
7 | Screen-Motion | DO_MOTION | left_u | 62.113 | 0 |  |  |  |  | 2005 | Speaker | TTS | hello i am your robots | 743.546 | 1 |  | 4278 | Microphone | STT | None | 7.712 | 0 | 116 | Screen-Motion | DO_MOTION | right_r | 62.058 | 0
8 | Screen-Motion | DO_MOTION | left_u | 63.082 | 0 |  |  |  |  | 2006 | Speaker | TTS | hello i am your robots | 771.774 | 1 |  | 4279 | Microphone | STT | None | 14.054 | 0 | 117 | Screen-Motion | DO_MOTION | right_r | 62.189 | 0
9 | Screen-Motion | DO_MOTION | right_d | 67.346 | 0 |  |  |  |  | 2007 | Speaker | TTS | today is sunday | 577.626 | 1 |  | 4280 | Microphone | STT | None | 13.274 | 0 | 118 | Screen-Motion | DO_MOTION | right_r | 62.159 | 0
10 | Screen-Motion | DO_MOTION | right_d | 64.456 | 0 |  |  |  |  | 2008 | Speaker | TTS | do motion hello | 440.035 | 1 |  | 4281 | Microphone | STT | None | 12.81 | 0 | 119 | Screen-Motion | DO_MOTION | right_r | 62.136 | 0
11 | Screen-Motion | DO_MOTION | right_d | 62.212 | 0 |  |  |  |  | 2009 | Speaker | TTS | hello good morning milars | 627.288 | 1 |  | 4282 | Microphone | STT | None | 9.901 | 0 | 120 | Screen-Motion | DO_MOTION | right_u | 62.183 | 0
12 | Screen-Motion | DO_MOTION | right_d | 64.135 | 0 |  |  |  |  | 2010 | Speaker | TTS | hello good morning milars | 603.019 | 1 |  | 4283 | Microphone | STT | None | 7.769 | 0 | 121 | Screen-Motion | DO_MOTION | right_u | 62.236 | 0
13 | Screen-Motion | DO_MOTION | right_d | 62.848 | 0 |  |  |  |  | 2011 | Speaker | TTS | hello good morning milars | 652.485 | 1 |  | 4284 | Microphone | STT | None | 11.302 | 0 | 122 | Screen-Motion | DO_MOTION | right_u | 62.173 | 0
14 | Screen-Motion | DO_MOTION | left_u | 63.777 | 0 |  |  |  |  | 2012 | Speaker | TTS | hello good morning milars | 653.43 | 1 |  | 4285 | Microphone | STT | None | 16.443 | 0 | 123 | Screen-Motion | DO_MOTION | right_d | 62.071 | 0
15 | Screen-Motion | DO_MOTION | left_u | 63.769 | 0 |  |  |  |  | 2013 | Speaker | TTS | hello good morning milars | 666.041 | 1 |  | 4286 | Microphone | STT | None | 13.374 | 0 | 124 | Screen-Motion | DO_MOTION | right_d | 62.086 | 0
16 | Screen-Motion | DO_MOTION | left_u | 63.879 | 0 |  |  |  |  | 2014 | Speaker | TTS | hello good morning milars | 619.577 | 1 |  | 4287 | Microphone | STT | None | 14.553 | 0 | 125 | Screen-Motion | DO_MOTION | right_d | 62.125 | 0
17 | Screen-Motion | DO_MOTION | left_u | 64.643 | 0 |  |  |  |  | 2015 | Speaker | TTS | please update background first | 90.129 | 1 |  | 4288 | Microphone | STT | None | 12.773 | 0 | 126 | Screen-Motion | DO_MOTION | right_d | 62.113 | 0
18 | Screen-Motion | DO_MOTION | left_l | 65.655 | 0 |  |  |  |  | 2016 | Speaker | TTS | please update background first | 41.16 | 1 |  | 4289 | Microphone | STT | None | 7.897 | 0 | 127 | Screen-Motion | DO_MOTION | right_d | 62.165 | 0
19 | Screen-Motion | DO_MOTION | left_l | 66.004 | 0 |  |  |  |  | 2017 | Speaker | TTS | please update background first | 39.169 | 1 |  | 4290 | Microphone | STT | None | 10.704 | 0 | 128 | Screen-Motion | DO_MOTION | right_d | 62.302 | 0
20 | Screen-Motion | DO_MOTION | left_r | 62.109 | 0 |  |  |  |  | 2018 | Speaker | TTS | background update successfully | 0.083 | 1 |  | 4291 | Microphone | STT | None | 13.045 | 0 | 129 | Screen-Motion | DO_MOTION | right_d | 62.138 | 0
21 | Screen-Motion | DO_MOTION | left_r | 65.663 | 0 |  |  |  |  | 2019 | Speaker | TTS | background update successfully | 0.098 | 1 |  | 4292 | Microphone | STT | None | 12.329 | 0 | 130 | Screen-Motion | DO_MOTION | right_u | 62.058 | 0
22 | Screen-Motion | DO_MOTION | left_r | 64.225 | 0 |  |  |  |  | 2020 | Speaker | TTS | background update successfully | 0.096 | 1 |  | 4293 | Microphone | STT | None | 15.764 | 0 | 131 | Screen-Motion | DO_MOTION | right_u | 62.086 | 0
23 | Screen-Motion | DO_MOTION | left_r | 63.735 | 0 |  |  |  |  | 2021 | Speaker | TTS | learn object can successfully | 30.213 | 1 |  | 4294 | Microphone | STT | None | 7.594 | 0 | 132 | Screen-Motion | DO_MOTION | right_r | 62.44 | 0
24 | Screen-Motion | DO_MOTION | left_r | 63.753 | 0 |  |  |  |  | 2022 | Speaker | TTS | learn object can successfully | 0.094 | 1 |  | 4295 | Microphone | STT | None | 11.814 | 0 | 133 | Screen-Motion | DO_MOTION | right_r | 62.789 | 0
25 | Screen-Motion | DO_MOTION | left_r | 63.919 | 0 |  |  |  |  | 2023 | Speaker | TTS | learn object can successfully | 0.09 | 1 |  | 4296 | Microphone | STT | None | 7.138 | 0 | 134 | Screen-Motion | DO_MOTION | right_r | 62.139 | 0
26 | Screen-Motion | DO_MOTION | left_r | 62.168 | 0 |  |  |  |  | 2024 | Speaker | TTS | learn object can successfully | 0.106 | 1 |  | 4297 | Microphone | STT | None | 6.921 | 0 | 135 | Screen-Motion | DO_MOTION | right_d | 62.165 | 0
27 | Screen-Motion | DO_MOTION | left_r | 62.067 | 0 |  |  |  |  | 2025 | Speaker | TTS | learn object can successfully | 0.083 | 1 |  | 4298 | Microphone | STT | None | 13.211 | 0 | 136 | Screen-Motion | DO_MOTION | right_d | 62.092 | 0
28 | Screen-Motion | DO_MOTION | left_r | 62.141 | 0 |  |  |  |  | 2026 | Speaker | TTS | learn object can successfully | 0.097 | 1 |  | 4299 | Microphone | STT | None | 6.791 | 0 | 137 | Screen-Motion | DO_MOTION | right_d | 62.05 | 0
29 | Screen-Motion | DO_MOTION | left_r | 62.199 | 0 |  |  |  |  | 2027 | Speaker | TTS | i know how to dance | 691.239 | 1 |  | 4300 | Microphone | STT | None | 8.601 | 0 | 138 | Screen-Motion | DO_MOTION | right_d | 62.076 | 0
30 | Screen-Motion | DO_MOTION | left_r | 62.271 | 0 |  |  |  |  | 2028 | Speaker | TTS | i know how to dance | 601.071 | 1 |  | 4301 | Microphone | STT | None | 7.609 | 0 | 139 | Screen-Motion | DO_MOTION | right_d | 62.057 | 0
31 | Screen-Motion | DO_MOTION | left_r | 65.338 | 0 |  |  |  |  | 2029 | Speaker | TTS | i know how to hello | 629.754 | 1 |  | 4302 | Microphone | STT | None | 14.745 | 0 | 140 | Screen-Motion | DO_MOTION | right_u | 64.107 | 0
32 | Screen-Motion | DO_MOTION | left_r | 62.109 | 0 |  |  |  |  | 2030 | Speaker | TTS | i know how to hello | 665.774 | 1 |  | 4303 | Microphone | STT | None | 14.531 | 0 | 141 | Screen-Motion | DO_MOTION | right_u | 62.079 | 0
33 | Screen-Motion | DO_MOTION | left_r | 62.669 | 0 |  |  |  |  | 2031 | Speaker | TTS | i know how to fly | 602.788 | 1 |  | 4304 | Microphone | STT | None | 14.979 | 0 | 142 | Screen-Motion | DO_MOTION | right_u | 62.06 | 0
34 | Screen-Motion | DO_MOTION | left_r | 62.837 | 0 |  |  |  |  | 2032 | Speaker | TTS | good bye milars | 460.641 | 1 |  | 4305 | Microphone | STT | None | 8.234 | 0 | 143 | Screen-Motion | DO_MOTION | left_u | 62.036 | 0
35 | Screen-Motion | DO_MOTION | left_r | 67.695 | 0 |  |  |  |  | 2033 | Speaker | TTS | good bye milars | 482.774 | 1 |  | 4306 | Microphone | STT | None | 12.78 | 0 | 144 | Screen-Motion | DO_MOTION | left_u | 62.082 | 0
36 | Screen-Motion | DO_MOTION | left_r | 67.381 | 0 |  |  |  |  | 2034 | Speaker | TTS | good bye milars | 446.676 | 1 |  | 4307 | Microphone | STT | None | 15.459 | 0 | 145 | Screen-Motion | DO_MOTION | left_u | 62.53 | 0
37 | Screen-Motion | DO_MOTION | left_l | 62.149 | 0 |  |  |  |  | 2035 | Speaker | TTS | sorry i didn't understand that | 0.097 | 1 |  | 4308 | Microphone | STT | None | 6.331 | 0 | 146 | Screen-Motion | DO_MOTION | left_l | 62.079 | 0
38 | Screen-Motion | DO_MOTION | left_l | 63.952 | 0 |  |  |  |  | 2036 | Speaker | TTS | sorry i didn't understand that | 121.309 | 1 |  | 4309 | Microphone | STT | None | 12.995 | 0 | 147 | Screen-Motion | DO_MOTION | left_l | 62.16 | 0
39 | Screen-Motion | DO_MOTION | left_l | 63.974 | 0 |  |  |  |  | 2037 | Speaker | TTS | sorry i didn't understand that | 351.342 | 1 |  | 4310 | Microphone | STT | None | 15.209 | 0 | 148 | Screen-Motion | DO_MOTION | left_l | 62.17 | 0
40 | Screen-Motion | DO_MOTION | left_l | 62.212 | 0 |  |  |  |  | 2038 | Speaker | TTS | sorry i didn't understand that | 581.257 | 1 |  | 4311 | Microphone | STT | None | 8.674 | 0
41 | Screen-Motion | DO_MOTION | left_l | 64.208 | 0 |  |  |  |  | 2039 | Speaker | TTS | sorry i didn't understand that | 811.329 | 1 |  | 4312 | Microphone | STT | None | 7.097 | 0
42 | Screen-Motion | DO_MOTION | left_l | 63.282 | 0 |  |  |  |  | 2040 | Speaker | TTS | sorry i didn't understand that | 1088.325 | 1 |  | 4313 | Microphone | STT | None | 8.369 | 0
43 | Screen-Motion | DO_MOTION | left_l | 63.954 | 0 |  |  |  |  | 2000 | Speaker | TTS | hello | 245.397 | 1 |  | 4314 | Microphone | STT | None | 7.573 | 0
44 | Screen-Motion | DO_MOTION | left_l | 62.244 | 0 |  |  |  |  | 2001 | Speaker | TTS | hello | 256.192 | 1 |  | 4315 | Microphone | STT | None | 11.683 | 0
45 | Screen-Motion | DO_MOTION | left_l | 62.125 | 0 |  |  |  |  | 2002 | Speaker | TTS | hello | 272.84 | 1 |  | 4316 | Microphone | STT | None | 17.258 | 0
46 | Screen-Motion | DO_MOTION | left_l | 62.138 | 0 |  |  |  |  | 2003 | Speaker | TTS | what is your name | 519.74 | 1 |  | 4317 | Microphone | STT | None | 6.425 | 0
47 | Screen-Motion | DO_MOTION | left_l | 66.094 | 0 |  |  |  |  | 2004 | Speaker | TTS | hello i am your robots | 778.794 | 1 |  | 4318 | Microphone | STT | None | 7.722 | 0
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
