milars-z/Real-Time-Embedded-Programming/docs/test_data/20260415_log.csv

TaskID | Module | Type | TargetName | Duration(ms) | issuccess
0 | Screen-Motion | DO_MOTION | left_l | 65.971 | 0
1 | Screen-Motion | DO_MOTION | left_r | 62.136 | 0
2 | Screen-Motion | DO_MOTION | left_r | 65.816 | 0
3 | Screen-Motion | DO_MOTION | left_r | 72.281 | 0
4 | Screen-Motion | DO_MOTION | left_r | 62.38 | 0
5 | Screen-Motion | DO_MOTION | left_r | 67.374 | 0
6 | Screen-Motion | DO_MOTION | left_u | 64.721 | 0
7 | Screen-Motion | DO_MOTION | left_u | 62.033 | 0
8 | Screen-Motion | DO_MOTION | left_d | 62.199 | 0
9 | Screen-Motion | DO_MOTION | left_l | 66.491 | 0
10 | Screen-Motion | DO_MOTION | left_l | 62.067 | 0
11 | Screen-Motion | DO_MOTION | left_r | 69.358 | 0
12 | Screen-Motion | DO_MOTION | left_r | 64.011 | 0
13 | Screen-Motion | DO_MOTION | left_u | 65.305 | 0
14 | Screen-Motion | DO_MOTION | left_u | 65.872 | 0
15 | Screen-Motion | DO_MOTION | left_d | 68.185 | 0
16 | Screen-Motion | DO_MOTION | left_d | 68.562 | 0
17 | Screen-Motion | DO_MOTION | left_l | 64.094 | 0
18 | Screen-Motion | DO_MOTION | left_l | 62.037 | 0
19 | Screen-Motion | DO_MOTION | left_r | 64.896 | 0
20 | Screen-Motion | DO_MOTION | left_r | 64.982 | 0
21 | Screen-Motion | DO_MOTION | left_l | 65.454 | 0
22 | Screen-Motion | DO_MOTION | left_l | 62.173 | 0
23 | Screen-Motion | DO_MOTION | left_r | 62.402 | 0
24 | Screen-Motion | DO_MOTION | left_r | 66.343 | 0
25 | Screen-Motion | DO_MOTION | left_l | 64.036 | 0
26 | Screen-Motion | DO_MOTION | left_l | 62.139 | 0
27 | Screen-Motion | DO_MOTION | left_r | 63.711 | 0
28 | Screen-Motion | DO_MOTION | left_r | 62.273 | 0
29 | Screen-Motion | DO_MOTION | left_l | 62.151 | 0
30 | Screen-Motion | DO_MOTION | left_l | 62.169 | 0
31 | Screen-Motion | DO_MOTION | left_r | 62.257 | 0
32 | Screen-Motion | DO_MOTION | left_r | 65.762 | 0
33 | Screen-Motion | DO_MOTION | left_d | 62.167 | 0
34 | Screen-Motion | DO_MOTION | left_d | 62.126 | 0
35 | Screen-Motion | DO_MOTION | left_u | 62.055 | 0
36 | Screen-Motion | DO_MOTION | left_u | 62.473 | 0
37 | Screen-Motion | DO_MOTION | left_l | 62.052 | 0
38 | Screen-Motion | DO_MOTION | left_l | 65.586 | 0
39 | Screen-Motion | DO_MOTION | left_r | 63.188 | 0
40 | Screen-Motion | DO_MOTION | left_r | 65.269 | 0
41 | Screen-Motion | DO_MOTION | left_l | 63.46 | 0
42 | Screen-Motion | DO_MOTION | left_u | 62.055 | 0
43 | Screen-Motion | DO_MOTION | left_r | 66.292 | 0
44 | Screen-Motion | DO_MOTION | left_l | 62.872 | 0
45 | Screen-Motion | DO_MOTION | left_r | 68.885 | 0
46 | Screen-Motion | DO_MOTION | left_l | 63.718 | 0
47 | Screen-Motion | DO_MOTION | left_r | 67.347 | 0
48 | Screen-Motion | DO_MOTION | left_l | 71.825 | 0
49 | Screen-Motion | DO_MOTION | left_r | 63.104 | 0
50 | Screen-Motion | DO_MOTION | left_l | 62.054 | 0
51 | Screen-Motion | DO_MOTION | left_r | 62.179 | 0
52 | Screen-Motion | DO_MOTION | left_l | 62.245 | 0
53 | Screen-Motion | DO_MOTION | left_r | 70.1 | 0
54 | Screen-Motion | DO_MOTION | left_l | 62.128 | 0
55 | Screen-Motion | DO_MOTION | left_r | 65.374 | 0
56 | Screen-Motion | DO_MOTION | left_l | 62.206 | 0
57 | Screen-Motion | DO_MOTION | left_r | 64.234 | 0
58 | Screen-Motion | DO_MOTION | left_d | 64.342 | 0
59 | Screen-Motion | DO_MOTION | left_d | 66.682 | 0
60 | Screen-Motion | DO_MOTION | left_u | 65.382 | 0
61 | Screen-Motion | DO_MOTION | left_l | 66.926 | 0
62 | Screen-Motion | DO_MOTION | left_r | 62.094 | 0
63 | Screen-Motion | DO_MOTION | left_l | 64.518 | 0
64 | Screen-Motion | DO_MOTION | left_r | 62.051 | 0
65 | Screen-Motion | DO_MOTION | left_l | 62.81 | 0
1000 | Camera | Update | None | 48.62
1000 | Camera | Update | None | 57.91
1000 | Camera | Update | None | 26.853 | 1
1001 | Camera | Learn | ll | 60.99
1001 | Camera | Update | None | 28.382
1001 | Camera | Detecte | uu | 33.148 | 0
1002 | Camera | Detecte | ll | 49.96
1002 | Camera | Update | None | 27.925
1002 | Camera | Detecte | uu | 31.796 | 0
1003 | Camera | Detecte | ll | 39.27
1003 | Camera | Learn | yy | 55.265
1003 | Camera | Update | None | 25.967 | 1
1004 | Camera | Detecte | oo | 48.09
1004 | Camera | Learn | yy | 29.616
1004 | Camera | Detecte | uu | 28.46 | 1
1005 | Camera | Detecte | yy | 26.981
1005 | Camera | Learn | gg | 27.483 | 1
1006 | Camera | Detecte | yy | 30.372
1006 | Camera | Detecte | gg | 32.681 | 1
1007 | Camera | Detecte | yy | 28.96
1008 | Camera | Detecte | yy | 31.732
1009 | Camera | Detecte | yy | 30.895
1010 | Camera | Detecte | yy | 26.257
1011 | Camera | Detecte | yy | 30.252
1012 | Camera | Detecte | yy | 32.04
1013 | Camera | Detecte | yy | 27.314
1014 | Camera | Detecte | yy | 31.079
2000 | Speaker | TTS | stop now | 892.524 | 1
2000 | Speaker | TTS | reset now | 639.332 | 1
2000 | Speaker | TTS | None | 2619.178 | 1
2000 | Speaker | TTS | None | 665.878 | 1
2000 | Speaker | TTS | learn motion test | 1021.958 | 1
2000 | Speaker | TTS | hello good morning milars | 723.809 | 1
2000 | Speaker | TTS | hello good morning milars | 21541.443 | 1
2000 | Speaker | TTS | hello good morning milars | 1276.508 | 1
2000 | Speaker | TTS | hello good morning milars | 772.428 | 1
2000 | Speaker | TTS | hello good morning milars | 742.532 | 1
2000 | Speaker | TTS | hello good morning milars | 732.854 | 1
2000 | Speaker | TTS | hello good morning milars | 642.726 | 1
2000 | Speaker | TTS | hello good morning milars | 705.747 | 1
2000 | Speaker | TTS | hello good morning milars | 1035.744 | 1
2000 | Speaker | TTS | hello good morning milars | 5512.169 | 1
2000 | Speaker | TTS | do motiontest | 841.651 | 1
2001 | Speaker | TTS | reset now | 430.576 | 1
2001 | Speaker | TTS | None | 2512.055 | 1
2001 | Speaker | TTS | None | 1386.977 | 1
2001 | Speaker | TTS | learn motion test | 703.679 | 1
2001 | Speaker | TTS | i know how to test | 684.219 | 1
2001 | Speaker | TTS | hello i am your robot | 798.325 | 1
2001 | Speaker | TTS | hello good morning milars | 13879.363 | 1
2001 | Speaker | TTS | hello good morning milars | 717.674 | 1
2001 | Speaker | TTS | hello good morning milars | 788.704 | 1
2001 | Speaker | TTS | hello good morning milars | 672.772 | 1
2001 | Speaker | TTS | hello good morning milars | 2663.948 | 1
2001 | Speaker | TTS | do motiontest | 637.741 | 1
2001 | Speaker | TTS | background update successfully | 984.508 | 1
2002 | Speaker | TTS | stop now | 544.276 | 1
2002 | Speaker | TTS | reset now | 434.3 | 1
2002 | Speaker | TTS | None | 2102.427 | 1
2002 | Speaker | TTS | None | 642.303 | 1
2002 | Speaker | TTS | hello good morning milars | 774.492 | 1
2002 | Speaker | TTS | hello good morning milars | 4416.709 | 1
2002 | Speaker | TTS | hello good morning milars | 654.988 | 1
2002 | Speaker | TTS | hello good morning milars | 760.328 | 1
2002 | Speaker | TTS | hello good morning milars | 670.076 | 1
2002 | Speaker | TTS | hello good morning milars | 707.737 | 1
2002 | Speaker | TTS | do motiontest | 584.404 | 1
2002 | Speaker | TTS | do motion dance | 638.509 | 1
2002 | Speaker | TTS | can not finduu | 567.535 | 1
2003 | Speaker | TTS | stop now | 410.45 | 1
2003 | Speaker | TTS | stop now | 416.901 | 1
2003 | Speaker | TTS | None | 1970.333 | 1
2003 | Speaker | TTS | None | 1178.84 | 1
2003 | Speaker | TTS | hello you are milars | 542.115 | 1
2003 | Speaker | TTS | hello good morning milars | 1328.661 | 1
2003 | Speaker | TTS | hello good morning milars | 685.107 | 1
2003 | Speaker | TTS | hello good morning milars | 672.532 | 1
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
2033 | Speaker | TTS | hello good morning milars | 653.095 | 1
2034 | Speaker | TTS | hello good morning milars | 702.496 | 1
2034 | Speaker | TTS | hello good morning milars | 694.75 | 1
2035 | Speaker | TTS | hello good morning milars | 681.225 | 1
2035 | Speaker | TTS | hello good morning milars | 740.603 | 1
2036 | Speaker | TTS | hello good morning milars | 657.554 | 1
2036 | Speaker | TTS | hello good morning milars | 637.534 | 1
2037 | Speaker | TTS | hello good morning milars | 686.266 | 1
2037 | Speaker | TTS | hello good morning milars | 736.786 | 1
2038 | Speaker | TTS | hello good morning milars | 755.774 | 1
2038 | Speaker | TTS | hello good morning milars | 700.402 | 1
2039 | Speaker | TTS | hello good morning milars | 701.927 | 1
2039 | Speaker | TTS | hello good morning milars | 828.731 | 1
2040 | Speaker | TTS | sorry i didn't understand that | 1110.198 | 1
2040 | Speaker | TTS | hello good morning milars | 708.564 | 1
2041 | Speaker | TTS | hello good morning milars | 655.47 | 1
2041 | Speaker | TTS | do motion dance | 720.238 | 1
2042 | Speaker | TTS | sorry i didn't understand that | 1198.431 | 1
2042 | Speaker | TTS | hello good morning milars | 677.766 | 1
2043 | Speaker | TTS | hello good morning milars | 656.591 | 1
2043 | Speaker | TTS | do motion hello | 532.075 | 1
2044 | Speaker | TTS | hello good morning milars | 665.665 | 1
2044 | Speaker | TTS | do motion fly | 524.135 | 1
2045 | Speaker | TTS | hello good morning milars | 656.942 | 1
2045 | Speaker | TTS | hello good morning milars | 829.984 | 1
2046 | Speaker | TTS | hello good morning milars | 699.854 | 1
2047 | Speaker | TTS | hello good morning milars | 749.288 | 1
2048 | Speaker | TTS | hello good morning milars | 631.293 | 1
2049 | Speaker | TTS | reset now | 475.114 | 1
2050 | Speaker | TTS | reset now | 490.512 | 1
2051 | Speaker | TTS | hello good morning milars | 779.53 | 1
2052 | Speaker | TTS | i know how to None | 1818.797 | 1
2053 | Speaker | TTS | do motionsing | 511.544 | 1
2054 | Speaker | TTS | reset now | 431.993 | 1
2055 | Speaker | TTS | hello good morning milars | 736.317 | 1
2056 | Speaker | TTS | hello good morning milars | 802.703 | 1
2057 | Speaker | TTS | hello good morning milars | 824.015 | 1
2058 | Speaker | TTS | hello good morning milars | 813.32 | 1
2059 | Speaker | TTS | hello good morning milars | 768.623 | 1
3000 | Nlu | nlu_analyez | amy | 72.435 | 1
3000 | Nlu | nlu_analyez | are | 1572.384 | 1
3000 | Nlu | nlu_analyez | hello | 69.128
3000 | Nlu | nlu_analyez | hello | 53.189
3000 | Nlu | nlu_analyez | hello | 50.998
3000 | Nlu | nlu_analyez | hello | 68.932 | 1
3000 | Nlu | nlu_analyez | hello | 59.657 | 1
3000 | Nlu | nlu_analyez | hello | 61.527 | 1
3000 | Nlu | nlu_analyez | hello | 57.94 | 1
3000 | Nlu | nlu_analyez | hello | 1337.424 | 1
3000 | Nlu | nlu_analyez | hello | 48.873 | 1
3000 | Nlu | nlu_analyez | hello | 51.433 | 1
3000 | Nlu | nlu_analyez | hello | 49.057 | 1
3000 | Nlu | nlu_analyez | hello | 59.363 | 1
3000 | Nlu | nlu_analyez | hello | 60.275 | 1
3000 | Nlu | nlu_analyez | how | 55.386 | 1
3000 | Nlu | nlu_analyez | oh hello | 841.029 | 1
3000 | Nlu | nlu_analyez | yeah | 68.503 | 1
3000 | Nlu | nlu_analyez | yeah | 49.132 | 1
3001 | Nlu | nlu_analyez | also name | 58.407 | 0
3001 | Nlu | nlu_analyez | hello | 48.155 | 1
3001 | Nlu | nlu_analyez | hello | 60.034 | 1
3001 | Nlu | nlu_analyez | hello | 49.177 | 1
3001 | Nlu | nlu_analyez | hello | 51.559 | 1
3001 | Nlu | nlu_analyez | hello hello | 105.446 | 1
3001 | Nlu | nlu_analyez | i teach her how do you think | 62.569
3001 | Nlu | nlu_analyez | i'll teach you how to fly | 526.842
3001 | Nlu | nlu_analyez | me | 2706.1 | 1
3001 | Nlu | nlu_analyez | oh | 48.706 | 1
3001 | Nlu | nlu_analyez | she was | 65.974 | 1
3001 | Nlu | nlu_analyez | this | 60.048 | 0
3001 | Nlu | nlu_analyez | what's her name | 59.742 | 1
3001 | Nlu | nlu_analyez | what's your name | 76.686
3001 | Nlu | nlu_analyez | what's your name | 70.893 | 1
3001 | Nlu | nlu_analyez | what's your name | 70.31 | 1
3001 | Nlu | nlu_analyez | what's your name | 53.278 | 1
3002 | Nlu | nlu_analyez | can you do emotion dance | 53.632 | 1
3002 | Nlu | nlu_analyez | hello | 50.009 | 1
3002 | Nlu | nlu_analyez | hello | 48.716 | 1
3002 | Nlu | nlu_analyez | hello | 52.221 | 1
3002 | Nlu | nlu_analyez | hello | 65.371 | 1
3002 | Nlu | nlu_analyez | hello | 55.023 | 1
3002 | Nlu | nlu_analyez | hi by | 62.547 | 1
3002 | Nlu | nlu_analyez | i teach you how do you think | 48.408
3002 | Nlu | nlu_analyez | oh hello | 52.609 | 1
3002 | Nlu | nlu_analyez | one | 54.894 | 1
3002 | Nlu | nlu_analyez | some bitterness | 70.638 | 1
3002 | Nlu | nlu_analyez | the | 64.926 | 1
3002 | Nlu | nlu_analyez | what's my name | 61.948 | 1
3002 | Nlu | nlu_analyez | what's your name | 74.795 | 1
3002 | Nlu | nlu_analyez | with my name | 69.617
3003 | Nlu | nlu_analyez | bye bye | 60.16 | 1
3003 | Nlu | nlu_analyez | for | 7062.549 | 0
3003 | Nlu | nlu_analyez | hello | 49.024 | 1
3003 | Nlu | nlu_analyez | hello | 52.188 | 1
3003 | Nlu | nlu_analyez | hello hello | 56.261 | 1
3003 | Nlu | nlu_analyez | hi well to to you dance | 67.273 | 0
3003 | Nlu | nlu_analyez | i teach you how to dance | 48.733
3003 | Nlu | nlu_analyez | i want to tissue hello | 74.591
3003 | Nlu | nlu_analyez | one | 52.982 | 1
3003 | Nlu | nlu_analyez | stop | 62.909 | 1
3003 | Nlu | nlu_analyez | what i | 47.361 | 0
3003 | Nlu | nlu_analyez | yeah | 67.268 | 1
3003 | Nlu | nlu_analyez | you that she was his movies | 73.587 | 1
3004 | Nlu | nlu_analyez | and | 174.401 | 1
3004 | Nlu | nlu_analyez | hello | 65.215
3004 | Nlu | nlu_analyez | hello | 51.417 | 1
3004 | Nlu | nlu_analyez | hello | 48.479 | 1
3004 | Nlu | nlu_analyez | hello | 56.163 | 1
3004 | Nlu | nlu_analyez | hello hello | 52.051 | 1
3004 | Nlu | nlu_analyez | hello hello hello hello hello hello hello hello hello hello | 52.418 | 1
3004 | Nlu | nlu_analyez | hey | 72.229 | 1
3004 | Nlu | nlu_analyez | i want to teach you hello | 69.068
3004 | Nlu | nlu_analyez | maggie | 65.494 | 1
3004 | Nlu | nlu_analyez | the soon | 62.478 | 1
3005 | Nlu | nlu_analyez | but | 75.807 | 1
3005 | Nlu | nlu_analyez | hello | 56.48
3005 | Nlu | nlu_analyez | hello | 51.906 | 1
3005 | Nlu | nlu_analyez | hello | 64.847 | 1
3005 | Nlu | nlu_analyez | hello | 52.358 | 1
3005 | Nlu | nlu_analyez | hello | 76.26 | 1
3005 | Nlu | nlu_analyez | hello hello | 54.702 | 1
3005 | Nlu | nlu_analyez | please do hello | 66.006 | 0
3005 | Nlu | nlu_analyez | the | 69.279 | 1
3005 | Nlu | nlu_analyez | the motion hello | 73.8
3005 | Nlu | nlu_analyez | there's still time to | 59.332 | 0
3006 | Nlu | nlu_analyez | bye bye | 61.035
3006 | Nlu | nlu_analyez | can you do a hello | 75.555 | 0
3006 | Nlu | nlu_analyez | hello | 63.008 | 1
3006 | Nlu | nlu_analyez | hello | 58.27 | 1
3006 | Nlu | nlu_analyez | hello | 52.187 | 1
3006 | Nlu | nlu_analyez | hello | 48.956 | 1
3006 | Nlu | nlu_analyez | hello hello | 53.54 | 1
3006 | Nlu | nlu_analyez | hi | 51.73 | 1
3006 | Nlu | nlu_analyez | i teach you how to dance | 65.025
3006 | Nlu | nlu_analyez | that's right before | 67.832 | 0
3006 | Nlu | nlu_analyez | years | 59.241 | 1
3007 | Nlu | nlu_analyez | by | 61.656 | 0
3007 | Nlu | nlu_analyez | hello | 64.532 | 1
3007 | Nlu | nlu_analyez | hello | 73.228 | 1
3007 | Nlu | nlu_analyez | hello | 51.939 | 1
3007 | Nlu | nlu_analyez | hello | 53.101 | 1
3007 | Nlu | nlu_analyez | hello hello | 66.392 | 1
3007 | Nlu | nlu_analyez | k u hello | 72.916 | 1
3007 | Nlu | nlu_analyez | still | 51.172 | 1
3007 | Nlu | nlu_analyez | yeah | 1034.452 | 1
3008 | Nlu | nlu_analyez | hello | 74.859 | 1
3008 | Nlu | nlu_analyez | hello | 61.846 | 1
3008 | Nlu | nlu_analyez | hello | 51.647 | 1
3008 | Nlu | nlu_analyez | hello hello | 53.647 | 1
3008 | Nlu | nlu_analyez | hello hello | 52.227 | 1
3008 | Nlu | nlu_analyez | k u hello | 51.539 | 1
3008 | Nlu | nlu_analyez | oh | 210.361 | 1
3009 | Nlu | nlu_analyez | can you do motion hello | 67.236 | 1
3009 | Nlu | nlu_analyez | guy | 81.106 | 1
3009 | Nlu | nlu_analyez | hello | 64.721 | 1
3009 | Nlu | nlu_analyez | hello | 51.73 | 1
3009 | Nlu | nlu_analyez | hello hello | 60.945 | 1
3009 | Nlu | nlu_analyez | hey | 357.491 | 1
3009 | Nlu | nlu_analyez | i | 48.165 | 1
3010 | Nlu | nlu_analyez | bye bye | 56.571 | 1
3010 | Nlu | nlu_analyez | goodbye | 75.765 | 1
3010 | Nlu | nlu_analyez | hello | 64.569 | 1
3010 | Nlu | nlu_analyez | hello | 64.171 | 1
3010 | Nlu | nlu_analyez | hello | 50.809 | 1
3010 | Nlu | nlu_analyez | hello hello | 51.229 | 1
3010 | Nlu | nlu_analyez | man | 378.99 | 1
3011 | Nlu | nlu_analyez | grew by | 61.732 | 0
3011 | Nlu | nlu_analyez | hello | 59.243 | 1
3011 | Nlu | nlu_analyez | hello | 51.302 | 1
3011 | Nlu | nlu_analyez | motion hello | 50.348 | 1
3011 | Nlu | nlu_analyez | yeah | 2787.006 | 1
3012 | Nlu | nlu_analyez | hello | 61.497 | 1
3012 | Nlu | nlu_analyez | hello | 51.557 | 1
3012 | Nlu | nlu_analyez | kobe | 48.617 | 0
3012 | Nlu | nlu_analyez | yes | 61.737 | 1
3013 | Nlu | nlu_analyez | goodbye | 52.508 | 1
3013 | Nlu | nlu_analyez | hello | 67.386 | 1
3013 | Nlu | nlu_analyez | hello | 53.331 | 1
3013 | Nlu | nlu_analyez | me | 62.43 | 1
3013 | Nlu | nlu_analyez | to modern dance | 73.533 | 1
3014 | Nlu | nlu_analyez | ever | 70.703 | 1
3014 | Nlu | nlu_analyez | good morning | 58.539 | 1
3014 | Nlu | nlu_analyez | hello | 59.512 | 1
3014 | Nlu | nlu_analyez | hello | 53.913 | 1
3014 | Nlu | nlu_analyez | what's your name | 63.688 | 1
3015 | Nlu | nlu_analyez | grab one | 1570.058 | 0
3015 | Nlu | nlu_analyez | hello commotion hello | 48.392 | 0
3015 | Nlu | nlu_analyez | hello hello hello | 59.194 | 1
3015 | Nlu | nlu_analyez | hey you do emotion dance | 70.843 | 1
3015 | Nlu | nlu_analyez | you in system | 62.875 | 0
3016 | Nlu | nlu_analyez | can you do emotion hello | 65.655 | 1
3016 | Nlu | nlu_analyez | good afternoon | 259.517 | 1
3016 | Nlu | nlu_analyez | hello | 59.276 | 1
3017 | Nlu | nlu_analyez | good night | 260.746 | 1
3017 | Nlu | nlu_analyez | hello | 60.967 | 1
3018 | Nlu | nlu_analyez | hello | 62.312 | 1
3018 | Nlu | nlu_analyez | so my name | 62.526 | 1
3019 | Nlu | nlu_analyez | say my name | 52.142 | 1
3019 | Nlu | nlu_analyez | to motion downs | 73.282 | 1
3020 | Nlu | nlu_analyez | the motion downs | 69.722 | 1
3020 | Nlu | nlu_analyez | what's your name | 51.489 | 1
3021 | Nlu | nlu_analyez | promotion fly | 55.862 | 1
3022 | Nlu | nlu_analyez | to emotion pounds | 80.107 | 1
3023 | Nlu | nlu_analyez | emotion hello | 55.017 | 0
3028 | Nlu | nlu_analyez | by | 59.001 | 0
3036 | Nlu | nlu_analyez | he | 54.156 | 1
3039 | Nlu | nlu_analyez | oh | 70.581 | 1
3040 | Nlu | nlu_analyez | o k you done studies | 70.04 | 0
3041 | Nlu | nlu_analyez | densities | 63.011 | 0
3042 | Nlu | nlu_analyez | can you dance | 52.4 | 1
3043 | Nlu | nlu_analyez | emotion hello | 59.947 | 0
3044 | Nlu | nlu_analyez | do motion hello | 75.669 | 1
3044 | Nlu | nlu_analyez | the | 48.142 | 1
3045 | Nlu | nlu_analyez | how do emotion fly | 68.677 | 1
3045 | Nlu | nlu_analyez | the | 52.556 | 1
3046 | Nlu | nlu_analyez | hi can teach you how to sing | 80.356 | 1
3047 | Nlu | nlu_analyez | what | 51.114 | 1
3048 | Nlu | nlu_analyez | right | 73.861 | 1
4000 | Microphone | STT | hello | 2.301 | 1
4001 | Microphone | STT | what's your name | 4.832 | 1
4002 | Microphone | STT | hello | 49.406 | 1
4002 | Microphone | STT | can you do emotion dance | 3.089 | 1
4004 | Microphone | STT | are | 13.276 | 1
4005 | Microphone | STT | oh hello | 2.79 | 1
4006 | Microphone | STT | yeah | 22.27 | 1
4006 | Microphone | STT | hello hello | 7.472 | 1
4007 | Microphone | STT | hello | 4.497 | 1
4007 | Microphone | STT | oh hello | 3.799 | 1
4008 | Microphone | STT | oh | 2.883 | 1
4008 | Microphone | STT | hello hello | 2.647 | 1
4009 | Microphone | STT | hello | 2.843 | 1
4009 | Microphone | STT | hello hello hello hello hello hello hello hello hello hello | 1.113 | 1
4010 | Microphone | STT | hello hello | 6.022 | 1
4010 | Microphone | STT | hello | 3.342 | 1
4011 | Microphone | STT | this | 9.375 | 1
4011 | Microphone | STT | hello hello | 1.133 | 1
4011 | Microphone | STT | hello hello | 0.909 | 1
4012 | Microphone | STT | she was | 29.74 | 1
4012 | Microphone | STT | hello hello | 8.279 | 1
4012 | Microphone | STT | hello | 7.804 | 1
4013 | Microphone | STT | hello | 5.339 | 1
4013 | Microphone | STT | hello hello | 2.83 | 1
4014 | Microphone | STT | hello | 6.014 | 1
4014 | Microphone | STT | hello hello | 1.549 | 1
4015 | Microphone | STT | hello hello | 1.981 | 1
4015 | Microphone | STT | hello hello | 1.523 | 1
4016 | Microphone | STT | some bitterness | 27.431 | 1
4016 | Microphone | STT | i | 1.7 | 1
4017 | Microphone | STT | goodbye | 5.235 | 1
4018 | Microphone | STT | grew by | 2.147 | 1
4019 | Microphone | STT | kobe | 4.25 | 1
4020 | Microphone | STT | goodbye | 4.008 | 1
4021 | Microphone | STT | good morning | 3.887 | 1
4022 | Microphone | STT | grab one | 14.33 | 1
4023 | Microphone | STT | good afternoon | 3.299 | 1
4024 | Microphone | STT | good night | 2.896 | 1
4025 | Microphone | STT | so my name | 8.999 | 1
4026 | Microphone | STT | say my name | 1.579 | 1
4027 | Microphone | STT | what's your name | 4.14 | 1
4040 | Microphone | STT | amy | 18.485 | 1
4044 | Microphone | STT | he | 9.344 | 1
4045 | Microphone | STT | me | 26.51 | 1
4060 | Microphone | STT | promotion towns | 10.958 | 1
4079 | Microphone | STT | right | 6.958 | 1
4090 | Microphone | STT | the | 16.774 | 1
4093 | Microphone | STT | stop | 20.878 | 1
4127 | Microphone | STT | for | 19.16 | 1
4146 | Microphone | STT | you that she was his movies | 40.211 | 1
4147 | Microphone | STT | the soon | 26.558 | 1
4149 | Microphone | STT | there's still time to | 7.083 | 1
4153 | Microphone | STT | the | 22.095 | 1
4155 | Microphone | STT | the | 14.757 | 1
4168 | Microphone | STT | and | 24.359 | 1
4180 | Microphone | STT | the | 23.989 | 1
4196 | Microphone | STT | years | 25.914 | 1
4237 | Microphone | STT | still | 15.011 | 1
4319 | Microphone | STT | maggie | 32.214 | 1
4434 | Microphone | STT | hello | 7.956 | 1
4440 | Microphone | STT | that's right before | 27.601 | 1
4534 | Microphone | STT | yeah | 24.707 | 1
4603 | Microphone | STT | oh | 5.986 | 1
4674 | Microphone | STT | guy | 26.797 | 1
4682 | Microphone | STT | man | 25.939 | 1
4688 | Microphone | STT | yeah | 30.478 | 1
4704 | Microphone | STT | yes | 24.972 | 1
4820 | Microphone | STT | you in system | 48.336 | 1
