milars-z/Real-Time-Embedded-Programming/docs/test_data/20260417_log.csv

TaskID | Module | Type | TargetName | Duration(ms) | issuccess
2000 | Speaker | TTS | sorry i didn't understand that | 1539.284 | 1
2001 | Speaker | TTS | sorry i didn't understand that | 1547.983 | 1
2024 | Speaker | TTS | reset now | 456.671 | 1
2028 | Speaker | TTS | reset now | 535.537 | 1
2000 | Speaker | TTS | reset now | 595.328 | 1
2000 | Speaker | TTS | reset now | 556.466 | 1
2001 | Speaker | TTS | reset now | 427.777 | 1
2001 | Speaker | TTS | reset now | 479.132 | 1
2002 | Speaker | TTS | reset now | 460.606 | 1
2003 | Speaker | TTS | reset now | 458.314 | 1
2004 | Speaker | TTS | reset now | 484.086 | 1
2002 | Speaker | TTS | reset now | 431.35 | 1
2003 | Speaker | TTS | reset now | 540.738 | 1
2004 | Speaker | TTS | reset now | 473.686 | 1
2006 | Speaker | TTS | reset now | 421.685 | 1
2001 | Speaker | TTS | reset now | 376.171 | 1
2003 | Speaker | TTS | reset now | 436.141 | 1
2004 | Speaker | TTS | reset now | 432.358 | 1
2007 | Speaker | TTS | reset now | 1210.829 | 1
2008 | Speaker | TTS | reset now | 450.845 | 1
2009 | Speaker | TTS | reset now | 433.716 | 1
2010 | Speaker | TTS | reset now | 448.949 | 1
2011 | Speaker | TTS | reset now | 471.221 | 1
2012 | Speaker | TTS | reset now | 443.549 | 1
2013 | Speaker | TTS | reset now | 419.047 | 1
2001 | Speaker | TTS | learn objectcansuccessfully | 1058.547 | 1
2002 | Speaker | TTS | learn objectcansuccessfully | 1062.976 | 1
2002 | Speaker | TTS | learn objectcansuccessfully | 1014.867 | 1
2002 | Speaker | TTS | learn objectcansuccessfully | 1050.941 | 1
2001 | Speaker | TTS | learn objectcansuccessfully | 1050.927 | 1
2001 | Speaker | TTS | learn objectbottomsuccessfully | 1060.452 | 1
2009 | Speaker | TTS | learn objectbottomsuccessfully | 1399.215 | 1
2003 | Speaker | TTS | learn motion two | 612.804 | 1
2005 | Speaker | TTS | learn motion three | 855.218 | 1
2012 | Speaker | TTS | learn motion six | 621.812 | 1
2016 | Speaker | TTS | learn motion seven | 669.811 | 1
2001 | Speaker | TTS | learn motion one | 664.039 | 1
2007 | Speaker | TTS | learn motion four | 981.438 | 1
2010 | Speaker | TTS | learn motion five | 756.454 | 1
2021 | Speaker | TTS | learn motion eight | 568.217 | 1
2004 | Speaker | TTS | i know how to two | 681.382 | 1
2006 | Speaker | TTS | i know how to three | 720.447 | 1
2014 | Speaker | TTS | i know how to six | 711.509 | 1
2018 | Speaker | TTS | i know how to seven | 619.94 | 1
2002 | Speaker | TTS | i know how to one | 652.986 | 1
2026 | Speaker | TTS | i know how to None | 682.286 | 1
2027 | Speaker | TTS | i know how to None | 706.315 | 1
2006 | Speaker | TTS | i know how to None | 653.321 | 1
2008 | Speaker | TTS | i know how to four | 725.105 | 1
2011 | Speaker | TTS | i know how to five | 734.954 | 1
2022 | Speaker | TTS | i know how to eight | 544.271 | 1
2009 | Speaker | TTS | hello good morning milars | 683.484 | 1
2017 | Speaker | TTS | hello good morning milars | 799.936 | 1
2019 | Speaker | TTS | hello good morning milars | 795.926 | 1
2020 | Speaker | TTS | hello good morning milars | 732.472 | 1
2002 | Speaker | TTS | hello good morning milars | 839.335 | 1
2001 | Speaker | TTS | hello good morning milars | 948.441 | 1
2003 | Speaker | TTS | hello good morning milars | 853.9 | 1
2005 | Speaker | TTS | hello good morning milars | 786.964 | 1
2005 | Speaker | TTS | hello good morning milars | 834.437 | 1
2002 | Speaker | TTS | hello good morning milars | 1000.489 | 1
2000 | Speaker | TTS | hello good morning milars | 732.551 | 1
2001 | Speaker | TTS | hello good morning milars | 687.22 | 1
2002 | Speaker | TTS | hello good morning milars | 665.649 | 1
2003 | Speaker | TTS | hello good morning milars | 682.15 | 1
2004 | Speaker | TTS | hello good morning milars | 667.23 | 1
2005 | Speaker | TTS | hello good morning milars | 709.991 | 1
2006 | Speaker | TTS | hello good morning milars | 652.266 | 1
2007 | Speaker | TTS | hello good morning milars | 689.146 | 1
2008 | Speaker | TTS | hello good morning milars | 653.689 | 1
2000 | Speaker | TTS | hello good morning milars | 805.847 | 1
2001 | Speaker | TTS | hello good morning milars | 882.967 | 1
2000 | Speaker | TTS | hello good morning milars | 1200.836 | 1
2005 | Speaker | TTS | hello good morning milars | 941.032 | 1
2015 | Speaker | TTS | good bye milars | 542.829 | 1
2002 | Speaker | TTS | good bye milars | 540.243 | 1
2025 | Speaker | TTS | do motionnine | 492.832 | 1
2029 | Speaker | TTS | do motionnine | 492.056 | 1
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
70 | Screen-Motion | DO_MOTION | left_r | 62.168 | 0
71 | Screen-Motion | DO_MOTION | left_r | 62.117 | 0
72 | Screen-Motion | DO_MOTION | left_r | 62.939 | 0
73 | Screen-Motion | DO_MOTION | left_r | 62.157 | 0
74 | Screen-Motion | DO_MOTION | left_u | 62.195 | 0
75 | Screen-Motion | DO_MOTION | left_u | 62.159 | 0
76 | Screen-Motion | DO_MOTION | left_l | 62.195 | 0
77 | Screen-Motion | DO_MOTION | left_l | 62.173 | 0
78 | Screen-Motion | DO_MOTION | left_d | 62.278 | 0
79 | Screen-Motion | DO_MOTION | left_d | 62.528 | 0
80 | Screen-Motion | DO_MOTION | left_r | 65.234 | 0
81 | Screen-Motion | DO_MOTION | left_r | 62.644 | 0
82 | Screen-Motion | DO_MOTION | left_u | 66.486 | 0
83 | Screen-Motion | DO_MOTION | left_u | 62.148 | 0
84 | Screen-Motion | DO_MOTION | left_l | 65.235 | 0
85 | Screen-Motion | DO_MOTION | left_l | 62.156 | 0
86 | Screen-Motion | DO_MOTION | left_l | 62.17 | 0
87 | Screen-Motion | DO_MOTION | left_l | 63.004 | 0
88 | Screen-Motion | DO_MOTION | left_l | 62.179 | 0
89 | Screen-Motion | DO_MOTION | left_l | 62.145 | 0
90 | Screen-Motion | DO_MOTION | left_u | 62.181 | 0
91 | Screen-Motion | DO_MOTION | left_u | 62.193 | 0
92 | Screen-Motion | DO_MOTION | left_l | 12854.297 | 0
93 | Screen-Motion | DO_MOTION | left_l | 12835.607 | 0
94 | Screen-Motion | DO_MOTION | left_d | 13300.836 | 0
95 | Screen-Motion | DO_MOTION | left_d | 12532.949 | 0
96 | Screen-Motion | DO_MOTION | left_r | 12761.348 | 0
97 | Screen-Motion | DO_MOTION | left_r | 12763.121 | 0
98 | Screen-Motion | DO_MOTION | left_u | 12443.105 | 0
99 | Screen-Motion | DO_MOTION | left_u | 12433.071 | 0
3000 | Nlu | nlu_analyez | of | 75.454 | 0
3001 | Nlu | nlu_analyez | hi | 58.16 | 1
3002 | Nlu | nlu_analyez | the bush | 64.892 | 1
3003 | Nlu | nlu_analyez | the say | 60.686 | 1
3004 | Nlu | nlu_analyez | nomination | 68.679 | 1
3005 | Nlu | nlu_analyez | some | 62.306 | 1
3006 | Nlu | nlu_analyez | more | 57.238 | 1
3000 | Nlu | nlu_analyez | yeah | 70.13 | 1
3000 | Nlu | nlu_analyez | issue | 88.242 | 1
3000 | Nlu | nlu_analyez | the | 80.663 | 1
3000 | Nlu | nlu_analyez | the | 62.957 | 1
3000 | Nlu | nlu_analyez | sure | 70.274 | 1
3001 | Nlu | nlu_analyez | it all | 69.767 | 1
3000 | Nlu | nlu_analyez | ah | 69.319 | 1
3000 | Nlu | nlu_analyez | the though | 79.407 | 0
3001 | Nlu | nlu_analyez | hello | 78.184 | 1
3000 | Nlu | nlu_analyez | hello | 68.669 | 1
3001 | Nlu | nlu_analyez | hello | 63.649 | 1
3002 | Nlu | nlu_analyez | hello | 55.834 | 1
3003 | Nlu | nlu_analyez | hello | 59.537 | 1
3004 | Nlu | nlu_analyez | hello | 57.496 | 1
3005 | Nlu | nlu_analyez | hello hello hello | 64.136 | 1
3006 | Nlu | nlu_analyez | hello | 53.311 | 1
3007 | Nlu | nlu_analyez | hello | 51.038 | 1
3008 | Nlu | nlu_analyez | hello | 62.611 | 1
3000 | Nlu | nlu_analyez | oh | 70.592 | 1
3001 | Nlu | nlu_analyez | hello good morning | 71.712 | 1
3002 | Nlu | nlu_analyez | hello good morning minutes | 71.913 | 1
3000 | Nlu | nlu_analyez | hello | 79.03 | 1
3001 | Nlu | nlu_analyez | just | 79.216 | 1
4009 | Microphone | STT | yeah | 28.232 | 1
4005 | Microphone | STT | the though | 16.043 | 1
4096 | Microphone | STT | the say | 12.624 | 1
4092 | Microphone | STT | the bush | 36.505 | 1
4025 | Microphone | STT | the | 15.123 | 1
4026 | Microphone | STT | the | 14.733 | 1
4039 | Microphone | STT | sure | 8.302 | 1
4113 | Microphone | STT | some | 21.075 | 1
4005 | Microphone | STT | oh | 2.828 | 1
4015 | Microphone | STT | of | 37.585 | 1
4106 | Microphone | STT | nomination | 25.049 | 1
4114 | Microphone | STT | more | 29.774 | 1
4008 | Microphone | STT | just | 7.71 | 1
4043 | Microphone | STT | it all | 17.528 | 1
4011 | Microphone | STT | issue | 19.421 | 1
4078 | Microphone | STT | hi | 23.096 | 1
4005 | Microphone | STT | hello hello hello | 1.005 | 1
4007 | Microphone | STT | hello good morning minutes | 3.346 | 1
4006 | Microphone | STT | hello good morning | 16.901 | 1
4006 | Microphone | STT | hello | 10.176 | 1
4000 | Microphone | STT | hello | 1.724 | 1
4001 | Microphone | STT | hello | 2.174 | 1
4002 | Microphone | STT | hello | 4.389 | 1
4003 | Microphone | STT | hello | 4.807 | 1
4004 | Microphone | STT | hello | 2.226 | 1
4006 | Microphone | STT | hello | 0.69 | 1
4007 | Microphone | STT | hello | 2.638 | 1
4008 | Microphone | STT | hello | 2.947 | 1
4000 | Microphone | STT | hello | 9.729 | 1
4030 | Microphone | STT | ah | 21.817 | 1
1000 | Camera | Update | None | 43.507 | 1
1001 | Camera | Learn | can | 52.726 | 1
1002 | Camera | Detecte | can | 31.131 | 1
1000 | Camera | Update | None | 34.665 | 1
1001 | Camera | Detecte | can | 29.51 | 1
1000 | Camera | Update | None | 72.11 | 1
1000 | Camera | Update | None | 32.758 | 1
1001 | Camera | Detecte | can | 39.19 | 0
1002 | Camera | Learn | can | 31.952 | 1
1003 | Camera | Detecte | can | 28.66 | 1
1000 | Camera | Update | None | 28.657 | 1
1001 | Camera | Detecte | can | 34.562 | 1
1000 | Camera | Update | None | 34.982 | 1
1001 | Camera | Detecte | can | 38.501 | 1
1000 | Camera | Update | None | 33.03 | 1
1001 | Camera | Detecte | can | 33.472 | 1
1002 | Camera | Detecte | can | 34.286 | 1
1003 | Camera | Detecte | can | 35.536 | 1
1004 | Camera | Detecte | can | 30.518 | 1
1005 | Camera | Learn | can | 60.817 | 1
1006 | Camera | Detecte | can | 29.314 | 1
1000 | Camera | Update | None | 31.951 | 1
1001 | Camera | Detecte | can | 30.483 | 1
1002 | Camera | Learn | bottom | 36.601 | 1
1003 | Camera | Detecte | bottom | 33.416 | 1
1004 | Camera | Detecte | can | 31.542 | 1
1005 | Camera | Detecte | bottom | 30.044 | 1
1000 | Camera | Update | None | 29.941 | 1
1001 | Camera | Detecte | can | 32.112 | 1
1002 | Camera | Detecte | can | 29.993 | 0
1003 | Camera | Learn | can | 36.317 | 1
1004 | Camera | Detecte | can | 34.291 | 1
1000 | Camera | Update | None | 31.624 | 1
1001 | Camera | Detecte | can | 32.949 | 1
1002 | Camera | Detecte | can | 29.316 | 1
1000 | Camera | Update | None | 40.865 | 1
1001 | Camera | Detecte | can | 33.95 | 1
1002 | Camera | Detecte | can | 31.1 | 1
1003 | Camera | Detecte | can | 28.808 | 1
1004 | Camera | Detecte | can | 30.742 | 1
1005 | Camera | Detecte | bottom | 32.305 | 1
1006 | Camera | Detecte | can | 30.889 | 1
1007 | Camera | Detecte | can | 34.149 | 1
1008 | Camera | Detecte | can | 27.158 | 1
1000 | Camera | Update | None | 36.327 | 1
1001 | Camera | Learn | can | 36.879 | 1
1002 | Camera | Detecte | can | 27.917 | 1
1003 | Camera | Detecte | can | 38.921 | 1
1004 | Camera | Detecte | can | 34.773 | 1
1005 | Camera | Detecte | can | 31.388 | 1
1006 | Camera | Detecte | bottom | 33.103 | 0
1007 | Camera | Detecte | bottom | 34.82 | 0
1008 | Camera | Learn | bottom | 36.771 | 1
1009 | Camera | Detecte | bottom | 30.322 | 1
1000 | Camera | Update | None | 32.518 | 1
1001 | Camera | Detecte | can | 31.306 | 1
1000 | Camera | Update | None | 35.075 | 1
1001 | Camera | Detecte | can | 27.44 | 1
1000 | Camera | Update | None | 31.036 | 1
1001 | Camera | Detecte | ii | 34.051 | 1
1002 | Camera | Detecte | ii | 33.729 | 0
1003 | Camera | Detecte | ii | 32.926 | 1
1004 | Camera | Detecte | ii | 39.096 | 1
1005 | Camera | Detecte | ii | 32.341 | 1
1006 | Camera | Detecte | ii | 37.137 | 1
1007 | Camera | Detecte | ii | 33.68 | 1
1008 | Camera | Detecte | ii | 38.295 | 1
1009 | Camera | Detecte | ii | 30.683 | 1
1010 | Camera | Detecte | ii | 36.934 | 1
1011 | Camera | Update | None | 27.715 | 1
1012 | Camera | Update | None | 32.46 | 1
1013 | Camera | Update | None | 33.131 | 1
1014 | Camera | Update | None | 30.996 | 1
1015 | Camera | Update | None | 33.817 | 1
1016 | Camera | Update | None | 30.07 | 1
