milars-z/Real-Time-Embedded-Programming/docs/test_data/daily_raw_log.csv

TaskID | Module | Type | TargetName | Duration(ms) | issuccess
1000 | Camera | Update | None | 48.62
1001 | Camera | Learn | ll | 60.99
1002 | Camera | Detecte | ll | 49.96
1003 | Camera | Detecte | ll | 39.27
1004 | Camera | Detecte | oo | 48.09
1000 | Camera | Update | None | 57.910
1001 | Camera | Update | None | 28.382
1002 | Camera | Update | None | 27.925
1003 | Camera | Learn | yy | 55.265
1004 | Camera | Learn | yy | 29.616
1005 | Camera | Detecte | yy | 26.981
1006 | Camera | Detecte | yy | 30.372
1007 | Camera | Detecte | yy | 28.960
1008 | Camera | Detecte | yy | 31.732
1009 | Camera | Detecte | yy | 30.895
1010 | Camera | Detecte | yy | 26.257
1011 | Camera | Detecte | yy | 30.252
1012 | Camera | Detecte | yy | 32.040
1013 | Camera | Detecte | yy | 27.314
1014 | Camera | Detecte | yy | 31.079
3000 | Nlu | nlu_analyez | hello | 69.128
3001 | Nlu | nlu_analyez | what's your name | 76.686
3002 | Nlu | nlu_analyez | with my name | 69.617
3003 | Nlu | nlu_analyez | i want to tissue hello | 74.591
3004 | Nlu | nlu_analyez | i want to teach you hello | 69.068
3005 | Nlu | nlu_analyez | the motion hello | 73.800
3006 | Nlu | nlu_analyez | i teach you how to dance | 65.025
3000 | Nlu | nlu_analyez | hello | 53.189
3001 | Nlu | nlu_analyez | i'll teach you how to fly | 526.842
3000 | Nlu | nlu_analyez | hello | 50.998
3001 | Nlu | nlu_analyez | i teach her how do you think | 62.569
3002 | Nlu | nlu_analyez | i teach you how do you think | 48.408
3003 | Nlu | nlu_analyez | i teach you how to dance | 48.733
3004 | Nlu | nlu_analyez | hello | 65.215
3005 | Nlu | nlu_analyez | hello | 56.480
3006 | Nlu | nlu_analyez | bye bye | 61.035
3000 | Nlu | nlu_analyez | hello | 68.932 | 1
3001 | Nlu | nlu_analyez | what's your name | 70.893 | 1
3002 | Nlu | nlu_analyez | what's my name | 61.948 | 1
3003 | Nlu | nlu_analyez | hi well to to you dance | 67.273 | 0
3004 | Nlu | nlu_analyez | hello | 51.417 | 1
3005 | Nlu | nlu_analyez | please do hello | 66.006 | 0
3006 | Nlu | nlu_analyez | can you do a hello | 75.555 | 0
3007 | Nlu | nlu_analyez | k u hello | 72.916 | 1
3008 | Nlu | nlu_analyez | k u hello | 51.539 | 1
3009 | Nlu | nlu_analyez | can you do motion hello | 67.236 | 1
3010 | Nlu | nlu_analyez | hello | 64.569 | 1
3011 | Nlu | nlu_analyez | motion hello | 50.348 | 1
3012 | Nlu | nlu_analyez | huh | 69.468 | 1
3013 | Nlu | nlu_analyez | hello | 67.386 | 1
3014 | Nlu | nlu_analyez | what's your name | 63.688 | 1
3000 | Nlu | nlu_analyez | hello | 59.657 | 1
2000 | Speaker | TTS | None | 2619.178 | 1
3001 | Nlu | nlu_analyez | what's your name | 70.310 | 1
2001 | Speaker | TTS | None | 2512.055 | 1
3002 | Nlu | nlu_analyez | one | 54.894 | 1
2002 | Speaker | TTS | None | 2102.427 | 1
3003 | Nlu | nlu_analyez | one | 52.982 | 1
2003 | Speaker | TTS | None | 1970.333 | 1
3004 | Nlu | nlu_analyez | huh | 78.533 | 1
2004 | Speaker | TTS | None | 2038.115 | 1
3005 | Nlu | nlu_analyez | huh | 61.828 | 1
2005 | Speaker | TTS | None | 1968.977 | 1
3006 | Nlu | nlu_analyez | huh | 61.782 | 1
2006 | Speaker | TTS | None | 2020.572 | 1
3007 | Nlu | nlu_analyez | by | 61.656 | 0
3000 | Nlu | nlu_analyez | hello | 61.527 | 1
2000 | Speaker | TTS | None | 665.878 | 1
3001 | Nlu | nlu_analyez | also name | 58.407 | 0
2001 | Speaker | TTS | None | 1386.977 | 1
3002 | Nlu | nlu_analyez | hello | 50.009 | 1
2002 | Speaker | TTS | None | 642.303 | 1
3003 | Nlu | nlu_analyez | what i | 47.361 | 0
2003 | Speaker | TTS | None | 1178.840 | 1
3004 | Nlu | nlu_analyez | hey | 72.229 | 1
2004 | Speaker | TTS | None | 695.143 | 1
3000 | Nlu | nlu_analyez | hello | 57.940 | 1
2000 | Speaker | TTS | hello good morning milars | 723.809 | 1
3001 | Nlu | nlu_analyez | what's her name | 59.742 | 1
3002 | Nlu | nlu_analyez | hi by | 62.547 | 1
2002 | Speaker | TTS | hello good morning milars | 774.492 | 1
3003 | Nlu | nlu_analyez | bye bye | 60.160 | 1
2003 | Speaker | TTS | good bye milars | 532.340 | 1
3004 | Nlu | nlu_analyez | huh | 84.314 | 1
2004 | Speaker | TTS | hello good morning milars | 719.828 | 1
3005 | Nlu | nlu_analyez | huh | 50.324 | 1
2005 | Speaker | TTS | hello good morning milars | 671.279 | 1
3006 | Nlu | nlu_analyez | hi | 51.730 | 1
2006 | Speaker | TTS | hello good morning milars | 663.192 | 1
3000 | Nlu | nlu_analyez | hello | 1337.424 | 1
4000 | Microphone | STT | hello | 1338.918 | 1
4001 | Microphone | STT | None | 1.766 | 0
3001 | Nlu | nlu_analyez | hello | 48.155 | 1
4002 | Microphone | STT | hello | 49.406 | 1
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
3028 | Nlu | nlu_analyez | huh | 66.064 | 1
4032 | Microphone | STT | huh | 74.676 | 1
2028 | Speaker | TTS | hello good morning milars | 699.974 | 1
3029 | Nlu | nlu_analyez | huh | 62.646 | 1
4033 | Microphone | STT | huh | 70.952 | 1
2029 | Speaker | TTS | hello good morning milars | 752.892 | 1
3030 | Nlu | nlu_analyez | huh | 64.400 | 1
4034 | Microphone | STT | huh | 74.916 | 1
2030 | Speaker | TTS | hello good morning milars | 660.763 | 1
3031 | Nlu | nlu_analyez | huh | 62.671 | 1
4035 | Microphone | STT | huh | 72.622 | 1
2031 | Speaker | TTS | hello good morning milars | 713.648 | 1
3032 | Nlu | nlu_analyez | huh | 63.322 | 1
4036 | Microphone | STT | huh | 70.907 | 1
2032 | Speaker | TTS | hello good morning milars | 689.823 | 1
3033 | Nlu | nlu_analyez | huh | 63.294 | 1
4037 | Microphone | STT | huh | 71.119 | 1
2033 | Speaker | TTS | hello good morning milars | 677.323 | 1
3034 | Nlu | nlu_analyez | huh | 63.163 | 1
4038 | Microphone | STT | huh | 74.254 | 1
2034 | Speaker | TTS | hello good morning milars | 702.496 | 1
3035 | Nlu | nlu_analyez | huh | 66.965 | 1
4039 | Microphone | STT | huh | 77.603 | 1
2035 | Speaker | TTS | hello good morning milars | 681.225 | 1
3036 | Nlu | nlu_analyez | huh | 59.596 | 1
4040 | Microphone | STT | huh | 75.614 | 1
2036 | Speaker | TTS | hello good morning milars | 657.554 | 1
3037 | Nlu | nlu_analyez | huh | 64.955 | 1
4041 | Microphone | STT | huh | 74.400 | 1
2037 | Speaker | TTS | hello good morning milars | 686.266 | 1
3038 | Nlu | nlu_analyez | huh | 62.493 | 1
4042 | Microphone | STT | huh | 72.323 | 1
2038 | Speaker | TTS | hello good morning milars | 755.774 | 1
3039 | Nlu | nlu_analyez | oh | 70.581 | 1
4068 | Microphone | STT | oh | 73.225 | 1
2039 | Speaker | TTS | hello good morning milars | 701.927 | 1
4069 | Microphone | STT | None | 8.793 | 0
3040 | Nlu | nlu_analyez | o k you done studies | 70.040 | 0
4070 | Microphone | STT | o k you done studies | 78.409 | 1
4071 | Microphone | STT | None | 9.194 | 0
3041 | Nlu | nlu_analyez | densities | 63.011 | 0
4072 | Microphone | STT | densities | 73.995 | 1
2040 | Speaker | TTS | sorry | i didn't understand that | 1110.198 | 1
3042 | Nlu | nlu_analyez | can you dance | 52.400 | 1
4073 | Microphone | STT | can you dance | 63.805 | 1
2041 | Speaker | TTS | do motion dance | 720.238 | 1
4074 | Microphone | STT | None | 3.441 | 0
3043 | Nlu | nlu_analyez | emotion hello | 59.947 | 0
4075 | Microphone | STT | emotion hello | 66.579 | 1
2042 | Speaker | TTS | sorry | i didn't understand that | 1198.431 | 1
3044 | Nlu | nlu_analyez | do motion hello | 75.669 | 1
4076 | Microphone | STT | do motion hello | 78.211 | 1
2043 | Speaker | TTS | do motion hello | 532.075 | 1
3045 | Nlu | nlu_analyez | how do emotion fly | 68.677 | 1
4077 | Microphone | STT | how do emotion fly | 70.849 | 1
2044 | Speaker | TTS | do motion fly | 524.135 | 1
3046 | Nlu | nlu_analyez | hi can teach you how to sing | 80.356 | 1
4078 | Microphone | STT | hi can teach you how to sing | 85.695 | 1
4079 | Microphone | STT | right | 6.958 | 1
3047 | Nlu | nlu_analyez | what | 51.114 | 1
4080 | Microphone | STT | what | 53.241 | 1
2045 | Speaker | TTS | hello good morning milars | 656.942 | 1
3048 | Nlu | nlu_analyez | right | 73.861 | 1
4081 | Microphone | STT | right | 80.139 | 1
2046 | Speaker | TTS | hello good morning milars | 699.854 | 1
3049 | Nlu | nlu_analyez | huh | 64.964 | 1
4082 | Microphone | STT | huh | 73.631 | 1
2047 | Speaker | TTS | hello good morning milars | 749.288 | 1
4083 | Microphone | STT | None | 7.803 | 0
3050 | Nlu | nlu_analyez | huh | 64.517 | 1
4084 | Microphone | STT | huh | 72.651 | 1
2048 | Speaker | TTS | hello good morning milars | 631.293 | 1
2049 | Speaker | TTS | reset now | 475.114 | 1
2050 | Speaker | TTS | reset now | 490.512 | 1
3051 | Nlu | nlu_analyez | huh | 49.967 | 1
4085 | Microphone | STT | huh | 58.490 | 1
2051 | Speaker | TTS | hello good morning milars | 779.530 | 1
2052 | Speaker | TTS | i know how to None | 1818.797 | 1
4086 | Microphone | STT | None | 11.671 | 0
2053 | Speaker | TTS | do motionsing | 511.544 | 1
2054 | Speaker | TTS | reset now | 431.993 | 1
3052 | Nlu | nlu_analyez | huh | 64.962 | 1
4087 | Microphone | STT | huh | 79.274 | 1
2055 | Speaker | TTS | hello good morning milars | 736.317 | 1
3053 | Nlu | nlu_analyez | huh | 58.242 | 1
4088 | Microphone | STT | huh | 69.650 | 1
2056 | Speaker | TTS | hello good morning milars | 802.703 | 1
3054 | Nlu | nlu_analyez | huh | 58.502 | 1
4089 | Microphone | STT | huh | 66.692 | 1
2057 | Speaker | TTS | hello good morning milars | 824.015 | 1
3055 | Nlu | nlu_analyez | huh | 57.930 | 1
4090 | Microphone | STT | huh | 66.683 | 1
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
3009 | Nlu | nlu_analyez | hello | 64.721 | 1
4047 | Microphone | STT | hello | 74.782 | 1
2014 | Speaker | TTS | hello good morning milars | 790.079 | 1
3010 | Nlu | nlu_analyez | hello | 64.171 | 1
4048 | Microphone | STT | hello | 73.214 | 1
2015 | Speaker | TTS | hello good morning milars | 804.312 | 1
3011 | Nlu | nlu_analyez | hello | 59.243 | 1
4049 | Microphone | STT | hello | 74.275 | 1
2016 | Speaker | TTS | hello good morning milars | 811.287 | 1
3012 | Nlu | nlu_analyez | hello | 61.497 | 1
4050 | Microphone | STT | hello | 76.060 | 1
2017 | Speaker | TTS | hello good morning milars | 974.286 | 1
3013 | Nlu | nlu_analyez | to modern dance | 73.533 | 1
4051 | Microphone | STT | to modern dance | 75.596 | 1
2018 | Speaker | TTS | do motion dance | 737.982 | 1
3014 | Nlu | nlu_analyez | hello | 59.512 | 1
4052 | Microphone | STT | hello | 61.478 | 1
2019 | Speaker | TTS | hello good morning milars | 762.572 | 1
3015 | Nlu | nlu_analyez | hello hello hello | 59.194 | 1
4053 | Microphone | STT | hello hello hello | 61.054 | 1
2020 | Speaker | TTS | hello good morning milars | 717.249 | 1
3016 | Nlu | nlu_analyez | hello | 59.276 | 1
4054 | Microphone | STT | hello | 60.392 | 1
2021 | Speaker | TTS | hello good morning milars | 972.192 | 1
3017 | Nlu | nlu_analyez | hello | 60.967 | 1
4055 | Microphone | STT | hello | 64.210 | 1
2022 | Speaker | TTS | hello good morning milars | 1252.775 | 1
3018 | Nlu | nlu_analyez | hello | 62.312 | 1
4056 | Microphone | STT | hello | 73.968 | 1
2023 | Speaker | TTS | hello good morning milars | 1281.926 | 1
3019 | Nlu | nlu_analyez | to motion downs | 73.282 | 1
4057 | Microphone | STT | to motion downs | 87.795 | 1
2024 | Speaker | TTS | do motion downs | 708.296 | 1
3020 | Nlu | nlu_analyez | the motion downs | 69.722 | 1
4058 | Microphone | STT | the motion downs | 77.606 | 1
2025 | Speaker | TTS | do motion downs | 642.313 | 1
3021 | Nlu | nlu_analyez | promotion fly | 55.862 | 1
4059 | Microphone | STT | promotion fly | 58.057 | 1
4060 | Microphone | STT | promotion towns | 10.958 | 1
3022 | Nlu | nlu_analyez | to emotion pounds | 80.107 | 1
4061 | Microphone | STT | to emotion pounds | 96.084 | 1
2026 | Speaker | TTS | do motion pounds | 725.058 | 1
3023 | Nlu | nlu_analyez | emotion hello | 55.017 | 0
4062 | Microphone | STT | emotion hello | 58.547 | 1
2027 | Speaker | TTS | sorry | i didn't understand that | 1268.126 | 1
4063 | Microphone | STT | None | 10.211 | 0
4064 | Microphone | STT | None | 6.066 | 0
4065 | Microphone | STT | None | 12.501 | 0
4066 | Microphone | STT | None | 21.241 | 0
4067 | Microphone | STT | None | 19.814 | 0
4068 | Microphone | STT | None | 11.803 | 0
4069 | Microphone | STT | None | 10.521 | 0
4070 | Microphone | STT | None | 9.914 | 0
4071 | Microphone | STT | None | 7.138 | 0
4072 | Microphone | STT | None | 4.063 | 0
3024 | Nlu | nlu_analyez | huh | 58.337 | 1
4073 | Microphone | STT | huh | 70.578 | 1
2028 | Speaker | TTS | hello good morning milars | 744.726 | 1
3025 | Nlu | nlu_analyez | huh | 60.139 | 1
4074 | Microphone | STT | huh | 77.851 | 1
2029 | Speaker | TTS | hello good morning milars | 741.246 | 1
4075 | Microphone | STT | None | 22.098 | 0
3026 | Nlu | nlu_analyez | huh | 58.635 | 1
4076 | Microphone | STT | huh | 70.507 | 1
2030 | Speaker | TTS | hello good morning milars | 775.126 | 1
4000 | Microphone | STT | hello | 2.301 | 1
3000 | Nlu | nlu_analyez | hello | 51.433 | 1
2000 | Speaker | TTS | hello good morning milars | 742.532 | 1
4001 | Microphone | STT | what's your name | 4.832 | 1
3001 | Nlu | nlu_analyez | what's your name | 53.278 | 1
2001 | Speaker | TTS | hello i am your robot | 798.325 | 1
4002 | Microphone | STT | can you do emotion dance | 3.089 | 1
3002 | Nlu | nlu_analyez | can you do emotion dance | 53.632 | 1
2002 | Speaker | TTS | do motion dance | 638.509 | 1
4146 | Microphone | STT | you that she was his movies | 40.211 | 1
3003 | Nlu | nlu_analyez | you that she was his movies | 73.587 | 1
2003 | Speaker | TTS | hello you are milars | 542.115 | 1
4147 | Microphone | STT | the soon | 26.558 | 1
3004 | Nlu | nlu_analyez | the soon | 62.478 | 1
2004 | Speaker | TTS | do motion soon | 522.659 | 1
4148 | Microphone | STT | None | 9.148 | 0
4149 | Microphone | STT | there's still time to | 7.083 | 1
3005 | Nlu | nlu_analyez | there's still time to | 59.332 | 0
2005 | Speaker | TTS | sorry | i didn't understand that | 1153.452 | 1
4196 | Microphone | STT | years | 25.914 | 1
3006 | Nlu | nlu_analyez | years | 59.241 | 1
2006 | Speaker | TTS | hello good morning milars | 678.377 | 1
4197 | Microphone | STT | None | 15.505 | 0
4237 | Microphone | STT | still | 15.011 | 1
3007 | Nlu | nlu_analyez | still | 51.172 | 1
2007 | Speaker | TTS | hello good morning milars | 708.941 | 1
3000 | Nlu | nlu_analyez | hello | 49.057 | 1
2000 | Speaker | TTS | hello good morning milars | 732.854 | 1
3001 | Nlu | nlu_analyez | hello | 49.177 | 1
2001 | Speaker | TTS | hello good morning milars | 717.674 | 1
3002 | Nlu | nlu_analyez | hello | 52.221 | 1
2002 | Speaker | TTS | hello good morning milars | 654.988 | 1
4000 | Microphone | STT | None | 8094.031 | 0
4001 | Microphone | STT | None | 5041.018 | 0
4002 | Microphone | STT | None | 5048.181 | 0
4003 | Microphone | STT | None | 5041.467 | 0
4004 | Microphone | STT | None | 5047.246 | 0
4005 | Microphone | STT | hello | 5523.386 | 1
3000 | Nlu | nlu_analyez | hello | 59.363 | 1
2000 | Speaker | TTS | hello good morning milars | 642.726 | 1
4006 | Microphone | STT | hello | 3308.777 | 1
3001 | Nlu | nlu_analyez | hello | 51.559 | 1
2001 | Speaker | TTS | hello good morning milars | 788.704 | 1
4007 | Microphone | STT | hello | 4506.529 | 1
3002 | Nlu | nlu_analyez | hello | 65.371 | 1
2002 | Speaker | TTS | hello good morning milars | 760.328 | 1
4008 | Microphone | STT | huh | 20112.583 | 1
3003 | Nlu | nlu_analyez | huh | 66.930 | 1
2003 | Speaker | TTS | hello good morning milars | 685.107 | 1
4009 | Microphone | STT | huh | 20106.412 | 1
3004 | Nlu | nlu_analyez | huh | 61.850 | 1
2004 | Speaker | TTS | hello good morning milars | 696.042 | 1
4010 | Microphone | STT | but | 20148.123 | 1
3005 | Nlu | nlu_analyez | but | 75.807 | 1
2005 | Speaker | TTS | hello good morning milars | 731.866 | 1
4011 | Microphone | STT | None | 4930.655 | 0
4012 | Microphone | STT | None | 5045.685 | 0
4013 | Microphone | STT | hello | 12007.273 | 1
3006 | Nlu | nlu_analyez | hello | 52.187 | 1
2006 | Speaker | TTS | hello good morning milars | 741.850 | 1
4014 | Microphone | STT | hello | 2835.970 | 1
3007 | Nlu | nlu_analyez | hello | 51.939 | 1
2007 | Speaker | TTS | hello good morning milars | 723.641 | 1
4015 | Microphone | STT | hello | 1624.277 | 1
3008 | Nlu | nlu_analyez | hello | 51.647 | 1
2008 | Speaker | TTS | hello good morning milars | 718.737 | 1
4016 | Microphone | STT | hello | 1632.195 | 1
3009 | Nlu | nlu_analyez | hello | 51.730 | 1
2009 | Speaker | TTS | hello good morning milars | 649.075 | 1
4017 | Microphone | STT | hello | 1389.116 | 1
3010 | Nlu | nlu_analyez | hello | 50.809 | 1
2010 | Speaker | TTS | hello good morning milars | 682.813 | 1
4018 | Microphone | STT | hello | 1636.623 | 1
3011 | Nlu | nlu_analyez | hello | 51.302 | 1
2011 | Speaker | TTS | hello good morning milars | 676.152 | 1
4019 | Microphone | STT | hello | 1140.370 | 1
3012 | Nlu | nlu_analyez | hello | 51.557 | 1
2012 | Speaker | TTS | hello good morning milars | 909.383 | 1
4020 | Microphone | STT | hello | 1149.919 | 1
3013 | Nlu | nlu_analyez | hello | 53.331 | 1
2013 | Speaker | TTS | hello good morning milars | 1239.180 | 1
4021 | Microphone | STT | hello | 1390.661 | 1
3014 | Nlu | nlu_analyez | hello | 53.913 | 1
2014 | Speaker | TTS | hello good morning milars | 1422.190 | 1
4022 | Microphone | STT | hello commotion hello | 3308.728 | 1
3015 | Nlu | nlu_analyez | hello commotion hello | 48.392 | 0
2015 | Speaker | TTS | sorry | i didn't understand that | 1023.235 | 1
4023 | Microphone | STT | huh | 20121.252 | 1
3016 | Nlu | nlu_analyez | huh | 66.695 | 1
2016 | Speaker | TTS | hello good morning milars | 674.208 | 1
4024 | Microphone | STT | huh | 20113.110 | 1
3017 | Nlu | nlu_analyez | huh | 62.806 | 1
2017 | Speaker | TTS | hello good morning milars | 779.132 | 1
4025 | Microphone | STT | huh | 20113.371 | 1
3018 | Nlu | nlu_analyez | huh | 66.532 | 1
2018 | Speaker | TTS | hello good morning milars | 690.502 | 1
4026 | Microphone | STT | huh | 20107.421 | 1
3019 | Nlu | nlu_analyez | huh | 60.487 | 1
2019 | Speaker | TTS | hello good morning milars | 698.126 | 1
4027 | Microphone | STT | huh | 20117.035 | 1
3020 | Nlu | nlu_analyez | huh | 62.880 | 1
2020 | Speaker | TTS | hello good morning milars | 724.122 | 1
4028 | Microphone | STT | huh | 20114.193 | 1
3021 | Nlu | nlu_analyez | huh | 53.721 | 1
2021 | Speaker | TTS | hello good morning milars | 729.904 | 1
4029 | Microphone | STT | huh | 20143.061 | 1
3022 | Nlu | nlu_analyez | huh | 56.864 | 1
2022 | Speaker | TTS | hello good morning milars | 717.393 | 1
4030 | Microphone | STT | None | 4976.278 | 0
4031 | Microphone | STT | None | 5271.974 | 0
4032 | Microphone | STT | huh | 20185.938 | 1
3023 | Nlu | nlu_analyez | huh | 53.632 | 1
2023 | Speaker | TTS | hello good morning milars | 722.600 | 1
4033 | Microphone | STT | huh | 20118.624 | 1
3024 | Nlu | nlu_analyez | huh | 53.289 | 1
2024 | Speaker | TTS | hello good morning milars | 703.170 | 1
4034 | Microphone | STT | huh | 20135.021 | 1
3025 | Nlu | nlu_analyez | huh | 60.918 | 1
2025 | Speaker | TTS | hello good morning milars | 626.996 | 1
4035 | Microphone | STT | huh | 20115.984 | 1
3026 | Nlu | nlu_analyez | huh | 63.913 | 1
2026 | Speaker | TTS | hello good morning milars | 737.568 | 1
4036 | Microphone | STT | huh | 20112.549 | 1
3027 | Nlu | nlu_analyez | huh | 55.357 | 1
2027 | Speaker | TTS | hello good morning milars | 627.252 | 1
4037 | Microphone | STT | by | 20118.593 | 1
3028 | Nlu | nlu_analyez | by | 59.001 | 0
2028 | Speaker | TTS | sorry | i didn't understand that | 1200.167 | 1
4000 | Microphone | STT | None | 2.606 | 0
4001 | Microphone | STT | None | 3.645 | 0
4002 | Microphone | STT | None | 4.657 | 0
4003 | Microphone | STT | None | 3.667 | 0
4004 | Microphone | STT | None | 4.918 | 0
4005 | Microphone | STT | None | 4.783 | 0
4006 | Microphone | STT | None | 5.679 | 0
4007 | Microphone | STT | hello | 4.497 | 1
3000 | Nlu | nlu_analyez | hello | 60.275 | 1
2000 | Speaker | TTS | hello good morning milars | 705.747 | 1
4008 | Microphone | STT | oh | 2.883 | 1
3001 | Nlu | nlu_analyez | oh | 48.706 | 1
2001 | Speaker | TTS | hello good morning milars | 672.772 | 1
4009 | Microphone | STT | hello | 2.843 | 1
3002 | Nlu | nlu_analyez | hello | 55.023 | 1
2002 | Speaker | TTS | hello good morning milars | 670.076 | 1
4010 | Microphone | STT | hello | 3.342 | 1
3003 | Nlu | nlu_analyez | hello | 52.188 | 1
2003 | Speaker | TTS | hello good morning milars | 672.532 | 1
4011 | Microphone | STT | hello hello | 1.133 | 1
3004 | Nlu | nlu_analyez | hello hello | 52.051 | 1
2004 | Speaker | TTS | hello good morning milars | 723.789 | 1
4012 | Microphone | STT | hello | 7.804 | 1
3005 | Nlu | nlu_analyez | hello | 52.358 | 1
2005 | Speaker | TTS | hello good morning milars | 889.535 | 1
4013 | Microphone | STT | hello | 5.339 | 1
3006 | Nlu | nlu_analyez | hello | 48.956 | 1
2006 | Speaker | TTS | hello good morning milars | 724.689 | 1
4014 | Microphone | STT | hello | 6.014 | 1
3007 | Nlu | nlu_analyez | hello | 53.101 | 1
2007 | Speaker | TTS | hello good morning milars | 1215.969 | 1
4015 | Microphone | STT | hello hello | 1.981 | 1
3008 | Nlu | nlu_analyez | hello hello | 53.647 | 1
2008 | Speaker | TTS | hello good morning milars | 608.504 | 1
4016 | Microphone | STT | i | 1.700 | 1
3009 | Nlu | nlu_analyez | i | 48.165 | 1
2009 | Speaker | TTS | hello good morning milars | 718.905 | 1
4017 | Microphone | STT | goodbye | 5.235 | 1
3010 | Nlu | nlu_analyez | goodbye | 75.765 | 1
2010 | Speaker | TTS | good bye milars | 588.836 | 1
4018 | Microphone | STT | grew by | 2.147 | 1
3011 | Nlu | nlu_analyez | grew by | 61.732 | 0
2011 | Speaker | TTS | sorry | i didn't understand that | 1068.388 | 1
4019 | Microphone | STT | kobe | 4.250 | 1
3012 | Nlu | nlu_analyez | kobe | 48.617 | 0
2012 | Speaker | TTS | sorry | i didn't understand that | 1083.547 | 1
4020 | Microphone | STT | goodbye | 4.008 | 1
3013 | Nlu | nlu_analyez | goodbye | 52.508 | 1
2013 | Speaker | TTS | good bye milars | 498.985 | 1
4021 | Microphone | STT | good morning | 3.887 | 1
3014 | Nlu | nlu_analyez | good morning | 58.539 | 1
2014 | Speaker | TTS | hello good morning milars | 687.729 | 1
4022 | Microphone | STT | grab one | 14.330 | 1
3015 | Nlu | nlu_analyez | grab one | 1570.058 | 0
2015 | Speaker | TTS | sorry | i didn't understand that | 1403.536 | 1
4023 | Microphone | STT | good afternoon | 3.299 | 1
3016 | Nlu | nlu_analyez | good afternoon | 259.517 | 1
2016 | Speaker | TTS | good bye milars | 1591.248 | 1
4024 | Microphone | STT | good night | 2.896 | 1
3017 | Nlu | nlu_analyez | good night | 260.746 | 1
2017 | Speaker | TTS | good bye milars | 502.516 | 1
4025 | Microphone | STT | so my name | 8.999 | 1
3018 | Nlu | nlu_analyez | so my name | 62.526 | 1
2018 | Speaker | TTS | hello you are milars | 509.294 | 1
4026 | Microphone | STT | say my name | 1.579 | 1
3019 | Nlu | nlu_analyez | say my name | 52.142 | 1
2019 | Speaker | TTS | hello you are milars | 523.268 | 1
4027 | Microphone | STT | what's your name | 4.140 | 1
3020 | Nlu | nlu_analyez | what's your name | 51.489 | 1
2020 | Speaker | TTS | hello i am your robot | 802.821 | 1
4028 | Microphone | STT | None | 4.458 | 0
4029 | Microphone | STT | huh | 7.746 | 1
3021 | Nlu | nlu_analyez | huh | 63.986 | 1
2021 | Speaker | TTS | hello good morning milars | 675.524 | 1
4030 | Microphone | STT | huh | 6.932 | 1
3022 | Nlu | nlu_analyez | huh | 64.297 | 1
2022 | Speaker | TTS | hello good morning milars | 721.263 | 1
4031 | Microphone | STT | huh | 9.735 | 1
3023 | Nlu | nlu_analyez | huh | 59.885 | 1
2023 | Speaker | TTS | hello good morning milars | 663.117 | 1
4032 | Microphone | STT | huh | 9.167 | 1
3024 | Nlu | nlu_analyez | huh | 52.953 | 1
2024 | Speaker | TTS | hello good morning milars | 646.136 | 1
4033 | Microphone | STT | huh | 8.160 | 1
3025 | Nlu | nlu_analyez | huh | 63.558 | 1
2025 | Speaker | TTS | hello good morning milars | 812.925 | 1
4034 | Microphone | STT | huh | 9.078 | 1
3026 | Nlu | nlu_analyez | huh | 63.361 | 1
2026 | Speaker | TTS | hello good morning milars | 712.447 | 1
4035 | Microphone | STT | huh | 5.796 | 1
3027 | Nlu | nlu_analyez | huh | 64.719 | 1
2027 | Speaker | TTS | hello good morning milars | 673.675 | 1
4036 | Microphone | STT | huh | 7.769 | 1
3028 | Nlu | nlu_analyez | huh | 62.106 | 1
2028 | Speaker | TTS | hello good morning milars | 792.624 | 1
4037 | Microphone | STT | huh | 6.533 | 1
3029 | Nlu | nlu_analyez | huh | 59.341 | 1
2029 | Speaker | TTS | hello good morning milars | 2554.923 | 1
4038 | Microphone | STT | huh | 5.109 | 1
3030 | Nlu | nlu_analyez | huh | 50.713 | 1
2030 | Speaker | TTS | hello good morning milars | 874.424 | 1
4039 | Microphone | STT | huh | 8.048 | 1
3031 | Nlu | nlu_analyez | huh | 59.961 | 1
2031 | Speaker | TTS | hello good morning milars | 739.426 | 1
4040 | Microphone | STT | huh | 7.546 | 1
3032 | Nlu | nlu_analyez | huh | 67.668 | 1
2032 | Speaker | TTS | hello good morning milars | 687.497 | 1
4041 | Microphone | STT | huh | 7.865 | 1
3033 | Nlu | nlu_analyez | huh | 60.344 | 1
2033 | Speaker | TTS | hello good morning milars | 653.095 | 1
4042 | Microphone | STT | huh | 8.857 | 1
3034 | Nlu | nlu_analyez | huh | 61.885 | 1
2034 | Speaker | TTS | hello good morning milars | 694.750 | 1
4043 | Microphone | STT | huh | 9.242 | 1
3035 | Nlu | nlu_analyez | huh | 63.743 | 1
2035 | Speaker | TTS | hello good morning milars | 740.603 | 1
4044 | Microphone | STT | he | 9.344 | 1
3036 | Nlu | nlu_analyez | he | 54.156 | 1
2036 | Speaker | TTS | hello good morning milars | 637.534 | 1
4045 | Microphone | STT | huh | 7.625 | 1
3037 | Nlu | nlu_analyez | huh | 62.499 | 1
2037 | Speaker | TTS | hello good morning milars | 736.786 | 1
4046 | Microphone | STT | huh | 8.247 | 1
3038 | Nlu | nlu_analyez | huh | 64.846 | 1
2038 | Speaker | TTS | hello good morning milars | 700.402 | 1
4047 | Microphone | STT | huh | 8.478 | 1
3039 | Nlu | nlu_analyez | huh | 65.936 | 1
2039 | Speaker | TTS | hello good morning milars | 828.731 | 1
4048 | Microphone | STT | huh | 8.047 | 1
3040 | Nlu | nlu_analyez | huh | 63.198 | 1
2040 | Speaker | TTS | hello good morning milars | 708.564 | 1
4049 | Microphone | STT | huh | 5.456 | 1
3041 | Nlu | nlu_analyez | huh | 63.712 | 1
2041 | Speaker | TTS | hello good morning milars | 655.470 | 1
4050 | Microphone | STT | huh | 9.585 | 1
3042 | Nlu | nlu_analyez | huh | 63.937 | 1
2042 | Speaker | TTS | hello good morning milars | 677.766 | 1
4051 | Microphone | STT | huh | 6.076 | 1
3043 | Nlu | nlu_analyez | huh | 66.535 | 1
2043 | Speaker | TTS | hello good morning milars | 656.591 | 1
4052 | Microphone | STT | None | 8.463 | 0
4053 | Microphone | STT | None | 5.683 | 0
4153 | Microphone | STT | the | 22.095 | 1
3044 | Nlu | nlu_analyez | the | 48.142 | 1
2044 | Speaker | TTS | hello good morning milars | 665.665 | 1
4154 | Microphone | STT | None | 26.446 | 0
4155 | Microphone | STT | the | 14.757 | 1
3045 | Nlu | nlu_analyez | the | 52.556 | 1
2045 | Speaker | TTS | hello good morning milars | 829.984 | 1
4156 | Microphone | STT | None | 10.026 | 0
4001 | Microphone | STT | None | 4.860 | 0
2000 | Speaker | TTS | stop now | 892.524 | 1
4002 | Microphone | STT | None | 6.462 | 0
2001 | Speaker | TTS | learn motion test | 703.679 | 1
4003 | Microphone | STT | None | 5.752 | 0
4004 | Microphone | STT | None | 7.901 | 0
4005 | Microphone | STT | None | 4.073 | 0
4006 | Microphone | STT | None | 4.397 | 0
4000 | Microphone | STT | None | 2.424 | 0
2000 | Speaker | TTS | learn motion test | 1021.958 | 1
4001 | Microphone | STT | None | 5.094 | 0
4002 | Microphone | STT | None | 7.994 | 0
4003 | Microphone | STT | None | 3.865 | 0
4004 | Microphone | STT | None | 5.158 | 0
4005 | Microphone | STT | None | 11.950 | 0
4006 | Microphone | STT | None | 5.755 | 0
2001 | Speaker | TTS | i know how to test | 684.219 | 1
4007 | Microphone | STT | None | 6.449 | 0
2002 | Speaker | TTS | do motiontest | 584.404 | 1
4008 | Microphone | STT | None | 4.199 | 0
2003 | Speaker | TTS | stop now | 410.450 | 1
2004 | Speaker | TTS | stop now | 428.151 | 1
4009 | Microphone | STT | None | 9.345 | 0
2005 | Speaker | TTS | reset now | 423.178 | 1
4010 | Microphone | STT | None | 8.253 | 0
2006 | Speaker | TTS | do motiontest | 569.059 | 1
4011 | Microphone | STT | None | 8.099 | 0
4012 | Microphone | STT | None | 8.758 | 0
4013 | Microphone | STT | None | 9.597 | 0
2007 | Speaker | TTS | do motiontest | 674.165 | 1
4040 | Microphone | STT | amy | 18.485 | 1
3000 | Nlu | nlu_analyez | amy | 72.435 | 1
2008 | Speaker | TTS | hello good morning milars | 780.248 | 1
4041 | Microphone | STT | None | 15.274 | 0
4042 | Microphone | STT | None | 12.356 | 0
4043 | Microphone | STT | None | 9.630 | 0
4044 | Microphone | STT | None | 14.754 | 0
4045 | Microphone | STT | me | 26.510 | 1
3001 | Nlu | nlu_analyez | me | 2706.100 | 1
2009 | Speaker | TTS | hello good morning milars | 691.313 | 1
4046 | Microphone | STT | None | 15.251 | 0
4000 | Microphone | STT | None | 2.598 | 0
2000 | Speaker | TTS | do motiontest | 841.651 | 1
4001 | Microphone | STT | None | 3.044 | 0
4002 | Microphone | STT | None | 3.783 | 0
2001 | Speaker | TTS | do motiontest | 637.741 | 1
2002 | Speaker | TTS | stop now | 544.276 | 1
4003 | Microphone | STT | None | 14.769 | 0
2003 | Speaker | TTS | stop now | 416.901 | 1
2004 | Speaker | TTS | stop now | 381.020 | 1
4004 | Microphone | STT | are | 13.276 | 1
3000 | Nlu | nlu_analyez | are | 1572.384 | 1
2005 | Speaker | TTS | hello good morning milars | 832.765 | 1
4005 | Microphone | STT | None | 6.405 | 0
4006 | Microphone | STT | None | 8.751 | 0
4007 | Microphone | STT | None | 7.182 | 0
4008 | Microphone | STT | None | 6.850 | 0
4009 | Microphone | STT | None | 9.758 | 0
4010 | Microphone | STT | None | 5.983 | 0
4011 | Microphone | STT | None | 13.332 | 0
4012 | Microphone | STT | she was | 29.740 | 1
3001 | Nlu | nlu_analyez | she was | 65.974 | 1
2006 | Speaker | TTS | hello good morning milars | 722.058 | 1
4013 | Microphone | STT | None | 9.159 | 0
4090 | Microphone | STT | the | 16.774 | 1
3002 | Nlu | nlu_analyez | the | 64.926 | 1
2007 | Speaker | TTS | hello good morning milars | 786.539 | 1
4091 | Microphone | STT | None | 11.717 | 0
4092 | Microphone | STT | None | 10.435 | 0
4093 | Microphone | STT | stop | 20.878 | 1
3003 | Nlu | nlu_analyez | stop | 62.909 | 1
2008 | Speaker | TTS | hello good morning milars | 689.537 | 1
4094 | Microphone | STT | None | 13.406 | 0
4168 | Microphone | STT | and | 24.359 | 1
3004 | Nlu | nlu_analyez | and | 174.401 | 1
2009 | Speaker | TTS | hello good morning milars | 1169.787 | 1
4169 | Microphone | STT | None | 7.527 | 0
4170 | Microphone | STT | None | 16.532 | 0
4171 | Microphone | STT | None | 21.402 | 0
4172 | Microphone | STT | None | 11.254 | 0
4173 | Microphone | STT | None | 13.908 | 0
4174 | Microphone | STT | None | 14.532 | 0
4175 | Microphone | STT | None | 16.529 | 0
4176 | Microphone | STT | None | 10.266 | 0
4177 | Microphone | STT | None | 14.520 | 0
4178 | Microphone | STT | None | 11.040 | 0
4179 | Microphone | STT | None | 14.307 | 0
4180 | Microphone | STT | the | 23.989 | 1
3005 | Nlu | nlu_analyez | the | 69.279 | 1
2010 | Speaker | TTS | hello good morning milars | 763.268 | 1
4181 | Microphone | STT | None | 18.628 | 0
4214 | Microphone | STT | None | 25.903 | 0
2000 | Speaker | TTS | reset now | 639.332 | 1
4000 | Microphone | STT | None | 2.063 | 0
2001 | Speaker | TTS | reset now | 430.576 | 1
4001 | Microphone | STT | None | 6.933 | 0
2002 | Speaker | TTS | reset now | 434.300 | 1
4002 | Microphone | STT | None | 4.748 | 0
4003 | Microphone | STT | None | 5.045 | 0
4004 | Microphone | STT | None | 4.487 | 0
4005 | Microphone | STT | None | 6.714 | 0
4006 | Microphone | STT | yeah | 22.270 | 1
3000 | Nlu | nlu_analyez | yeah | 68.503 | 1
2003 | Speaker | TTS | hello good morning milars | 765.247 | 1
4007 | Microphone | STT | None | 12.611 | 0
4008 | Microphone | STT | None | 13.879 | 0
4009 | Microphone | STT | None | 10.292 | 0
4010 | Microphone | STT | None | 8.646 | 0
4011 | Microphone | STT | this | 9.375 | 1
3001 | Nlu | nlu_analyez | this | 60.048 | 0
2004 | Speaker | TTS | sorry | i didn't understand that | 1009.858 | 1
4012 | Microphone | STT | None | 4.478 | 0
4013 | Microphone | STT | None | 11.191 | 0
4014 | Microphone | STT | None | 9.860 | 0
4015 | Microphone | STT | None | 12.618 | 0
4016 | Microphone | STT | some bitterness | 27.431 | 1
3002 | Nlu | nlu_analyez | some bitterness | 70.638 | 1
2005 | Speaker | TTS | hello you are milars | 575.963 | 1
4017 | Microphone | STT | None | 9.050 | 0
2006 | Speaker | TTS | reset now | 443.274 | 1
4044 | Microphone | STT | None | 12.180 | 0
4045 | Microphone | STT | None | 14.690 | 0
4046 | Microphone | STT | None | 16.206 | 0
4047 | Microphone | STT | None | 15.733 | 0
4048 | Microphone | STT | None | 14.707 | 0
2007 | Speaker | TTS | reset now | 473.227 | 1
4127 | Microphone | STT | for | 19.160 | 1
3003 | Nlu | nlu_analyez | for | 7062.549 | 0
2008 | Speaker | TTS | sorry | i didn't understand that | 1665.701 | 1
4318 | Microphone | STT | None | 7.024 | 0
4319 | Microphone | STT | maggie | 32.214 | 1
3004 | Nlu | nlu_analyez | maggie | 65.494 | 1
2009 | Speaker | TTS | hello good morning milars | 764.656 | 1
4434 | Microphone | STT | hello | 7.956 | 1
3005 | Nlu | nlu_analyez | hello | 76.260 | 1
2010 | Speaker | TTS | hello good morning milars | 751.693 | 1
4435 | Microphone | STT | None | 14.821 | 0
4436 | Microphone | STT | None | 11.568 | 0
4437 | Microphone | STT | None | 7.773 | 0
4438 | Microphone | STT | None | 16.211 | 0
4439 | Microphone | STT | None | 8.649 | 0
4440 | Microphone | STT | that's right before | 27.601 | 1
3006 | Nlu | nlu_analyez | that's right before | 67.832 | 0
2011 | Speaker | TTS | sorry | i didn't understand that | 1129.419 | 1
4441 | Microphone | STT | None | 14.667 | 0
4533 | Microphone | STT | None | 9.436 | 0
4534 | Microphone | STT | yeah | 24.707 | 1
3007 | Nlu | nlu_analyez | yeah | 1034.452 | 1
2012 | Speaker | TTS | hello good morning milars | 1045.983 | 1
4603 | Microphone | STT | oh | 5.986 | 1
3008 | Nlu | nlu_analyez | oh | 210.361 | 1
2013 | Speaker | TTS | hello good morning milars | 827.722 | 1
4604 | Microphone | STT | None | 4.031 | 0
4674 | Microphone | STT | guy | 26.797 | 1
3009 | Nlu | nlu_analyez | guy | 81.106 | 1
2014 | Speaker | TTS | hello good morning milars | 832.024 | 1
4675 | Microphone | STT | None | 17.083 | 0
4676 | Microphone | STT | None | 14.163 | 0
4677 | Microphone | STT | None | 12.454 | 0
4678 | Microphone | STT | None | 15.033 | 0
4679 | Microphone | STT | None | 13.553 | 0
4680 | Microphone | STT | None | 17.252 | 0
4681 | Microphone | STT | None | 16.965 | 0
4682 | Microphone | STT | man | 25.939 | 1
3010 | Nlu | nlu_analyez | man | 378.990 | 1
2015 | Speaker | TTS | hello good morning milars | 765.971 | 1
4683 | Microphone | STT | None | 18.139 | 0
4684 | Microphone | STT | None | 15.408 | 0
4685 | Microphone | STT | None | 25.234 | 0
4686 | Microphone | STT | None | 15.743 | 0
4687 | Microphone | STT | None | 22.846 | 0
4688 | Microphone | STT | yeah | 30.478 | 1
3011 | Nlu | nlu_analyez | yeah | 2787.006 | 1
2016 | Speaker | TTS | hello good morning milars | 1894.486 | 1
4689 | Microphone | STT | None | 17.932 | 0
4690 | Microphone | STT | None | 18.680 | 0
4691 | Microphone | STT | None | 18.933 | 0
4692 | Microphone | STT | None | 24.328 | 0
4693 | Microphone | STT | None | 27.280 | 0
4694 | Microphone | STT | None | 15.786 | 0
4695 | Microphone | STT | None | 8.681 | 0
4696 | Microphone | STT | None | 13.903 | 0
4697 | Microphone | STT | None | 23.464 | 0
4698 | Microphone | STT | None | 20.690 | 0
4699 | Microphone | STT | None | 21.351 | 0
4700 | Microphone | STT | None | 20.326 | 0
4701 | Microphone | STT | None | 29.211 | 0
4702 | Microphone | STT | None | 19.062 | 0
4703 | Microphone | STT | None | 18.605 | 0
4704 | Microphone | STT | yes | 24.972 | 1
3012 | Nlu | nlu_analyez | yes | 61.737 | 1
2017 | Speaker | TTS | hello good morning milars | 679.751 | 1
3013 | Nlu | nlu_analyez | me | 62.430 | 1
2018 | Speaker | TTS | hello good morning milars | 760.571 | 1
3014 | Nlu | nlu_analyez | ever | 70.703 | 1
2019 | Speaker | TTS | hello good morning milars | 1312.868 | 1
4820 | Microphone | STT | you in system | 48.336 | 1
3015 | Nlu | nlu_analyez | you in system | 62.875 | 0
2020 | Speaker | TTS | sorry | i didn't understand that | 1364.233 | 1
3000 | Nlu | nlu_analyez | yeah | 49.132 | 1
2000 | Speaker | TTS | hello good morning milars | 1035.744 | 1
4007 | Microphone | STT | None | 9.624 | 0
4008 | Microphone | STT | None | 7.158 | 0
4009 | Microphone | STT | None | 7.735 | 0
4010 | Microphone | STT | None | 6.601 | 0
4011 | Microphone | STT | None | 12.977 | 0
4000 | Microphone | STT | None | 2.221 | 0
4001 | Microphone | STT | None | 4.222 | 0
4002 | Microphone | STT | None | 3.664 | 0
4003 | Microphone | STT | None | 7.731 | 0
4004 | Microphone | STT | None | 6.392 | 0
4005 | Microphone | STT | None | 9.723 | 0
4006 | Microphone | STT | None | 8.210 | 0
4007 | Microphone | STT | None | 8.068 | 0
4008 | Microphone | STT | None | 4.879 | 0
4000 | Microphone | STT | None | 2.467 | 0
0 | Screen-Motion | DO_MOTION | left_l | 65.971 | 0
1 | Screen-Motion | DO_MOTION | left_r | 62.136 | 0
2 | Screen-Motion | DO_MOTION | left_r | 65.816 | 0
4001 | Microphone | STT | None | 7.612 | 0
3 | Screen-Motion | DO_MOTION | left_r | 72.281 | 0
4 | Screen-Motion | DO_MOTION | left_r | 62.380 | 0
5 | Screen-Motion | DO_MOTION | left_r | 67.374 | 0
6 | Screen-Motion | DO_MOTION | left_u | 64.721 | 0
4002 | Microphone | STT | None | 6.314 | 0
7 | Screen-Motion | DO_MOTION | left_u | 62.033 | 0
8 | Screen-Motion | DO_MOTION | left_d | 62.199 | 0
9 | Screen-Motion | DO_MOTION | left_l | 66.491 | 0
10 | Screen-Motion | DO_MOTION | left_l | 62.067 | 0
4003 | Microphone | STT | None | 5.475 | 0
11 | Screen-Motion | DO_MOTION | left_r | 69.358 | 0
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
4049 | Microphone | STT | it's | 16.284 | 1
3003 | Nlu | nlu_analyez | it's | 62.055 | 0
110 | Screen-Motion | DO_MOTION | left_r | 62.068 | 0
111 | Screen-Motion | DO_MOTION | left_r | 64.025 | 0
112 | Screen-Motion | DO_MOTION | left_r | 62.208 | 0
2007 | Speaker | TTS | sorry | i didn't understand that | 1314.210 | 1
113 | Screen-Motion | DO_MOTION | left_l | 65.438 | 0
114 | Screen-Motion | DO_MOTION | left_l | 65.243 | 0
115 | Screen-Motion | DO_MOTION | left_l | 66.246 | 0
116 | Screen-Motion | DO_MOTION | left_l | 66.914 | 0
117 | Screen-Motion | DO_MOTION | left_l | 62.048 | 0
118 | Screen-Motion | DO_MOTION | left_l | 65.667 | 0
119 | Screen-Motion | DO_MOTION | left_l | 70.260 | 0
120 | Screen-Motion | DO_MOTION | left_l | 67.693 | 0
121 | Screen-Motion | DO_MOTION | left_l | 62.069 | 0
122 | Screen-Motion | DO_MOTION | left_l | 64.393 | 0
123 | Screen-Motion | DO_MOTION | left_l | 64.764 | 0
4050 | Microphone | STT | trust | 13.780 | 1
124 | Screen-Motion | DO_MOTION | left_l | 70.066 | 0
3004 | Nlu | nlu_analyez | trust | 60.975 | 0
125 | Screen-Motion | DO_MOTION | left_l | 62.236 | 0
126 | Screen-Motion | DO_MOTION | left_l | 62.159 | 0
127 | Screen-Motion | DO_MOTION | left_l | 66.420 | 0
128 | Screen-Motion | DO_MOTION | left_l | 65.992 | 0
2008 | Speaker | TTS | sorry | i didn't understand that | 1245.107 | 1
4051 | Microphone | STT | sorry i didn't understand | 4.503 | 1
3005 | Nlu | nlu_analyez | sorry i didn't understand | 58.478 | 0
2009 | Speaker | TTS | sorry | i didn't understand that | 1144.525 | 1
4052 | Microphone | STT | i do | 16.736 | 1
3006 | Nlu | nlu_analyez | i do | 52.344 | 0
2010 | Speaker | TTS | reset now | 2725.462 | 1
2011 | Speaker | TTS | sorry | i didn't understand that | 1203.254 | 1
3000 | Nlu | nlu_analyez | game | 63.064 | 0
2000 | Speaker | TTS | sorry | i didn't understand that | 1076.363 | 1
4021 | Microphone | STT | i did | 16.257 | 1
3001 | Nlu | nlu_analyez | i did | 54.252 | 1
2001 | Speaker | TTS | hello good morning milars | 910.235 | 1
4022 | Microphone | STT | yeah | 25.650 | 1
3002 | Nlu | nlu_analyez | yeah | 61.233 | 1
2002 | Speaker | TTS | hello good morning milars | 685.332 | 1
4023 | Microphone | STT | good morning | 15.276 | 1
3003 | Nlu | nlu_analyez | good morning | 53.732 | 1
2003 | Speaker | TTS | hello good morning milars | 743.860 | 1
4024 | Microphone | STT | None | 22.414 | 0
4025 | Microphone | STT | None | 19.286 | 0
4026 | Microphone | STT | None | 16.364 | 0
4027 | Microphone | STT | None | 7.276 | 0
4028 | Microphone | STT | he | 10.731 | 1
3004 | Nlu | nlu_analyez | he | 62.073 | 1
2004 | Speaker | TTS | hello good morning milars | 636.496 | 1
4029 | Microphone | STT | None | 15.418 | 0
4030 | Microphone | STT | None | 8.469 | 0
4031 | Microphone | STT | None | 15.717 | 0
4032 | Microphone | STT | None | 10.999 | 0
0 | Screen-Motion | DO_MOTION | left_u | 67.069 | 0
1 | Screen-Motion | DO_MOTION | left_u | 62.093 | 0
2 | Screen-Motion | DO_MOTION | left_u | 71.148 | 0
3 | Screen-Motion | DO_MOTION | left_u | 64.002 | 0
4 | Screen-Motion | DO_MOTION | left_u | 62.129 | 0
5 | Screen-Motion | DO_MOTION | left_u | 63.348 | 0
6 | Screen-Motion | DO_MOTION | left_u | 62.400 | 0
7 | Screen-Motion | DO_MOTION | left_u | 66.648 | 0
8 | Screen-Motion | DO_MOTION | left_u | 62.805 | 0
9 | Screen-Motion | DO_MOTION | left_u | 62.126 | 0
4033 | Microphone | STT | None | 11.767 | 0
10 | Screen-Motion | DO_MOTION | right_d | 62.102 | 0
11 | Screen-Motion | DO_MOTION | right_d | 62.036 | 0
12 | Screen-Motion | DO_MOTION | right_d | 64.429 | 0
13 | Screen-Motion | DO_MOTION | right_d | 64.437 | 0
14 | Screen-Motion | DO_MOTION | right_d | 69.136 | 0
15 | Screen-Motion | DO_MOTION | right_d | 62.044 | 0
16 | Screen-Motion | DO_MOTION | right_d | 67.333 | 0
17 | Screen-Motion | DO_MOTION | right_d | 62.120 | 0
4034 | Microphone | STT | None | 17.144 | 0
18 | Screen-Motion | DO_MOTION | right_d | 62.022 | 0
19 | Screen-Motion | DO_MOTION | right_d | 68.655 | 0
20 | Screen-Motion | DO_MOTION | right_d | 64.140 | 0
21 | Screen-Motion | DO_MOTION | right_d | 64.729 | 0
22 | Screen-Motion | DO_MOTION | left_d | 67.134 | 0
4035 | Microphone | STT | None | 11.459 | 0
23 | Screen-Motion | DO_MOTION | left_u | 62.037 | 0
24 | Screen-Motion | DO_MOTION | left_u | 62.037 | 0
25 | Screen-Motion | DO_MOTION | left_u | 62.039 | 0
26 | Screen-Motion | DO_MOTION | left_u | 62.081 | 0
4036 | Microphone | STT | None | 7.249 | 0
4037 | Microphone | STT | None | 14.397 | 0
4038 | Microphone | STT | None | 14.997 | 0
4039 | Microphone | STT | base | 6.506 | 1
3005 | Nlu | nlu_analyez | base | 71.523 | 1
2005 | Speaker | TTS | hello good morning milars | 681.429 | 1
4040 | Microphone | STT | None | 10.379 | 0
4041 | Microphone | STT | phase right | 7.191 | 1
3006 | Nlu | nlu_analyez | phase right | 62.996 | 1
2006 | Speaker | TTS | hello you are milars | 510.570 | 1
4042 | Microphone | STT | None | 9.181 | 0
4043 | Microphone | STT | None | 15.404 | 0
4044 | Microphone | STT | None | 15.415 | 0
2007 | Speaker | TTS | reset now | 428.512 | 1
4045 | Microphone | STT | so | 8.714 | 1
3007 | Nlu | nlu_analyez | so | 76.332 | 1
2008 | Speaker | TTS | hello good morning milars | 689.417 | 1
4046 | Microphone | STT | since | 7.683 | 1
3008 | Nlu | nlu_analyez | since | 56.801 | 1
2009 | Speaker | TTS | hello good morning milars | 708.338 | 1
4047 | Microphone | STT | None | 10.884 | 0
4048 | Microphone | STT | None | 9.834 | 0
4049 | Microphone | STT | None | 8.165 | 0
4050 | Microphone | STT | but | 22.938 | 1
3009 | Nlu | nlu_analyez | but | 59.992 | 1
2010 | Speaker | TTS | hello good morning milars | 629.343 | 1
4051 | Microphone | STT | None | 12.229 | 0
27 | Screen-Motion | DO_MOTION | left_l | 62.044 | 0
28 | Screen-Motion | DO_MOTION | left_r | 66.261 | 0
29 | Screen-Motion | DO_MOTION | left_r | 65.741 | 0
4052 | Microphone | STT | None | 10.133 | 0
4053 | Microphone | STT | None | 16.506 | 0
4054 | Microphone | STT | None | 13.344 | 0
4055 | Microphone | STT | None | 17.731 | 0
2011 | Speaker | TTS | reset now | 403.741 | 1
30 | Screen-Motion | DO_MOTION | left_l | 64.064 | 0
31 | Screen-Motion | DO_MOTION | left_l | 62.079 | 0
32 | Screen-Motion | DO_MOTION | left_l | 62.073 | 0
33 | Screen-Motion | DO_MOTION | left_r | 62.013 | 0
34 | Screen-Motion | DO_MOTION | left_r | 62.077 | 0
35 | Screen-Motion | DO_MOTION | left_r | 62.079 | 0
36 | Screen-Motion | DO_MOTION | left_r | 62.068 | 0
37 | Screen-Motion | DO_MOTION | left_r | 62.038 | 0
38 | Screen-Motion | DO_MOTION | left_r | 62.530 | 0
39 | Screen-Motion | DO_MOTION | left_r | 62.067 | 0
40 | Screen-Motion | DO_MOTION | left_r | 62.067 | 0
41 | Screen-Motion | DO_MOTION | left_r | 62.070 | 0
42 | Screen-Motion | DO_MOTION | left_r | 63.203 | 0
43 | Screen-Motion | DO_MOTION | left_r | 62.083 | 0
4074 | Microphone | STT | None | 15.773 | 0
44 | Screen-Motion | DO_MOTION | left_r | 62.182 | 0
45 | Screen-Motion | DO_MOTION | left_r | 64.744 | 0
46 | Screen-Motion | DO_MOTION | left_r | 62.161 | 0
47 | Screen-Motion | DO_MOTION | left_r | 70.393 | 0
48 | Screen-Motion | DO_MOTION | left_l | 64.446 | 0
49 | Screen-Motion | DO_MOTION | left_l | 65.828 | 0
50 | Screen-Motion | DO_MOTION | left_l | 62.059 | 0
51 | Screen-Motion | DO_MOTION | left_l | 67.332 | 0
52 | Screen-Motion | DO_MOTION | left_l | 62.083 | 0
4075 | Microphone | STT | just | 11.365 | 1
3010 | Nlu | nlu_analyez | just | 49.440 | 1
2012 | Speaker | TTS | hello good morning milars | 723.907 | 1
53 | Screen-Motion | DO_MOTION | left_r | 66.081 | 0
54 | Screen-Motion | DO_MOTION | left_r | 62.023 | 0
55 | Screen-Motion | DO_MOTION | left_l | 62.161 | 0
56 | Screen-Motion | DO_MOTION | left_l | 62.035 | 0
2013 | Speaker | TTS | reset now | 1936.037 | 1
57 | Screen-Motion | DO_MOTION | left_l | 64.278 | 0
58 | Screen-Motion | DO_MOTION | left_l | 67.778 | 0
59 | Screen-Motion | DO_MOTION | left_r | 66.299 | 0
60 | Screen-Motion | DO_MOTION | left_r | 63.206 | 0
4076 | Microphone | STT | which is among the was | 33.125 | 1
3011 | Nlu | nlu_analyez | which is among the was | 60.148 | 1
4000 | Microphone | STT | None | 2.844 | 0
4001 | Microphone | STT | None | 2.702 | 0
4002 | Microphone | STT | None | 4.248 | 0
0 | Screen-Motion | DO_MOTION | left_r | 71.830 | 0
1 | Screen-Motion | DO_MOTION | left_r | 65.237 | 0
2 | Screen-Motion | DO_MOTION | left_r | 62.044 | 0
3 | Screen-Motion | DO_MOTION | left_l | 69.980 | 0
4 | Screen-Motion | DO_MOTION | left_l | 62.050 | 0
5 | Screen-Motion | DO_MOTION | left_l | 62.024 | 0
6 | Screen-Motion | DO_MOTION | left_u | 69.300 | 0
7 | Screen-Motion | DO_MOTION | left_u | 62.105 | 0
8 | Screen-Motion | DO_MOTION | left_u | 62.066 | 0
9 | Screen-Motion | DO_MOTION | left_u | 66.026 | 0
4003 | Microphone | STT | None | 3.783 | 0
10 | Screen-Motion | DO_MOTION | left_d | 62.078 | 0
11 | Screen-Motion | DO_MOTION | left_d | 62.111 | 0
12 | Screen-Motion | DO_MOTION | left_d | 62.086 | 0
13 | Screen-Motion | DO_MOTION | left_d | 62.158 | 0
14 | Screen-Motion | DO_MOTION | right_l | 62.078 | 0
15 | Screen-Motion | DO_MOTION | right_l | 62.048 | 0
16 | Screen-Motion | DO_MOTION | right_r | 62.047 | 0
17 | Screen-Motion | DO_MOTION | right_r | 62.153 | 0
18 | Screen-Motion | DO_MOTION | right_r | 62.057 | 0
19 | Screen-Motion | DO_MOTION | right_r | 62.099 | 0
20 | Screen-Motion | DO_MOTION | right_r | 62.090 | 0
21 | Screen-Motion | DO_MOTION | right_r | 62.042 | 0
22 | Screen-Motion | DO_MOTION | right_r | 62.037 | 0
23 | Screen-Motion | DO_MOTION | right_r | 62.067 | 0
24 | Screen-Motion | DO_MOTION | right_r | 62.048 | 0
25 | Screen-Motion | DO_MOTION | right_r | 62.015 | 0
26 | Screen-Motion | DO_MOTION | right_r | 63.058 | 0
4004 | Microphone | STT | None | 5.658 | 0
2000 | Speaker | TTS | reset now | 434.324 | 1
27 | Screen-Motion | DO_MOTION | right_u | 62.849 | 0
4005 | Microphone | STT | he said | 11.718 | 1
3000 | Nlu | nlu_analyez | he said | 49.912 | 1
28 | Screen-Motion | DO_MOTION | right_u | 62.143 | 0
29 | Screen-Motion | DO_MOTION | right_u | 62.763 | 0
30 | Screen-Motion | DO_MOTION | right_u | 62.161 | 0
31 | Screen-Motion | DO_MOTION | right_u | 63.634 | 0
32 | Screen-Motion | DO_MOTION | right_u | 62.102 | 0
2001 | Speaker | TTS | hello good morning milars | 687.322 | 1
33 | Screen-Motion | DO_MOTION | right_d | 62.214 | 0
34 | Screen-Motion | DO_MOTION | right_d | 62.118 | 0
35 | Screen-Motion | DO_MOTION | right_d | 62.525 | 0
36 | Screen-Motion | DO_MOTION | right_d | 62.073 | 0
37 | Screen-Motion | DO_MOTION | right_d | 62.163 | 0
38 | Screen-Motion | DO_MOTION | right_d | 62.093 | 0
39 | Screen-Motion | DO_MOTION | right_u | 62.010 | 0
40 | Screen-Motion | DO_MOTION | right_u | 71.836 | 0
41 | Screen-Motion | DO_MOTION | right_u | 64.467 | 0
42 | Screen-Motion | DO_MOTION | right_u | 68.140 | 0
43 | Screen-Motion | DO_MOTION | right_u | 68.748 | 0
44 | Screen-Motion | DO_MOTION | right_u | 62.110 | 0
4006 | Microphone | STT | hello | 25.735 | 1
3001 | Nlu | nlu_analyez | hello | 112.668 | 1
2002 | Speaker | TTS | reset now | 523.501 | 1
2003 | Speaker | TTS | hello good morning milars | 934.290 | 1
45 | Screen-Motion | DO_MOTION | left_r | 67.911 | 0
46 | Screen-Motion | DO_MOTION | left_r | 62.068 | 0
47 | Screen-Motion | DO_MOTION | left_r | 62.044 | 0
48 | Screen-Motion | DO_MOTION | left_l | 66.871 | 0
49 | Screen-Motion | DO_MOTION | left_l | 64.241 | 0
50 | Screen-Motion | DO_MOTION | left_l | 62.366 | 0
2004 | Speaker | TTS | reset now | 2330.531 | 1
4007 | Microphone | STT | motions | 17.373 | 1
3002 | Nlu | nlu_analyez | motions | 56.855 | 0
2005 | Speaker | TTS | sorry | i didn't understand that | 1250.385 | 1
51 | Screen-Motion | DO_MOTION | left_u | 62.140 | 0
52 | Screen-Motion | DO_MOTION | left_u | 62.050 | 0
53 | Screen-Motion | DO_MOTION | left_d | 64.468 | 0
54 | Screen-Motion | DO_MOTION | left_d | 64.936 | 0
2006 | Speaker | TTS | reset now | 3090.577 | 1
4008 | Microphone | STT | much money | 41.682 | 1
3003 | Nlu | nlu_analyez | much money | 58.137 | 1
0 | Screen-Motion | DO_MOTION | left_l | 62.141 | 0
1 | Screen-Motion | DO_MOTION | left_l | 62.076 | 0
2 | Screen-Motion | DO_MOTION | left_l | 62.190 | 0
3 | Screen-Motion | DO_MOTION | left_l | 63.118 | 0
4 | Screen-Motion | DO_MOTION | left_r | 62.100 | 0
5 | Screen-Motion | DO_MOTION | left_r | 62.327 | 0
4000 | Microphone | STT | None | 2.605 | 0
6 | Screen-Motion | DO_MOTION | left_r | 63.016 | 0
7 | Screen-Motion | DO_MOTION | left_r | 62.053 | 0
8 | Screen-Motion | DO_MOTION | left_r | 62.061 | 0
9 | Screen-Motion | DO_MOTION | left_l | 62.085 | 0
10 | Screen-Motion | DO_MOTION | left_l | 62.145 | 0
11 | Screen-Motion | DO_MOTION | left_l | 62.170 | 0
12 | Screen-Motion | DO_MOTION | left_l | 62.075 | 0
13 | Screen-Motion | DO_MOTION | left_l | 62.197 | 0
14 | Screen-Motion | DO_MOTION | right_l | 63.544 | 0
15 | Screen-Motion | DO_MOTION | right_l | 62.120 | 0
16 | Screen-Motion | DO_MOTION | right_l | 62.118 | 0
17 | Screen-Motion | DO_MOTION | right_r | 62.087 | 0
18 | Screen-Motion | DO_MOTION | right_r | 62.049 | 0
19 | Screen-Motion | DO_MOTION | right_r | 62.226 | 0
20 | Screen-Motion | DO_MOTION | right_u | 62.055 | 0
21 | Screen-Motion | DO_MOTION | right_r | 62.522 | 0
22 | Screen-Motion | DO_MOTION | right_r | 62.177 | 0
23 | Screen-Motion | DO_MOTION | right_r | 64.735 | 0
24 | Screen-Motion | DO_MOTION | right_r | 69.878 | 0
25 | Screen-Motion | DO_MOTION | right_r | 64.338 | 0
4001 | Microphone | STT | None | 7.321 | 0
26 | Screen-Motion | DO_MOTION | right_d | 65.570 | 0
27 | Screen-Motion | DO_MOTION | right_d | 65.178 | 0
28 | Screen-Motion | DO_MOTION | right_d | 67.930 | 0
29 | Screen-Motion | DO_MOTION | right_d | 62.026 | 0
30 | Screen-Motion | DO_MOTION | right_d | 62.034 | 0
31 | Screen-Motion | DO_MOTION | right_d | 63.932 | 0
32 | Screen-Motion | DO_MOTION | right_d | 64.216 | 0
2000 | Speaker | TTS | reset now | 449.663 | 1
33 | Screen-Motion | DO_MOTION | right_r | 62.009 | 0
34 | Screen-Motion | DO_MOTION | right_r | 62.075 | 0
35 | Screen-Motion | DO_MOTION | right_r | 62.031 | 0
36 | Screen-Motion | DO_MOTION | right_r | 62.048 | 0
37 | Screen-Motion | DO_MOTION | right_r | 62.019 | 0
38 | Screen-Motion | DO_MOTION | right_d | 62.022 | 0
39 | Screen-Motion | DO_MOTION | right_d | 62.051 | 0
40 | Screen-Motion | DO_MOTION | right_d | 62.359 | 0
41 | Screen-Motion | DO_MOTION | right_d | 63.089 | 0
42 | Screen-Motion | DO_MOTION | right_d | 62.050 | 0
43 | Screen-Motion | DO_MOTION | right_d | 62.119 | 0
44 | Screen-Motion | DO_MOTION | right_d | 62.048 | 0
4002 | Microphone | STT | None | 5.722 | 0
45 | Screen-Motion | DO_MOTION | right_d | 62.446 | 0
46 | Screen-Motion | DO_MOTION | right_d | 62.353 | 0
47 | Screen-Motion | DO_MOTION | left_u | 62.345 | 0
48 | Screen-Motion | DO_MOTION | left_u | 62.069 | 0
49 | Screen-Motion | DO_MOTION | left_u | 62.083 | 0
50 | Screen-Motion | DO_MOTION | left_u | 69.350 | 0
51 | Screen-Motion | DO_MOTION | left_u | 66.316 | 0
52 | Screen-Motion | DO_MOTION | left_u | 67.524 | 0
53 | Screen-Motion | DO_MOTION | left_u | 72.518 | 0
54 | Screen-Motion | DO_MOTION | left_u | 65.895 | 0
55 | Screen-Motion | DO_MOTION | left_u | 63.275 | 0
56 | Screen-Motion | DO_MOTION | left_u | 62.089 | 0
57 | Screen-Motion | DO_MOTION | left_u | 66.835 | 0
58 | Screen-Motion | DO_MOTION | left_u | 62.063 | 0
59 | Screen-Motion | DO_MOTION | left_u | 69.962 | 0
60 | Screen-Motion | DO_MOTION | left_u | 62.075 | 0
61 | Screen-Motion | DO_MOTION | left_u | 64.821 | 0
62 | Screen-Motion | DO_MOTION | left_u | 62.044 | 0
63 | Screen-Motion | DO_MOTION | left_u | 62.107 | 0
64 | Screen-Motion | DO_MOTION | left_l | 63.496 | 0
65 | Screen-Motion | DO_MOTION | left_l | 62.089 | 0
66 | Screen-Motion | DO_MOTION | left_l | 62.113 | 0
67 | Screen-Motion | DO_MOTION | left_l | 62.085 | 0
4003 | Microphone | STT | None | 12.927 | 0
68 | Screen-Motion | DO_MOTION | left_r | 62.204 | 0
69 | Screen-Motion | DO_MOTION | left_r | 62.108 | 0
70 | Screen-Motion | DO_MOTION | left_r | 62.120 | 0
71 | Screen-Motion | DO_MOTION | left_r | 62.134 | 0
72 | Screen-Motion | DO_MOTION | left_r | 62.066 | 0
73 | Screen-Motion | DO_MOTION | left_r | 62.119 | 0
74 | Screen-Motion | DO_MOTION | left_r | 62.031 | 0
75 | Screen-Motion | DO_MOTION | left_r | 62.080 | 0
2001 | Speaker | TTS | reset now | 414.209 | 1
3000 | Nlu | nlu_analyez | that | 67.142 | 1
2000 | Speaker | TTS | hello good morning milars | 1096.904 | 1
4224 | Microphone | STT | None | 29.898 | 0
4225 | Microphone | STT | hello the man | 22.839 | 1
3001 | Nlu | nlu_analyez | hello the man | 74.170 | 1
2001 | Speaker | TTS | hello good morning milars | 824.552 | 1
4226 | Microphone | STT | the by | 21.275 | 1
3002 | Nlu | nlu_analyez | the by | 62.733 | 0
2002 | Speaker | TTS | sorry | i didn't understand that | 1267.964 | 1
4227 | Microphone | STT | None | 25.558 | 0
4228 | Microphone | STT | i mean it's too late goodbye | 24.045 | 1
3003 | Nlu | nlu_analyez | i mean it's too late goodbye | 76.691 | 0
2003 | Speaker | TTS | sorry | i didn't understand that | 1274.995 | 1
4229 | Microphone | STT | some random shootings | 36.795 | 1
3004 | Nlu | nlu_analyez | some random shootings | 68.148 | 1
4230 | Microphone | STT | for once | 34.100 | 1
4231 | Microphone | STT | None | 13.863 | 0
4232 | Microphone | STT | it | 29.484 | 1
0 | Screen-Motion | DO_MOTION | left_l | 62.201 | 0
1 | Screen-Motion | DO_MOTION | left_l | 62.100 | 0
2 | Screen-Motion | DO_MOTION | left_r | 62.161 | 0
3 | Screen-Motion | DO_MOTION | left_r | 62.137 | 0
4 | Screen-Motion | DO_MOTION | left_u | 62.183 | 0
5 | Screen-Motion | DO_MOTION | left_u | 62.033 | 0
6 | Screen-Motion | DO_MOTION | left_d | 62.100 | 0
7 | Screen-Motion | DO_MOTION | left_d | 62.036 | 0
4829 | Microphone | STT | None | 13.551 | 0
4830 | Microphone | STT | None | 5.531 | 0
4831 | Microphone | STT | None | 7.926 | 0
8 | Screen-Motion | DO_MOTION | left_l | 65.522 | 0
9 | Screen-Motion | DO_MOTION | left_l | 68.970 | 0
10 | Screen-Motion | DO_MOTION | left_r | 64.040 | 0
11 | Screen-Motion | DO_MOTION | left_r | 68.753 | 0
12 | Screen-Motion | DO_MOTION | left_u | 64.496 | 0
13 | Screen-Motion | DO_MOTION | left_u | 69.373 | 0
14 | Screen-Motion | DO_MOTION | left_d | 62.027 | 0
15 | Screen-Motion | DO_MOTION | left_d | 67.677 | 0
4832 | Microphone | STT | None | 12.296 | 0
2004 | Speaker | TTS | reset now | 409.496 | 1
2005 | Speaker | TTS | reset now | 657.445 | 1
16 | Screen-Motion | DO_MOTION | right_u | 66.548 | 0
17 | Screen-Motion | DO_MOTION | right_u | 62.135 | 0
18 | Screen-Motion | DO_MOTION | right_d | 62.167 | 0
19 | Screen-Motion | DO_MOTION | right_d | 62.060 | 0
20 | Screen-Motion | DO_MOTION | right_d | 62.187 | 0
4833 | Microphone | STT | None | 24.289 | 0
21 | Screen-Motion | DO_MOTION | right_d | 62.044 | 0
22 | Screen-Motion | DO_MOTION | right_d | 62.110 | 0
23 | Screen-Motion | DO_MOTION | right_d | 62.083 | 0
24 | Screen-Motion | DO_MOTION | right_d | 62.125 | 0
25 | Screen-Motion | DO_MOTION | right_d | 62.065 | 0
26 | Screen-Motion | DO_MOTION | right_d | 62.053 | 0
27 | Screen-Motion | DO_MOTION | right_l | 68.462 | 0
28 | Screen-Motion | DO_MOTION | right_l | 63.453 | 0
29 | Screen-Motion | DO_MOTION | right_l | 64.098 | 0
4834 | Microphone | STT | None | 15.993 | 0
30 | Screen-Motion | DO_MOTION | right_r | 64.089 | 0
31 | Screen-Motion | DO_MOTION | right_r | 62.032 | 0
32 | Screen-Motion | DO_MOTION | right_r | 70.109 | 0
33 | Screen-Motion | DO_MOTION | right_r | 62.036 | 0
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
106 | Screen-Motion | DO_MOTION | right_r | 65.196 | 0
107 | Screen-Motion | DO_MOTION | right_r | 62.041 | 0
108 | Screen-Motion | DO_MOTION | right_r | 66.352 | 0
109 | Screen-Motion | DO_MOTION | right_r | 64.451 | 0
110 | Screen-Motion | DO_MOTION | right_r | 63.980 | 0
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
