milars-z/Real-Time-Embedded-Programming/include/common/camera_config.txt

# Camera Intrinsic Parameters
fx=500;
fy=500;
cx=320;
cy=240;

# Extrinsic Parameters: Translation (mm)
tx=10;
ty=0;
tz=150;

# Extrinsic Parameters: Rotation (degrees, Roll-Pitch-Yaw)
roll=0;
pitch=0;
yaw=0;

# Safety Boundaries (mm)
max_reach=450.0
min_z_height=10.0
