milars-z/Real-Time-Embedded-Programming/(commit log)

2026-01-28 add pitch presentation slide
2026-01-30 (MotorTest) Add: use EventDrive to control MG90S motor
2026-01-31 (CameraTest) add: use EventDrive to control camera
2026-01-31 (CameraTest) del: del some document from other branch
2026-02-04 change license to GPL
    [hardware.xlsx]
2026-02-15 add for first stage media
2026-02-22 (CameraTest)[ADD]add lightweight image feature detection algorithm
2026-02-22 CameraTest[ADD]:Add archive backup files
2026-02-25 (CameraTest)[add]:add function to claculate the inference and match time [modify]:modify the threshold of match (because L2 to cosine)
2026-02-25 (CameraTest)[modify]:Changed the language of the comments
2026-02-25 (CameraTest)[Modity]:change the compute_distance logic(L2 to cosine)
2026-02-25 (CameraTest)[fix]:Fixed the issue of compilation failure(previous version caused)
2026-02-25 (Cameratest)[modify]:Added ignored folder: model
2026-03-11 add README for 3D printing documentation
2026-04-02 [modify] update version log
    [overall.xlsx]
2026-04-02 update project files
    [overall.xlsx]
2026-04-04 feat: complete coordinate transformation with dynamic config and safety bounds
    [camera_config.txt]
2026-04-09 [modify] edit some detail for overall project
    [overall.xlsx]
2026-04-09 add details for version update
    [overall.xlsx]
2026-04-13 [refactor] migrate to layered architecture (see README) merge from integration to main
    [servo_config.txt]
2026-04-13 [fix] :Fixed the issue of old action data not being cleared properly during the motion learning process when learning new actions
    [MotionManager.cpp]
2026-04-14 [fix] (camera): resolve crash caused by unsafe queue reset and handle no-background detection case
2026-04-14 [refactor]: remove legacy cpp/hpp files and clean up project structure
    [servo_config.txt]
2026-04-14 [fix](motion): resolve issue where learning mode could not exit correctly after being triggered by mistake
    [MotionManager.cpp]
2026-04-14 [fix](ui): resolve keyboard display issue; feat: add stop button (signal handling pending)
2026-04-14 [feat](supervisor): introduce task-level monitoring and logging pipeline
    - Added Supervisor module for centralized task tracking
    - Embedded TaskMonitor into executor layer for event collection
    - Measured task execution latency (STARTED → FINISHED)
    - Persisted logs for offline analysis and debugging
    - Initial integration completed with Camera module
    Next steps:
    - Extend monitoring to Motion and Speaker executors
    - Enable feedback loop from logs to Motion module for adaptive grasping
    [log.csv]
2026-04-14 [refactor](brain, supervisor): move camera feedback handling to supervisor
    - Removed voice feedback logic for camera detection from Brain module
    - Feedback will now be handled centrally in Supervisor based on task results
2026-04-15 [feat] enhance supervisor result structure and NLU logging - Add `isSuccessful` flag for task status tracking - Extend result types with NLU outputs - Introduce TESTMODE macro (temporary, will move t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
    [log.csv]
2026-04-15 [feat](speaker): add latency test and fix logging format
    - Added speaker module test to measure latency from task dispatch to successful buffering on hardware
    - Updated output text format to avoid commas interfering with log parsing
    [log.csv]
2026-04-15 [feat] add latency profiling for microphone processing
    [log.csv]
2026-04-15 [fix]resolve missing log recording issue in camera module
2026-04-15 [refactor] initialize servo from config instead of hardcoded setup [chore] remove unnecessary motion documentation [chore] defer motion_stop feature to prioritize system stability
    [MotionManager.cpp, PwmBoardController.cpp]
2026-04-15 [feat] add end-to-end latency measurement for motion pipeline - Introduced latency profiling between Screen input and Motion task dispatch - Measures time from user interaction (UI callback triggered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
2026-04-15 chore: update test logs (ongoing maintenance)
    [log.csv]
2026-04-15 [feat] add hand control, object-triggered motion, and internal motion support
    - Added configuration and signal integration for robotic hand
    - Introduced post-detection pipeline after camera object recognition
    - Added internal motion sets to improve interaction stability
    [servo_config.txt]
2026-04-16 20260415 log and analysis
    [20260415_log.csv, Analysis.xlsx]
2026-04-16 feat(system): introduce startup diagnostics & fault tolerance
    - add self-check during system initialization
    - prevent crash on Motion init failure
    - handle Mic/Speaker device busy scenarios gracefully
    - improve error visibility with structured error codes
    see README for error code definitions and resolutions (upcoming)
    closes #15
    [MotionManager.cpp]
2026-04-16 [style] :Update config file path
    [camera_config.txt]
2026-04-16 [style] :Update STL file path and IK docs
    [EBAmk2_001_base.STL, EBAmk2_002_mainarm.STL, EBAmk2_003_varm.STL, EBAmk2_004_link135.STL, EBAmk2_005_link135angled.STL, EBAmk2_006_horarm__.STL, EBAmk2_006_horarm_plate.STL, EBAmk2_007_trialink.STL]
2026-04-16 [docs] update daily logs
    [log.csv]
2026-04-16 feat: integrate camera-based object detection with motion execution closes #1
    - Added pipeline from object detection to motion triggering
    - Implemented pixel-to-3D coordinate mapping
    - Introduced predefined motion sets based on spatial position
    - Added new preset motion group
    Limitations:
    - No depth camera, object depth is approximated
    - Mechanical arm lacks precise calibration
    - IK currently unreliable, using predefined motions as fallback
    [camera_config.txt]
2026-04-16 fix: adjust hand configuration to prevent continuous heating
    - Updated hand-related parameters in config
    - Fixed issue where the hand servo remained active and overheated due to incorrect settings
    [servo_config.txt]
2026-04-16 fix: refine camera detection region to improve coverage
    - Adjusted camera detection configuration
    - Reduced excessive edge masking that limited detection range
2026-04-16 20260416 log and analysis #13
    [20260416_log.csv, Analysis.xlsx]
2026-04-17 feat(test): add standalone module testing framework and improvements closes #10
    - Added single-module testing support; modules are now decoupled and can run independently
    - Introduced system_config.cpp for configuring test modes
    - Improved RobotBrain logic to prevent invalid pointer access during isolated testing
    - Added speaker_test.txt for standalone Speaker module testing
    - Enables text-based test input
    - Uses sleep to isolate model processing time from queue waiting latency
    - Added independent test logs for different modules
    See README for detailed testing instructions
    [log.csv, log_cameratest.csv, log_microphonetest.csv, log_motiontest.csv, log_speakertest.csv]
2026-04-17 feat: add semantic-text mapping and refactor feedback pipeline #9, #11
    - Added mapping between semantic intents and text responses
    - Introduced Chinese text entries to support future multilingual expansion
    - Refactored speaker feedback logic:
    - Moved camera-related feedback handling to Supervisor module
    - Deferred motion_set feedback migration for future updates
2026-04-17 [docs] daily test log
    [log.csv]
2026-04-17 [docs]20260417 log and analysis #13
    [20260417_log.csv]
2026-04-18 feat(config): improve config UI and add basic localization support close #3
    - Enhanced config interface to allow editing hostname and robot name
    - UI does not yet support real-time refresh; currently refreshes by returning to home screen
    - Added preliminary support for future multi-language functionality
2026-04-18 [feat](speaker): add preloading and runtime caching for TTS close #2
    - Introduce internal phrase preloading and dynamic caching mechanism
    - significantly reduce inference latency for fixed and repeated sentences
    [log_speakertest.csv]
2026-04-18 refactor: optimize microphone architecture and add internal Vosk worker #8
    - added a dedicated internal Vosk thread to process queued audio data
    - fixed delayed processing issues under continuous speech input
    - prepared the microphone module for future optimization and heavier ASR models
2026-04-18 fix(motion): fix learning mode exit and empty motionset save bug close #17
    - Fixed an issue where motion learning mode could not exit properly
    - Fixed abnormal system behavior when saving an empty motionset
    [MotionManager.cpp]
2026-04-18 [docs] update daily log
    [log.csv, log_microphonetest.csv, log_motiontest.csv, log_speakertest.csv]
2026-04-18 refactor(log): standardize console output prefixes #7 - Updated non-compliant console messages - Use [Init] for startup initialization - Use [Info] for runtime process messages - Use [Error] for erro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
    [MotionManager.cpp]
2026-04-19 feat(brain): add text command handling for reset and update
    - Brain can now directly parse "reset" and "update" commands for arm reset and background update
2026-04-19 fix(speaker): add error handling to address unexpected interruption #19
    - Added error handling in speaker module to diagnose and mitigate unexpected interruption issues
    - expand unit test texts but no issues found
2026-04-19 [fix] speaker: #19 -Removed built-in text filtering logic; all text is now cached automatically, trading increased memory usage for improved response time.
    -Adjusted the mutex scope to prevent new tasks from being received while PCM data is being generated, which could otherwise cause the speaker module to crash.
2026-04-19 [docs] update daily test logs
    [log.csv, log_speakertest.csv]
2026-04-19 [docs] update docs
    [overall.xlsx]
2026-04-19 upload 3mf model files for hardware
    [EBAmk2_001_base.3mf, EBAmk2_002_mainarm.3mf, EBAmk2_003_varm.3mf, EBAmk2_004_link135.3mf, EBAmk2_005_link135angled.3mf, EBAmk2_006_horarm__.3mf, EBAmk2_006_horarm_plate.3mf, EBAmk2_007_trialink.3mf]
2026-04-19 remove incorrectly uploaded 3mf files
    [EBAmk2_001_base.3mf, EBAmk2_002_mainarm.3mf, EBAmk2_003_varm.3mf, EBAmk2_004_link135.3mf, EBAmk2_005_link135angled.3mf, EBAmk2_006_horarm__.3mf, EBAmk2_006_horarm_plate.3mf, EBAmk2_007_trialink.3mf]
2026-04-20 [docs]update readme for V2.0
    [hardware.xlsx]
2026-04-20 docs:Analysis and log for 20260417 #13
    [Analysis.xlsx]
2026-04-20 [docs] update daily test log
    [log.csv]
2026-04-20 [docs:]add 3D printing .3mf project files
    [EBAmk2.3mf]
2026-04-20 [docs] add technical documentation
    [Memory_Management.xlsx, SOLID_Analyze.xlsx, Sleep_Analyze.xlsx, System_Architecture.xlsx, Thread_Analyze.xlsx, overall.xlsx]
2026-04-20 [chore] remove unnecessary and accidentally uploaded directories
    [EBAmk2_001_base.STL, EBAmk2_002_mainarm.STL, EBAmk2_003_varm.STL, EBAmk2_004_link135.STL, EBAmk2_005_link135angled.STL, EBAmk2_006_horarm__.STL, EBAmk2_006_horarm_plate.STL, EBAmk2_007_trialink.STL]
2026-04-20 [docs] add future_architecture chart
    [Future_Architecture.xlsx]
2026-04-20 [docs]move test/ to docs/test_data/, add Latency Testing in TEST.md, add new log analysis in Analysis.xlsx
    [20260415_log.csv, 20260416_log.csv, 20260417_log.csv, Analysis.xlsx, daily_raw_log.csv, log_cameratest.csv, log_microphonetest.csv, log_motiontest.csv]
2026-04-20 [docs] Delete data from the test folder for user use
    [20260415_log.csv, 20260416_log.csv, 20260417_log.csv, Analysis.xlsx, log.csv, log_cameratest.csv, log_microphonetest.csv, log_motiontest.csv]
2026-04-20 [docs]updated new Nlu test data analysis
    [Analysis.xlsx]
2026-04-20 [docs]slight change in line switch
